AntonioMR/tessera-hw/README.md

<p align="center" width="100%">
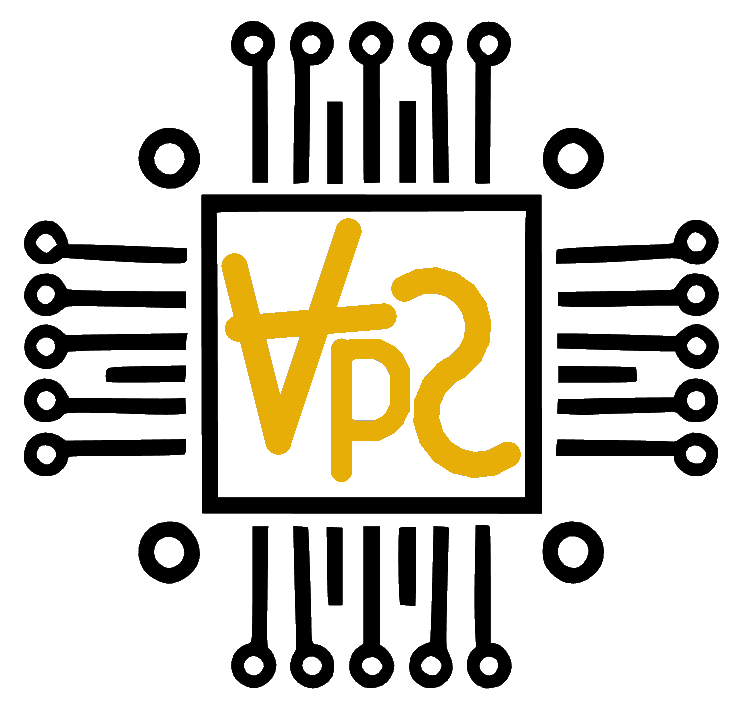
[picture p1: Logos/logo.png]
  
</p>

<h1 align="center">Tessera Badge</h1>

<p align="center" width="100%">
  <a href="https://github.com/AntonioMR/tessera-hw/actions/workflows/ci.yaml">
    
  </a>
</p>

<p align="center" width="100%">
    
</p>

***

<p align="center">
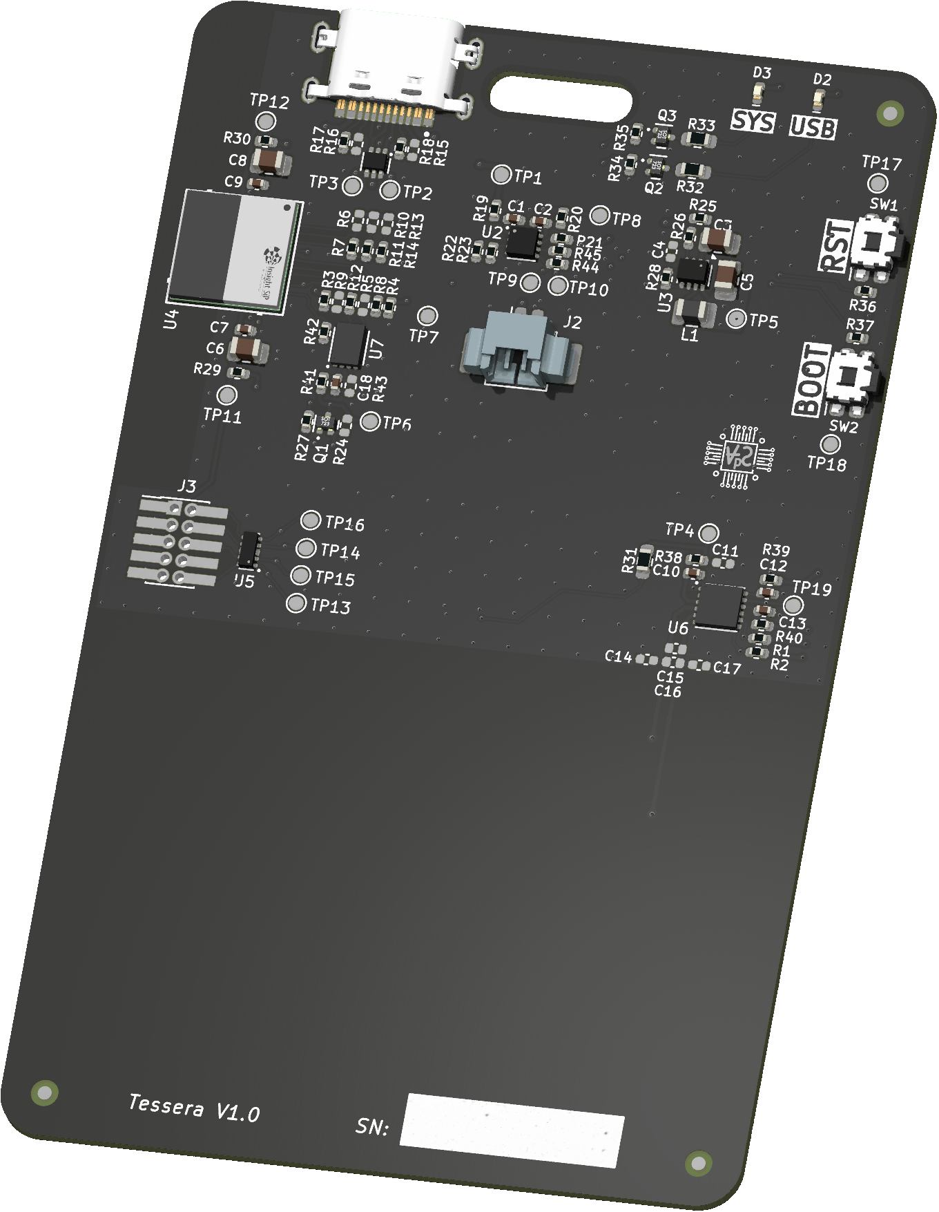
[picture p2: Images/tessera-angled_top.png]
3D Top Angled
  
&nbsp; &nbsp; &nbsp; &nbsp;
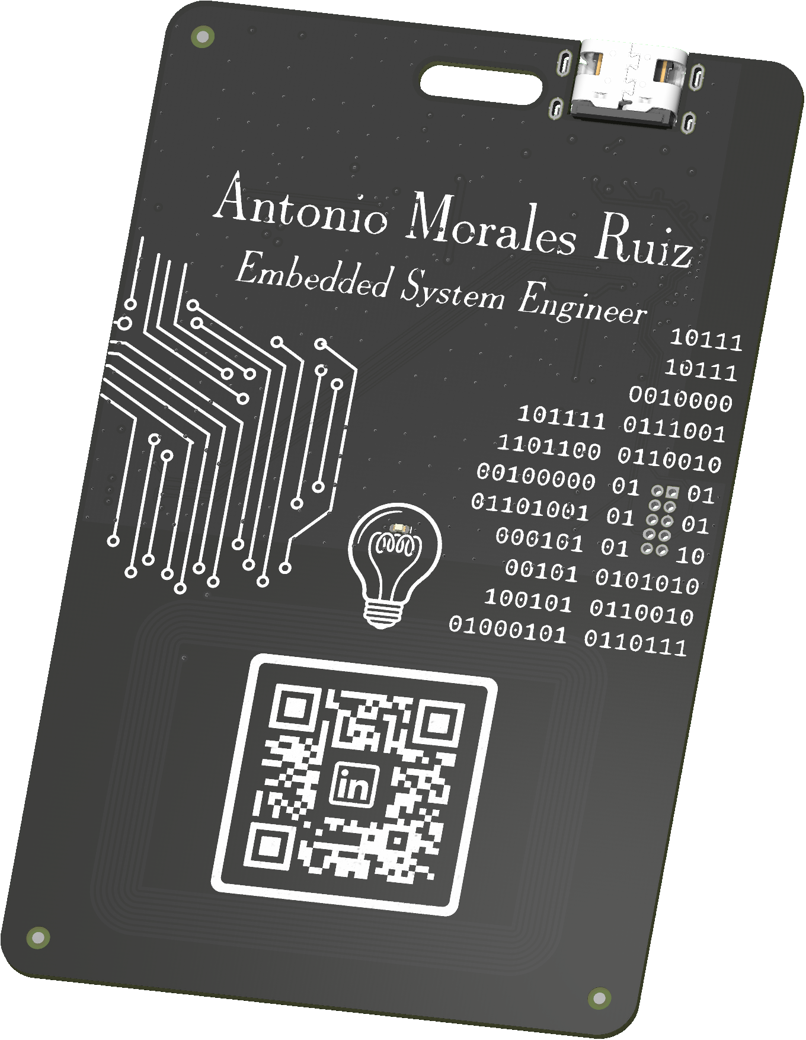
[picture p3: Images/tessera-angled_bottom.png]
3D Bottom Angled
  
</p>

***

## SPECIFICATIONS

| Parameter | Value | 
| --- | --- |
| Dimensions | 54.0 × 85.61 mm |

***

## DIRECTORY STRUCTURE

    .
    ├─ Computations       # Misc calculations
    ├─ HTML               # HTML files for generated webpage
    ├─ Images             # Pictures and renders
    │
    ├─ kibot_resources    # External resources for KiBot
    │  ├─ colors          # Color theme for KiCad
    │  ├─ fonts           # Fonts used in the project
    │  ├─ scripts         # External scripts used with KiBot
    │  └─ templates       # Templates for KiBot generated reports
    │
    ├─ kibot_yaml         # KiBot YAML config files
    ├─ KiRI               # KiRI (PCB diff viewer) files
    │
    ├─ lib                # KiCad footprint and symbol libraries
    │  ├─ lib_fp          # Footprint libraries
    │  ├─ lib_packages3d  # Component 3D models
    │  └─ lib_sym         # Symbol libraries
    │
    ├─ Logos              # Logos
    │
    ├─ Manufacturing      # Assembly and fabrication documents
    │  ├─ Assembly        # Assembly documents (BoM, pos, notes)
    │  │
    │  └─ Fabrication     # Fabrication documents (ZIP, notes)
    │     ├─ Drill Tables # CSV drill tables
    │     └─ Gerbers      # Gerbers
    │
    ├─ Report             # Reports for ERC/DRC
    ├─ Schematic          # PDF of schematic
    ├─ Templates          # Title block templates
    ├─ Testing
    │  └─ Testpoints      # Testpoints tables      
    │
    └─ Variants           # Outputs for assembly variants
