AntonioMR/tessera-hw/kibot_resources/templates/readme.txt

<p align="center" width="100%">
  
</p>

<h1 align="center">${BOARD_NAME}</h1>

<p align="center" width="100%">
  <a href="${GIT_URL}/actions/workflows/ci.yaml">
    CI Badge
  </a>
</p>

<p align="center" width="100%">
    
</p>

***

<p align="center">
  3D Top Angled
&nbsp; &nbsp; &nbsp; &nbsp;
  3D Bottom Angled
</p>

***

## SPECIFICATIONS

| Parameter | Value | 
| --- | --- |
| Dimensions | ${bb_w_mm} × ${bb_h_mm} mm |

***

## DIRECTORY STRUCTURE

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
