AntonioMR/tessera-hw/HTML/images/cat_pdf_drill_map_tessera-NPTH_drill_map.png

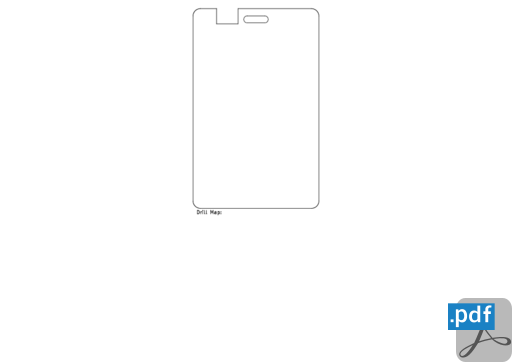
HTML/images/cat_pdf_drill_map_tessera-NPTH_drill_map.png
