AntonioMR/tessera-hw/HTML/images/cat_pdf_drill_map_tessera-PTH_drill_map.png

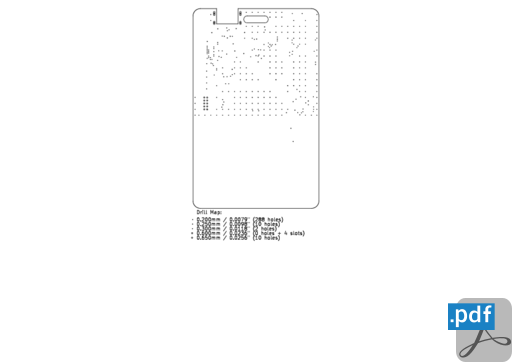
HTML/images/cat_pdf_drill_map_tessera-PTH_drill_map.png
