AntonioMR/tessera-hw/HTML/images/cat_pdf_schematic_tessera-schematic.png

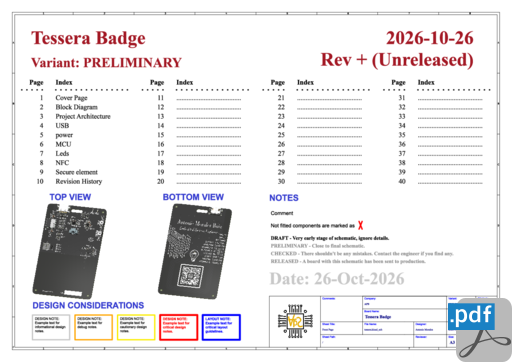
HTML/images/cat_pdf_schematic_tessera-schematic.png
