AntonioMR/tessera-hw/HTML/images/cat_png_3d_viewer_bottom_tessera-bottom.png

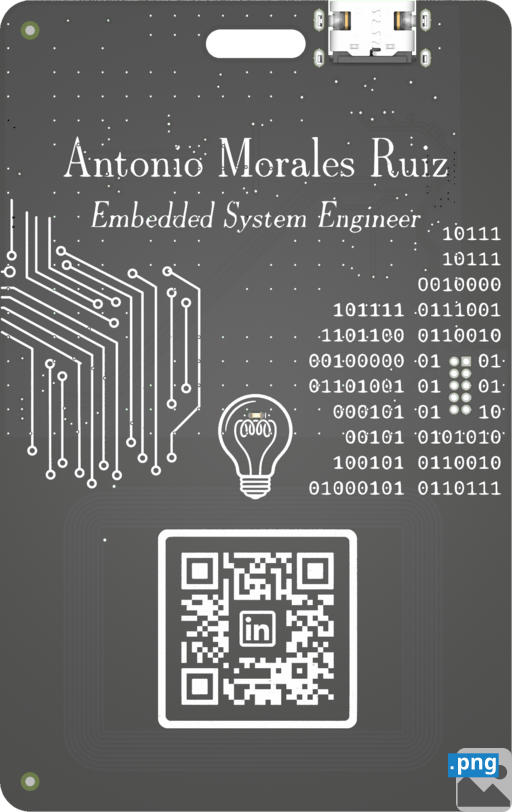
HTML/images/cat_png_3d_viewer_bottom_tessera-bottom.png
