AntonioMR/tessera-hw/HTML/images/cat_png_3d_viewer_top_tessera-top.png

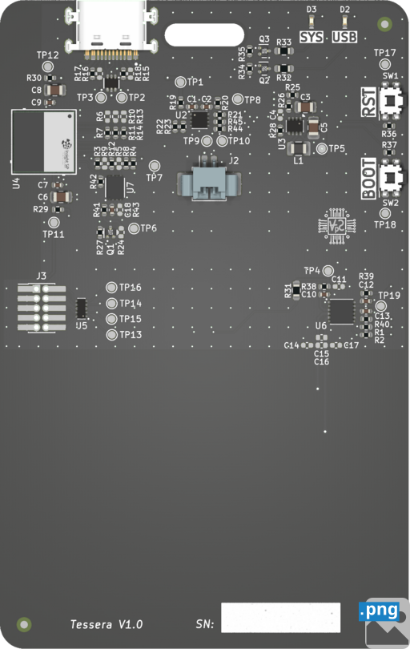
HTML/images/cat_png_3d_viewer_top_tessera-top.png
