AntonioMR/tessera-hw/Images/tessera-top.png

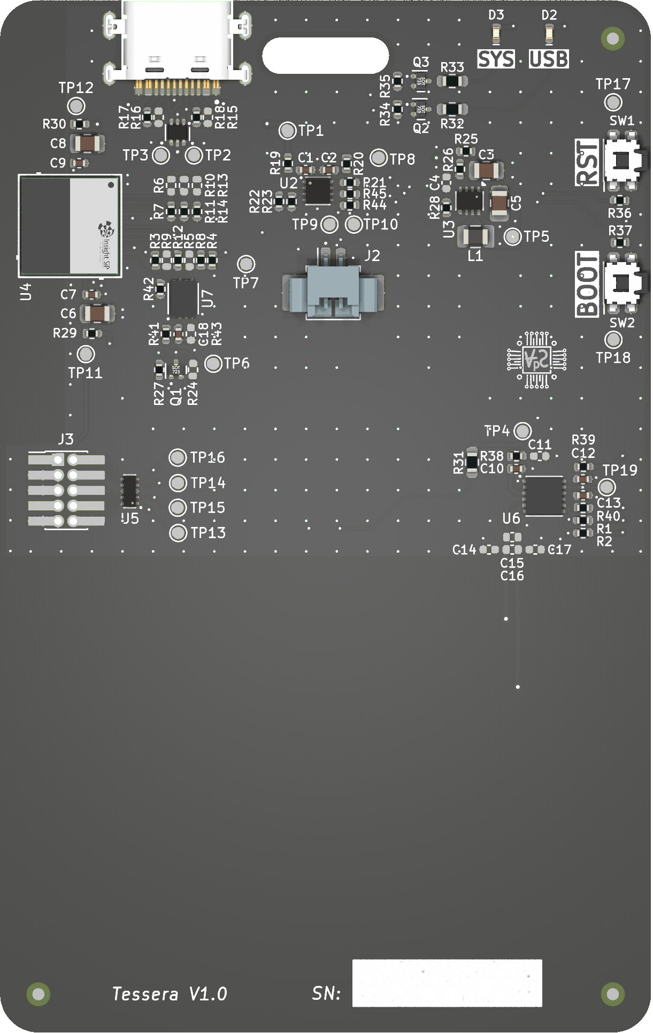
Images/tessera-top.png
