AntonioMR/tessera-hw/Manufacturing/Assembly/tessera-bom.csv

Row | Quantity Per PCB | IPN | References | Value | Datasheet | Footprint | Description | Manufacturer | Manufacturer Part Number | Supplier Part Number
1 | 5 | IPN_C-0001 | C7 C9 C12 C13 C18 | 100nF 16V (X7R) |  | C_0402_1005Metric | CAP CER 0.1UF 16V X7R 0402 | KEMET | C0402C104K4RACTU
2 | 1 | IPN_C-0002 | C10 | 10nF 16V (X7R) |  | C_0402_1005Metric | CAP CER 10000PF 16V X7R 0402 | KEMET | C0402C103K4RACTU
3 | 3 | IPN_C-0007 | C5 C6 C8 | 10uF 10V (X7R) |  | C_0805_2012Metric | CAP CER 10UF 10V X7R 0805 | KEMET | C0805C106K8RAC3123
4 | 2 | IPN_C-0008 | C1 C2 | 1uF 6.3V (X5R) |  | C_0402_1005Metric | CAP CER 1UF 6.3V X5R 0402 | KEMET | C0402C105K9PACTU
5 | 1 | IPN_C-0006 | C3 | 4.7uF 6.3V (X7R) |  | C_0805_2012Metric | CAP CER 4.7UF 6.3V X7R 0805 | KEMET | C0805C475K9RACTU
6 | 3 | IPN_D-0001 | D1 D2 D3 | APHHS1005SURCK | http://www.kingbrightusa.com/images/catalog/spec/aphhs1005surck.pdf | LED_0402_1005Metric | Hyper Red (AlGaInP) 0402 SMD chip LED | Kingbright | APHHS1005SURCK
7 | 1 | IPN_J-0001 | J2 | 532610271 | https://www.molex.com/content/dam/molex/molex-dot-com/products/automated/en-us/salesdrawingpdf/532/53261/532610271_sd.pdf | Molex_PicoBlade_53261-0271_1x02-1MP_P1.25mm_Horizontal | Molex_PicoBlade_53261-0271_1x02-1MP_P1.25mm_Horizontal | Molex | 532610271
8 | 1 | IPN_J-0003 | J1 | USB-C | https://gct.co/files/specs/usb4520-spec.pdf | GCT_USB4520-03-1-A_REVA | USB C REC 16P 3U MID MNT 2.1MM | GCT | USB4520-03-1-A
9 | 1 | IPN_L-0001 | L1 | 2.2uH | https://pim.murata.com/asset/pim4/inductor/J(E)TE243A-0006_PDF_INDUCTOR | L_0806_2016Metric | FIXED IND 2.2UH 1.8A 116 MOHM | Murata Electronics | DFE201612E-2R2M=P2
10 | 2 | IPN_Q-0001 | Q2 Q3 | NTK3134N | https://www.onsemi.com/pdf/datasheet/ntk3134n-d.pdf | SOT-723 | small-signal N-channel MOSFET with integrated ESD protection | onsemi | NTK3134N
11 | 1 | IPN_Q-0002 | Q1 | NTK3139P | https://www.onsemi.com/pdf/datasheet/ntk3139p-d.pdf | SOT-723 | small-signal P-channel MOSFET with integrated ESD protection | onsemi | NTK3139P
12 | 3 | IPN_R-0008 | R31 R32 R33 | 330R ±1% 1/10W |  | R_0603_1608Metric | RES 330 OHM 1% 1/10W 0603 | YAGEO | RT0603FRE07330RL
13 | 2 | IPN_R-0003 | R17 R18 | 5.1 kOhms |  | R_0402_1005Metric | RES 5.1K OHM 1% 1/16W 0402 | YAGEO | RT0402FRE075K1L
14 | 5 | IPN_R-0002 | R1 R2 R3 R4 R23 | 10 kOhms |  | R_0402_1005Metric | RES 10K OHM 1% 1/16W 0402 | YAGEO | AT0402FRD0710KL
15 | 1 | IPN_R-0004 | R21 | 27 kOhms |  | R_0402_1005Metric | RES 27K OHM 1% 1/16W 0402 | YAGEO | RT0402FRE0727KL
16 | 1 | IPN_R-0005 | R22 | 30 kOhms |  | R_0402_1005Metric | RES 30K OHM 1% 1/16W 0402 | YAGEO | RT0402FRE0730KL
17 | 1 | IPN_R-0006 | R28 | 52.3 kOhms |  | R_0402_1005Metric | RES 52.3K OHM 1% 1/16W 0402 | YAGEO | RT0402FRE0752K3L
18 | 4 | IPN_R-0001 | R27 R42 R44 R45 | 100 kOhms |  | R_0402_1005Metric | RES 100K OHM 1% 1/16W 0402 | YAGEO | RP0402FRE07100KL
19 | 7 | IPN_R-0009 | R7 R11 R14 R34 R35 R36 R37 | 510 kOhms |  | R_0402_1005Metric | RES 510K OHM 1% 1/16W 0402 | YAGEO | RC0402FR-13510KL
20 | 12 | IPN_R-0010 | R8 R12 R19 R20 R25 R26 R29 R30 R38 R39 R40 R41 | 0R ±5% 1/16W |  | R_0402_1005Metric | RES 0 OHM JUMPER 1/16W 0402 | YAGEO | RC0402FR-070RL
21 | 2 | IPN_SW-0001 | SW1 SW2 | EVQP7A01P | https://www.tti.com/content/dam/tti-commons/supplier/panasonic/ecom/panasonic-3529s-side-series-datasheet.pdf | Panasonic_switch_EVQP7K_EVQP7A | Side-actuated SMD tactile switch | Panasonic | EVQP7A01P
22 | 1 | IPN_U-0003 | U2 | BQ25170J | https://www.ti.com/lit/gpn/BQ25170J | WSON-8-1EP_2x2mm_P0.5mm_EP0.9x1.6mm | 800 mA linear battery charger for 1-cell | Texas Instruments | BQ25170J
23 | 1 | IPN_D-0003 | U5 | D3V3XA4B10LP | https://www.diodes.com/assets/Datasheets/D3V3XA4B10LP.pdf | Diodes_UDFN-10_1.0x2.5mm_P0.5mm | 4 Channel Low Capacitance TVS Diode Array | Diodes | D3V3XA4B10LP
24 | 1 | IPN_U-0005 | U4 | ISP1807-LR-RS | https://www.insightsip.com/fichiers_insightsip/pdf/ble/ISP1807/isp_ble_DS1807.pdf | ISP1807-LR | Insight SiP ISP1807-LR nRF52840 BLE module | Insight SiP | ISP1807-LR
25 | 1 | IPN_U-0002 | U6 | ST25DV64KC-JF6D3 | https://www.st.com/resource/en/datasheet/st25dv64kc.pdf | ST_UFDFPN-12-1EP_3x3mm_P0.5mm_EP1.4x2.55mm | STMicroelectronics ST25DV64KC-JF6D3 -- dynamic NFC/RFID tag IC, 64-Kbit EEPROM, dual I2C / RF interface, energy harvesting | STMicroelectronics | ST25DV64KC-JF6D3
26 | 1 | IPN_U-0001 | U7 | STSAFA120DFSPL05 | https://www.st.com/resource/en/datasheet/stsafe-a120.pdf | ST_UFDFPN-8-1EP_2x3mm_P0.5mm_EP1.4x2.55mm | STMicroelectronics STSAFE-A120 -- secure authentication companion IC, I2C, 16 kB NVM, hashing/encryption/decryption crypto services | STMicroelectronics | STSAFA120DFSPL05
27 | 1 | IPN_U-0004 | U3 | TPS62840DLCR | https://www.ti.com/lit/gpn/TPS62840 | Texas_VSON-HR-8_1.5x2mm_P0.5mm | 750 mA IOUT, VSET-selectable output synchronous buck converter | Texas Instruments | TPS62840DLCR
28 | 1 | IPN_D-0002 | U1 | USBLC6-2P6 | https://www.st.com/resource/en/datasheet/usblc6-2.pdf | SOT-666 | Very low capacitance ESD protection array, 2 data lines + VBUS clamp, SOT-666 | STMicroelectronics | USBLC6-2P6
