AntonioMR/tessera-hw/Testing/Testpoints/tessera-testpoints-top.csv

Ref. | Net | X [mm] | Y [mm]
TP1 | VBUS | 20.68 | 71.60
TP2 | D- | 12.90 | 69.55
TP3 | D+ | 10.16 | 69.55
TP4 | VCC_EH | 40.17 | 46.70
TP5 | VCC | 39.34 | 62.81
TP6 | VCC_SEC | 14.52 | 52.28
TP7 | GND | 17.23 | 60.54
TP8 | VSYS | 28.23 | 69.37
TP9 | CHG_STAT | 24.14 | 63.82
TP10 | CHG_PG | 26.17 | 63.82
TP11 | VCC_nRF | 3.94 | 53.08
TP12 | VBUS_nRF | 3.14 | 73.65
TP13 | RST_PB | 11.60 | 38.24
TP14 | SWDCLK | 11.59 | 42.38
TP15 | SWDO | 11.56 | 40.34
TP16 | SWDIO | 11.56 | 44.49
TP17 | RST_PB | 47.68 | 73.96
TP18 | USR_PB | 47.70 | 54.27
TP19 | NFC_INT | 47.16 | 42.04
