AntonioMR/tessera-hw/3D/tessera.step

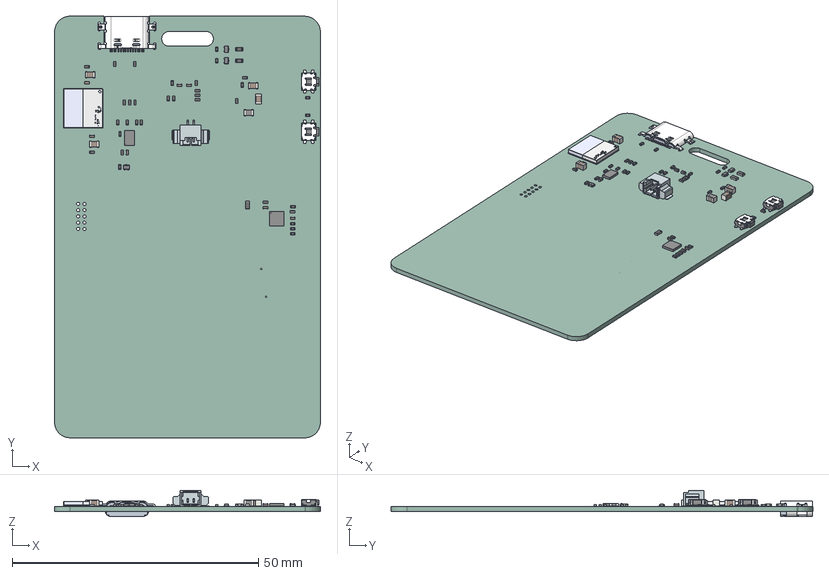
[picture p10: CAD file, 2026-10-26]
3D/tessera.step
54.0 x 85.6 x 5.30 mm
7095E2CA-307A-46B5-9DE8-1FEC977057C4 x 3
L_0805_2012Metric
EVQ-P7A01P x 2
C_0402_1005Metric x 8
R_0402_1005Metric x 33
532610271wbm000_03
F85B63AA-285C-4839-AD42-7CBB6340DD53
C_0805_2012Metric x 4
R_0603_1608Metric x 3
ST25DV64KC-JF6D3
USB4520-03-0-A
ISP1807-LR-RS
kibot_r0vd6m8w_PCB
