AntonioMR/tessera-hw/Manufacturing/Fabrication/tessera-fabrication.pdf

# Top Fabrication (Scale 1:1)

# Tessera Badge Fabrication Document

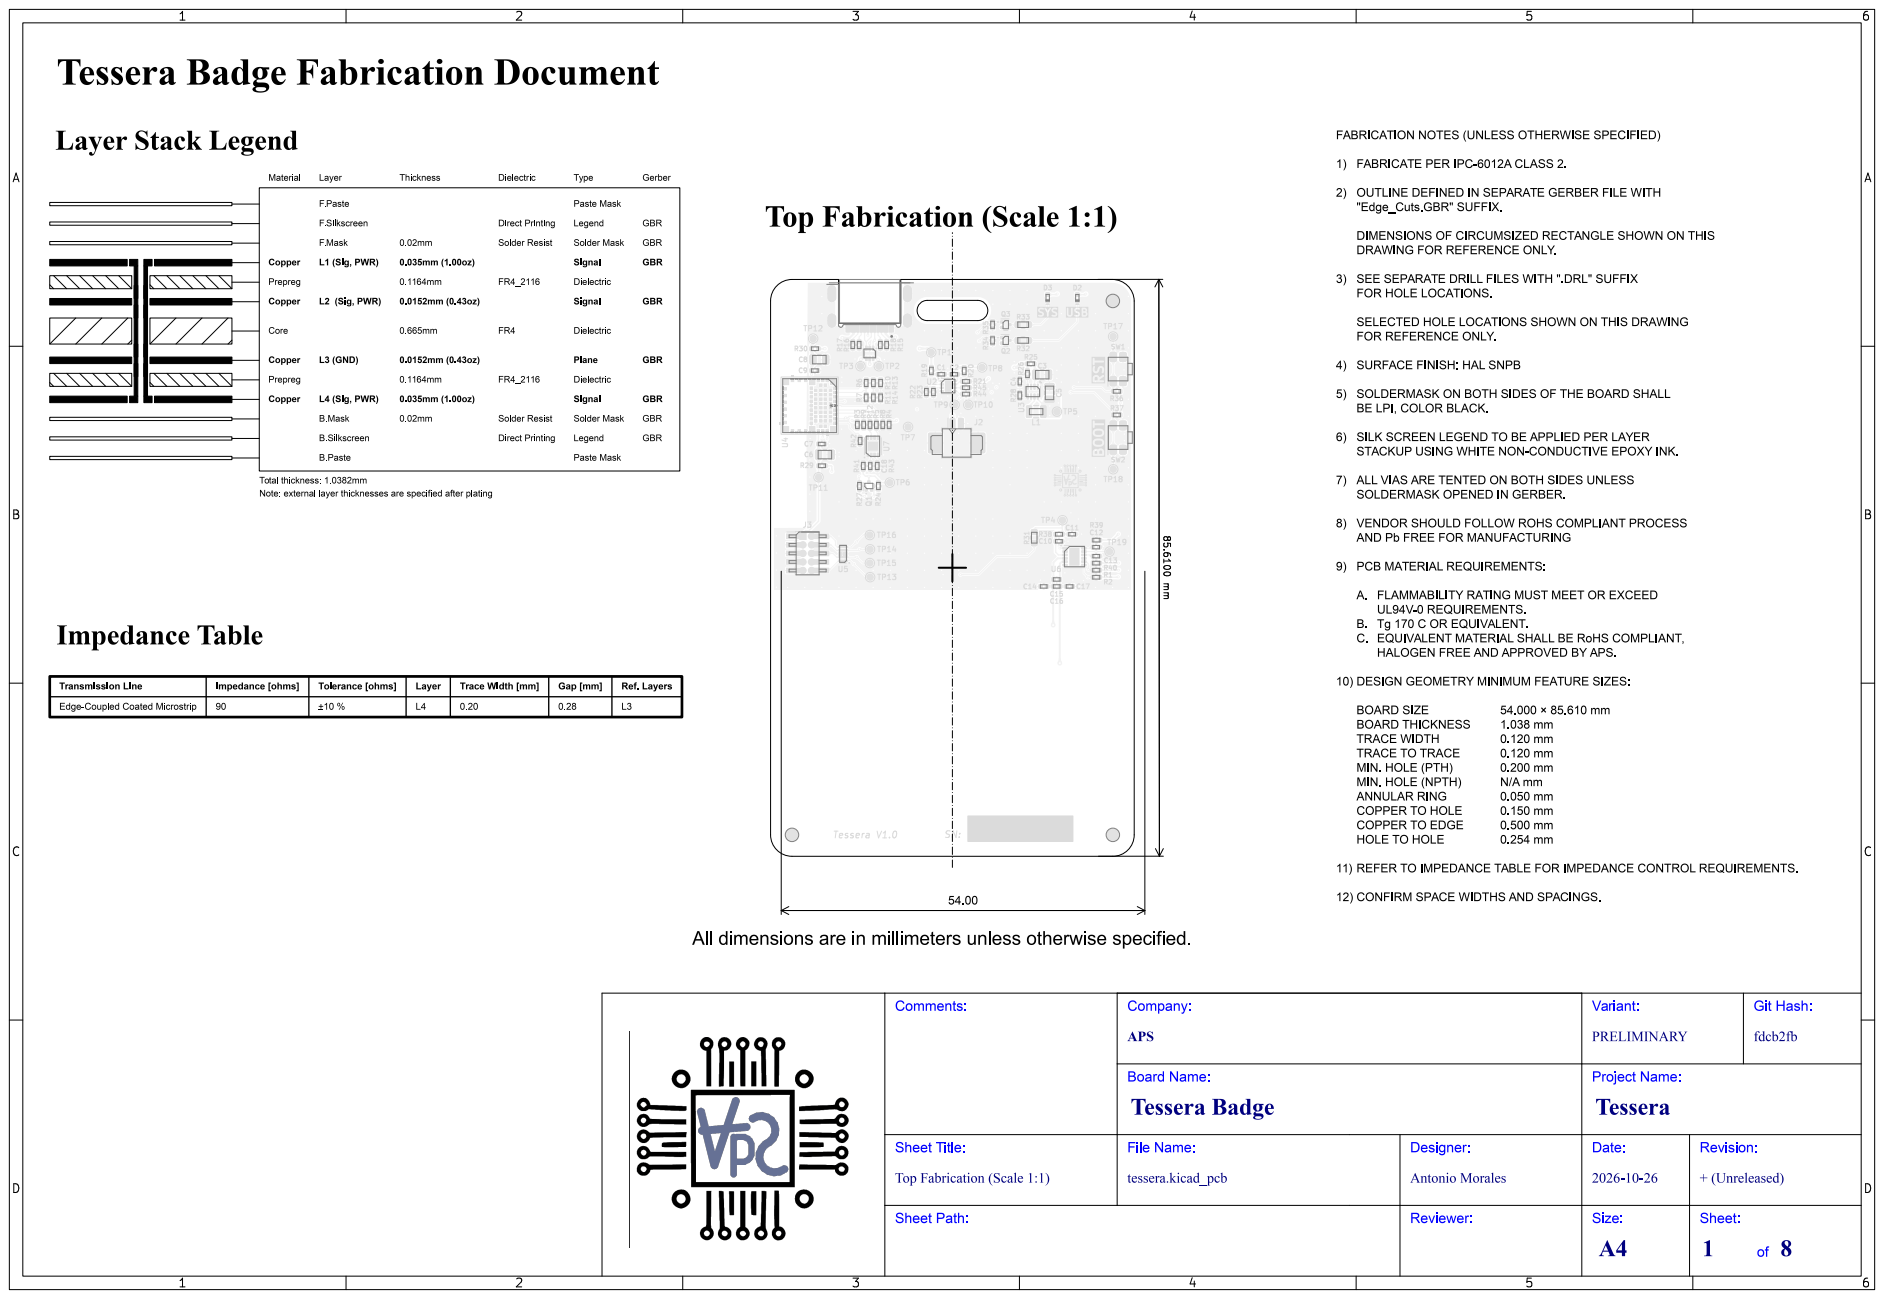
[picture p11: page 1]

# Bottom Fabrication (Scale 1:1)

# Tessera Badge Fabrication Document

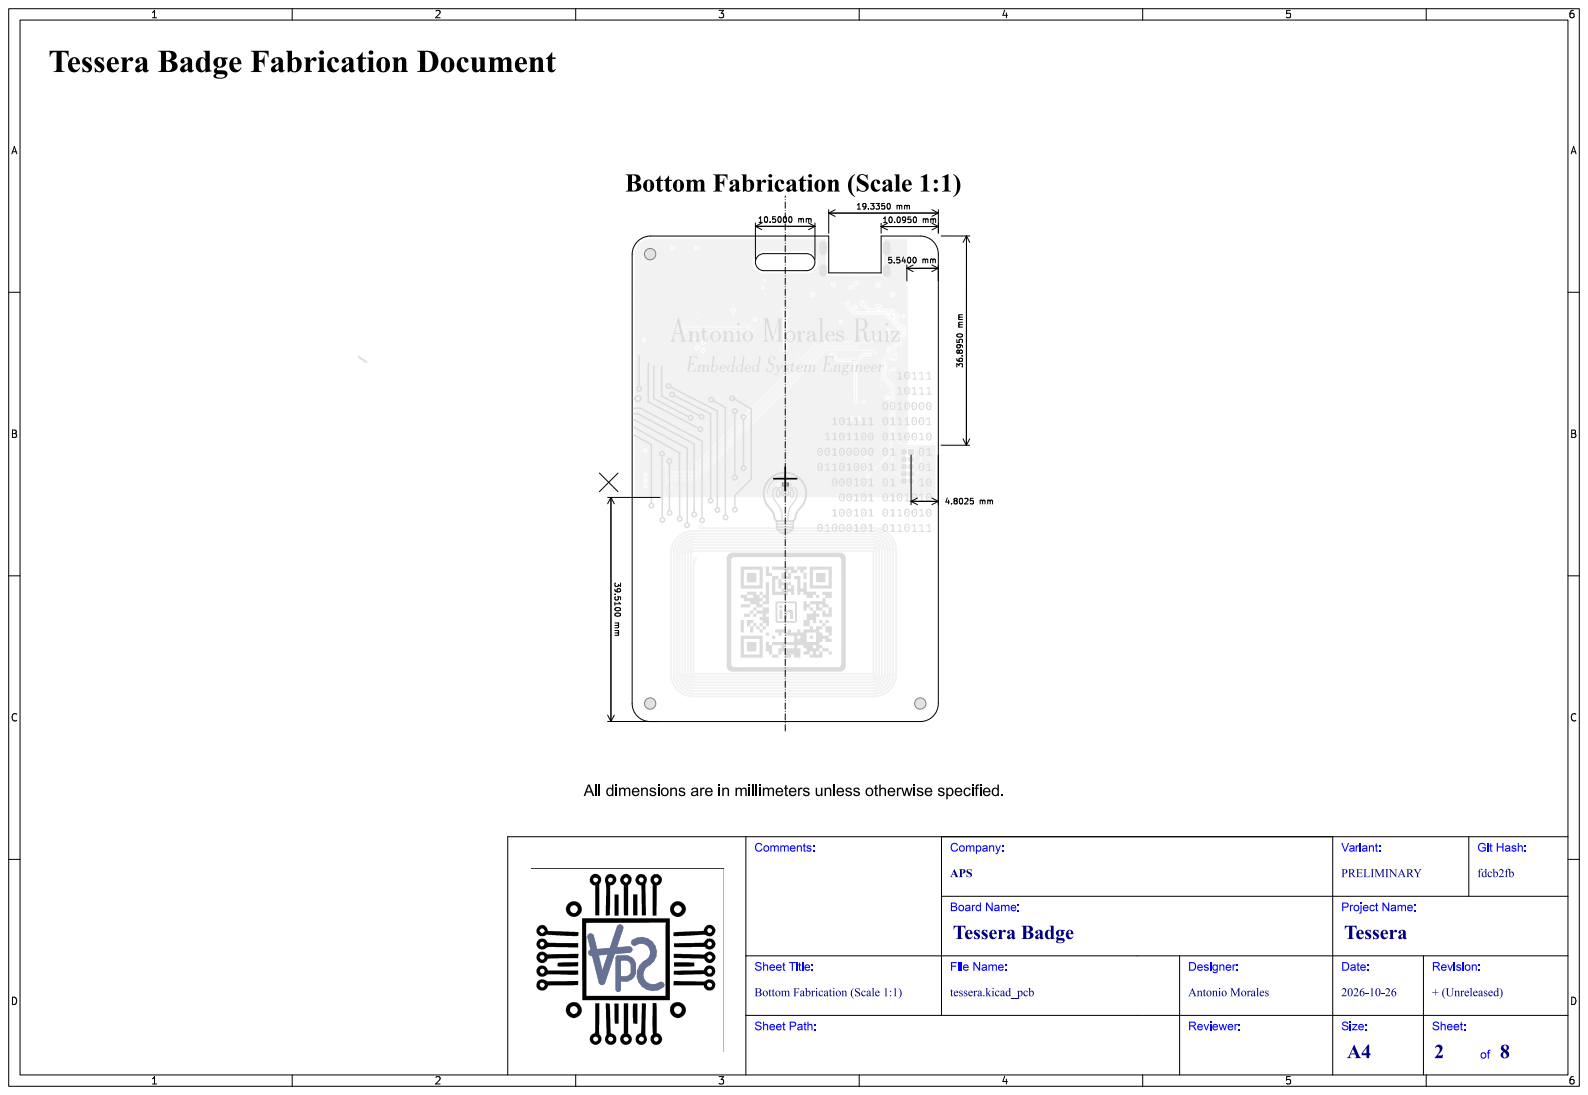
[picture p12: page 2]
Git; Hash:; fdcb2fb; Comments:; Sheet Path:; Sheet Title:; File Name:; Tessera Badge; Tessera; APS; Company:; PRELIMINARY; Variant:; Board Name:; tessera.kicad_pcb; Antonio Morales; Designer:; Reviewer:; Project Name:; Date:; + (Unreleased); Revision:; Size:; Sheet:

Bottom Fabrication (Scale 1:1)

# Drill Drawing L1 - L4 (Scale 1:1)

# Tessera Badge Fabrication Document

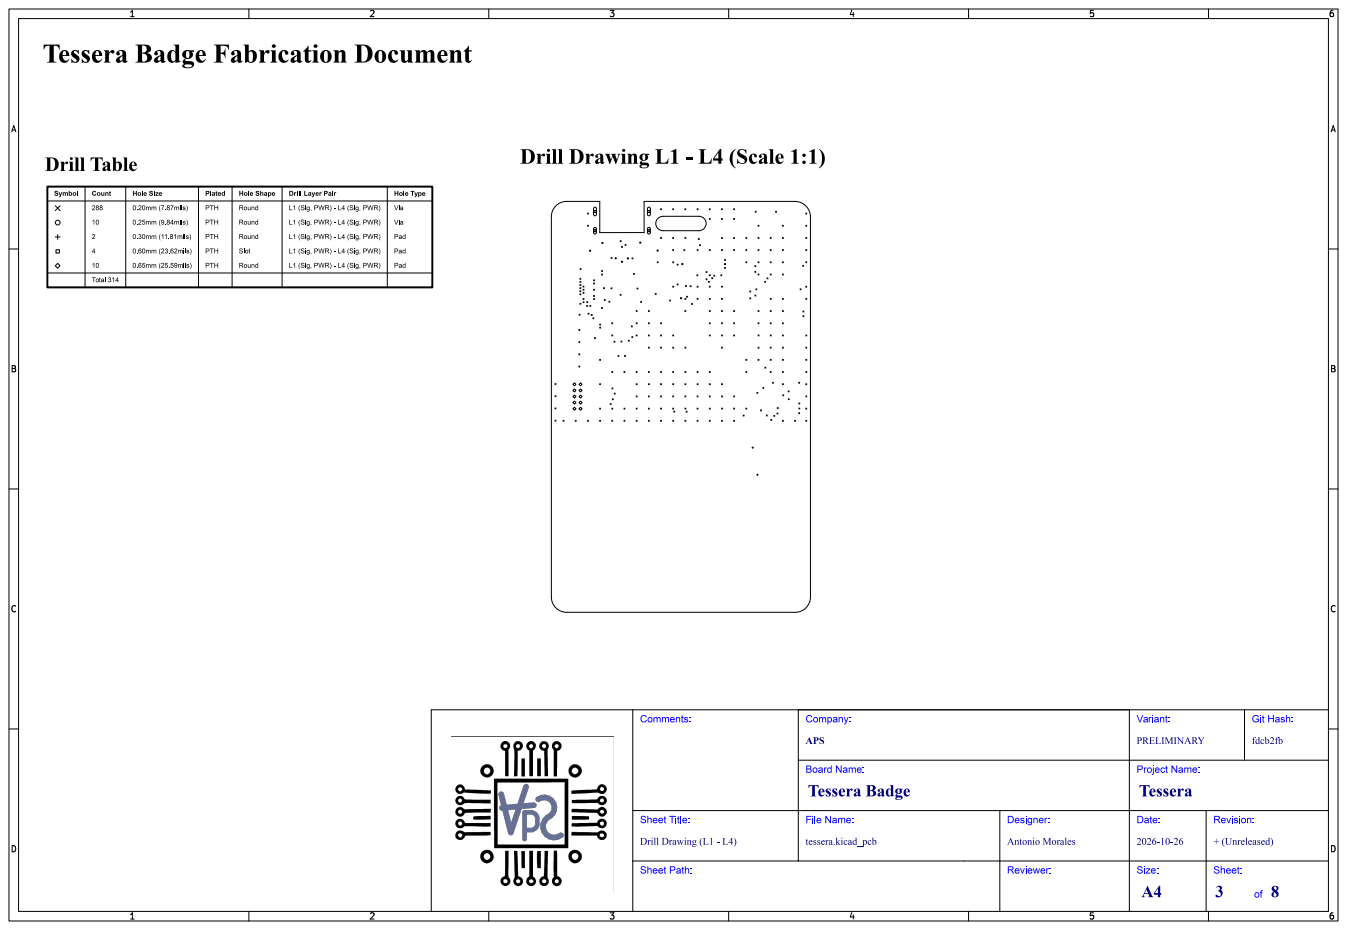
[picture p13: page 3]
Git; Hash:; fdcb2fb; Comments:; Drill Drawing (L1 - L4); Sheet Path:; Sheet Title:; File Name:; Tessera Badge; Tessera; APS; Company:; PRELIMINARY; Variant:; Board Name:; tessera.kicad_pcb; Antonio Morales; Designer:; Reviewer:; Project Name:; Date:; + (Unreleased); Revision:; Size:; Sheet:

# Top Test Points (Scale 1:1)

# Tessera Badge Fabrication Document

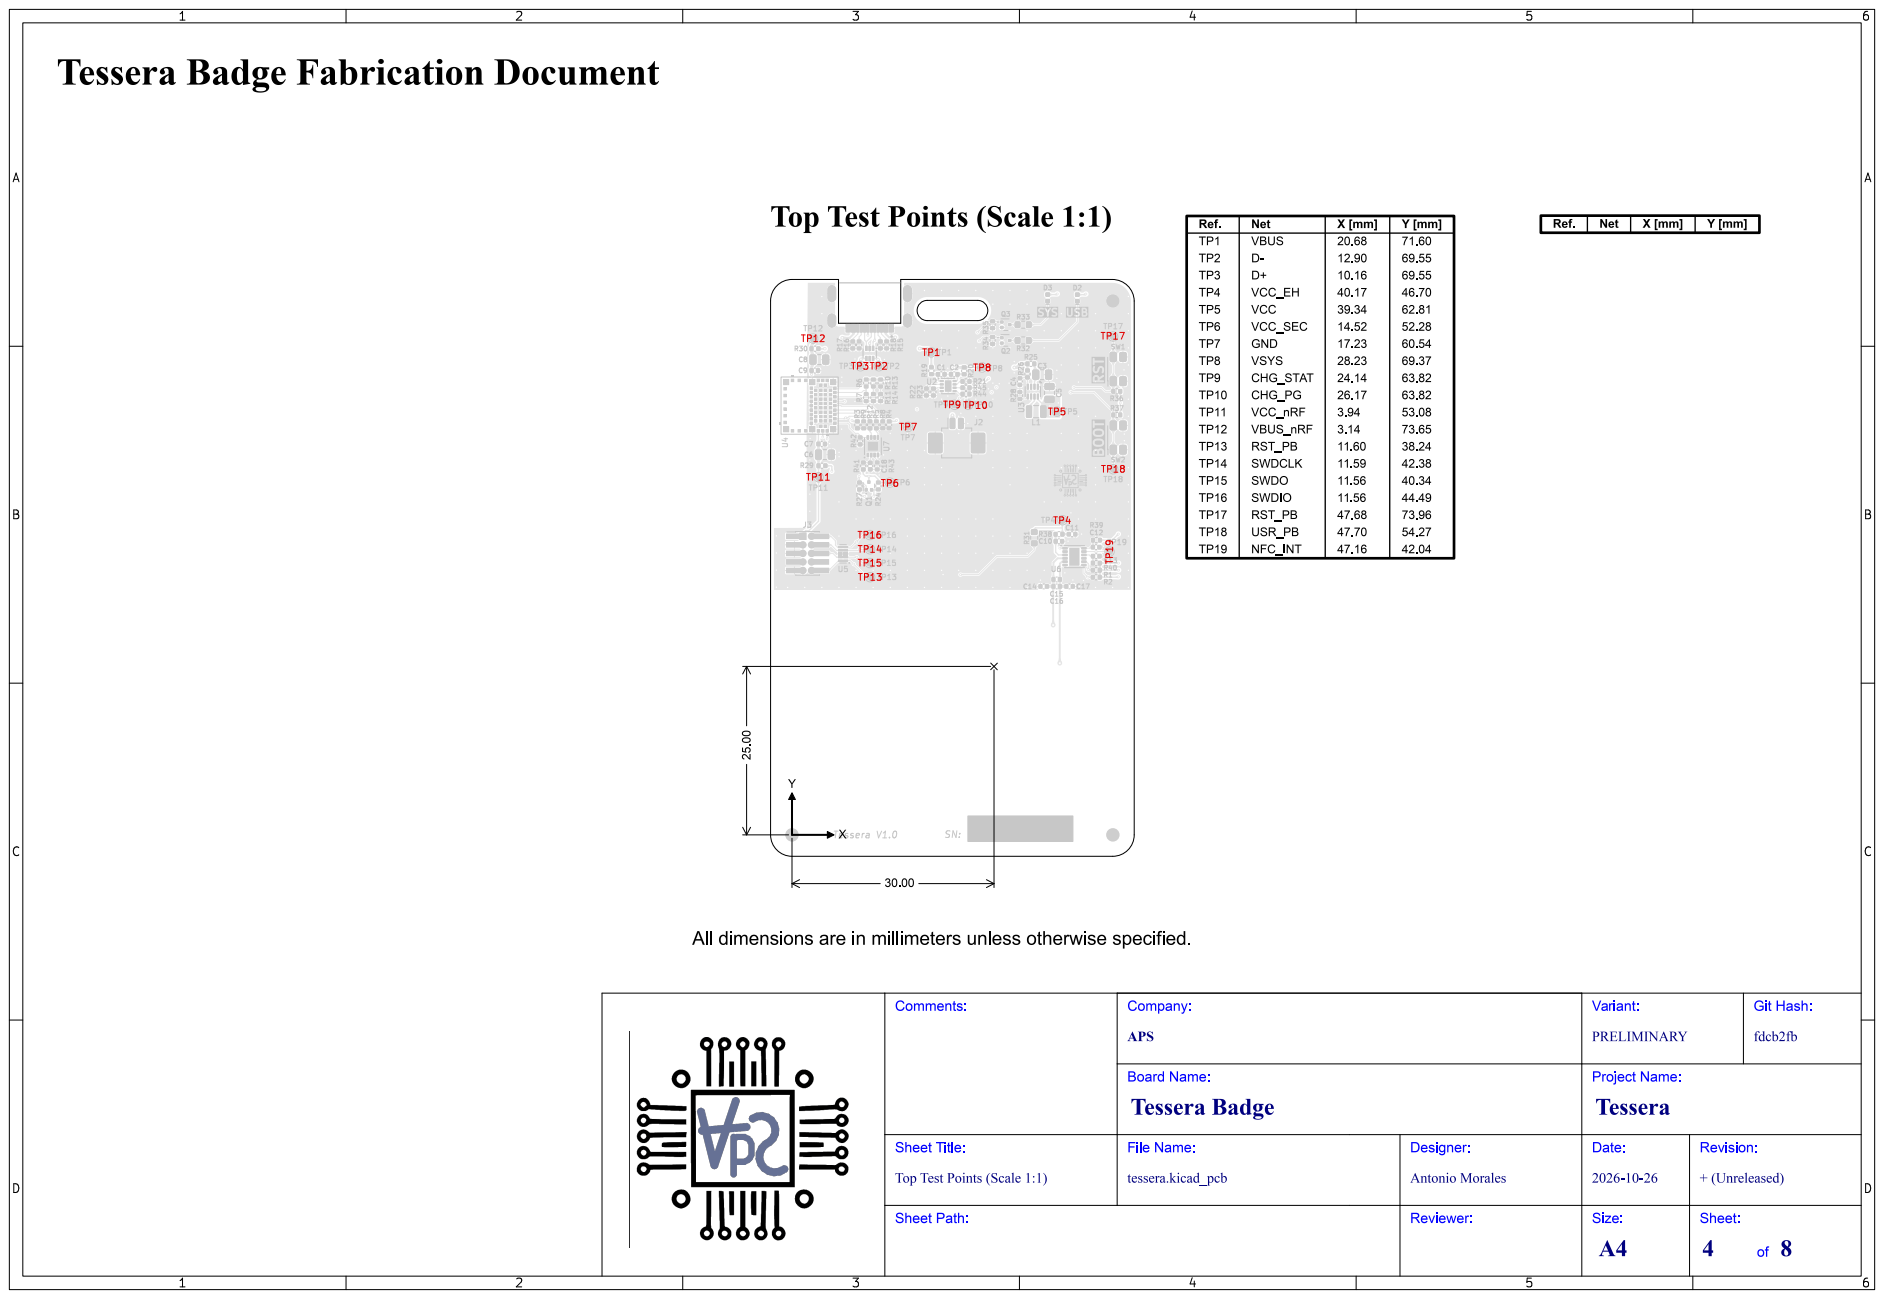
[picture p14: page 4]

Top Test Points (Scale 1:1)

# L1 (Sig, PWR) (Scale 1:1)

# Tessera Badge Fabrication Document

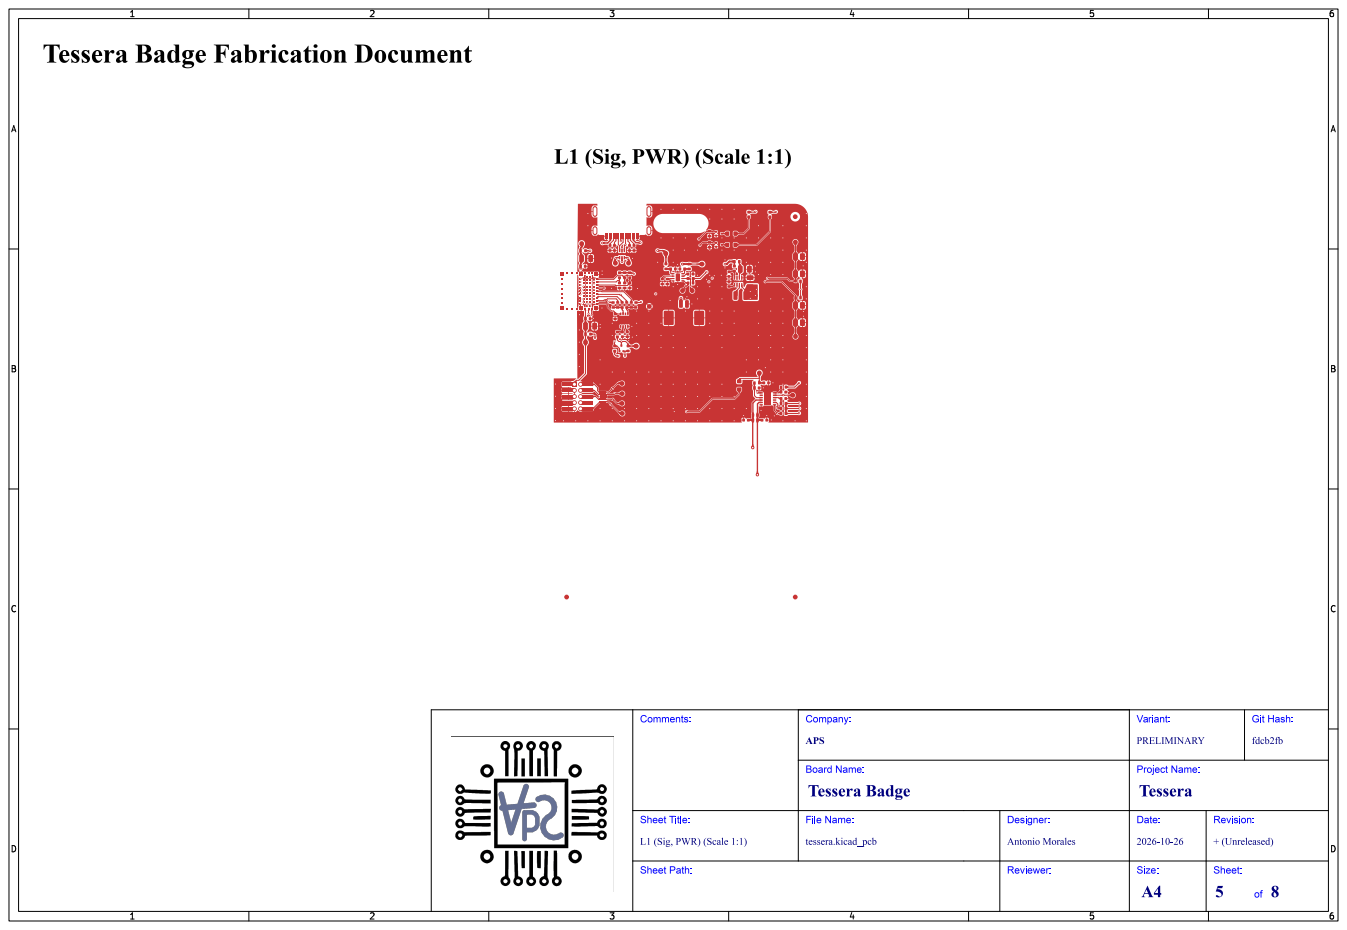
[picture p15: page 5]
Git; Hash:; fdcb2fb; Comments:; Sheet Path:; Sheet Title:; File Name:; Tessera Badge; Tessera; APS; Company:; PRELIMINARY; Variant:; Board Name:; tessera.kicad_pcb; Antonio Morales; Designer:; Reviewer:; Project Name:; Date:; + (Unreleased); Revision:; Size:; Sheet:

L1 (Sig, PWR) (Scale 1:1)

# L2 (Sig, PWR) (Scale 1:1)

# Tessera Badge Fabrication Document

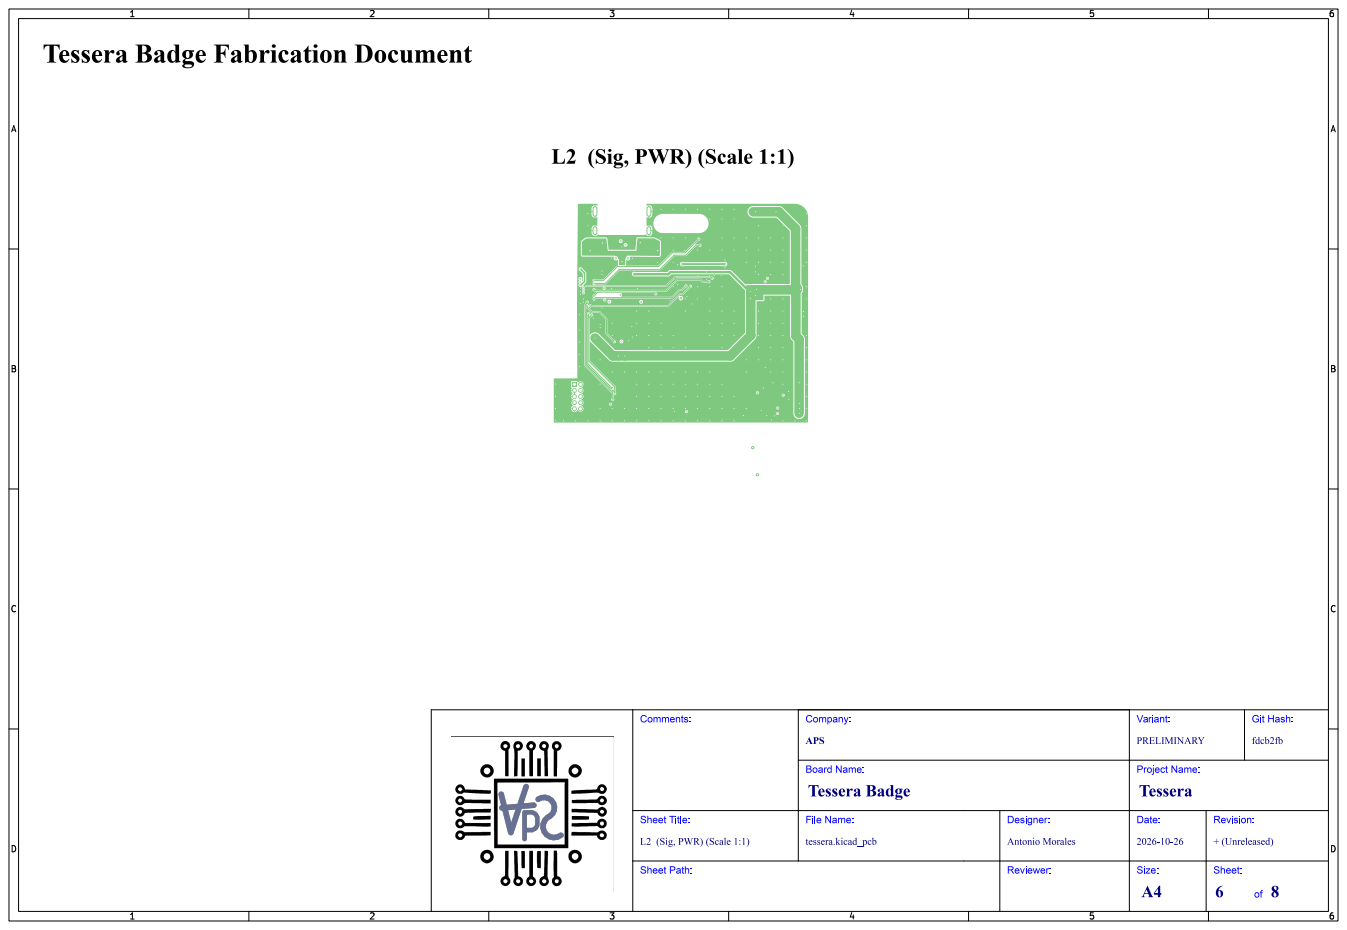
[picture p16: page 6]
Git; Hash:; fdcb2fb; Comments:; Sheet Path:; Sheet Title:; File Name:; Tessera Badge; Tessera; APS; Company:; PRELIMINARY; Variant:; Board Name:; tessera.kicad_pcb; Antonio Morales; Designer:; Reviewer:; Project Name:; Date:; + (Unreleased); Revision:; Size:; Sheet:

L2 (Sig, PWR) (Scale 1:1)

# L3 (GND) (Scale 1:1)

# Tessera Badge Fabrication Document

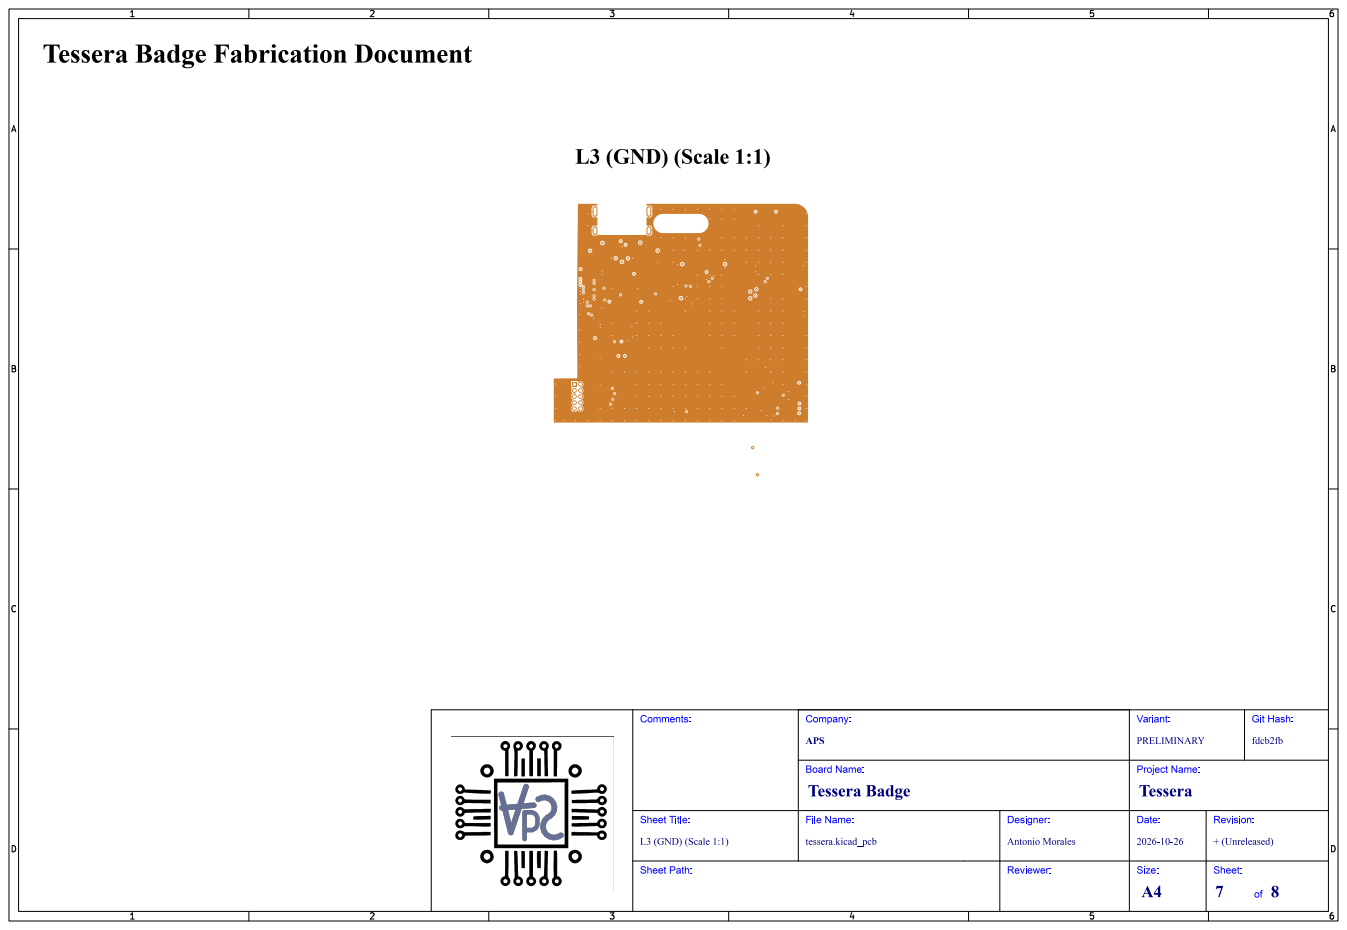
[picture p17: page 7]
Git; Hash:; fdcb2fb; Comments:; L3 (GND) (Scale 1:1); Sheet Path:; Sheet Title:; File Name:; Tessera Badge; Tessera; APS; Company:; PRELIMINARY; Variant:; Board Name:; tessera.kicad_pcb; Antonio Morales; Designer:; Reviewer:; Project Name:; Date:; + (Unreleased); Revision:; Size:; Sheet:

# L4 (Sig, PWR) (Scale 1:1)

# Tessera Badge Fabrication Document

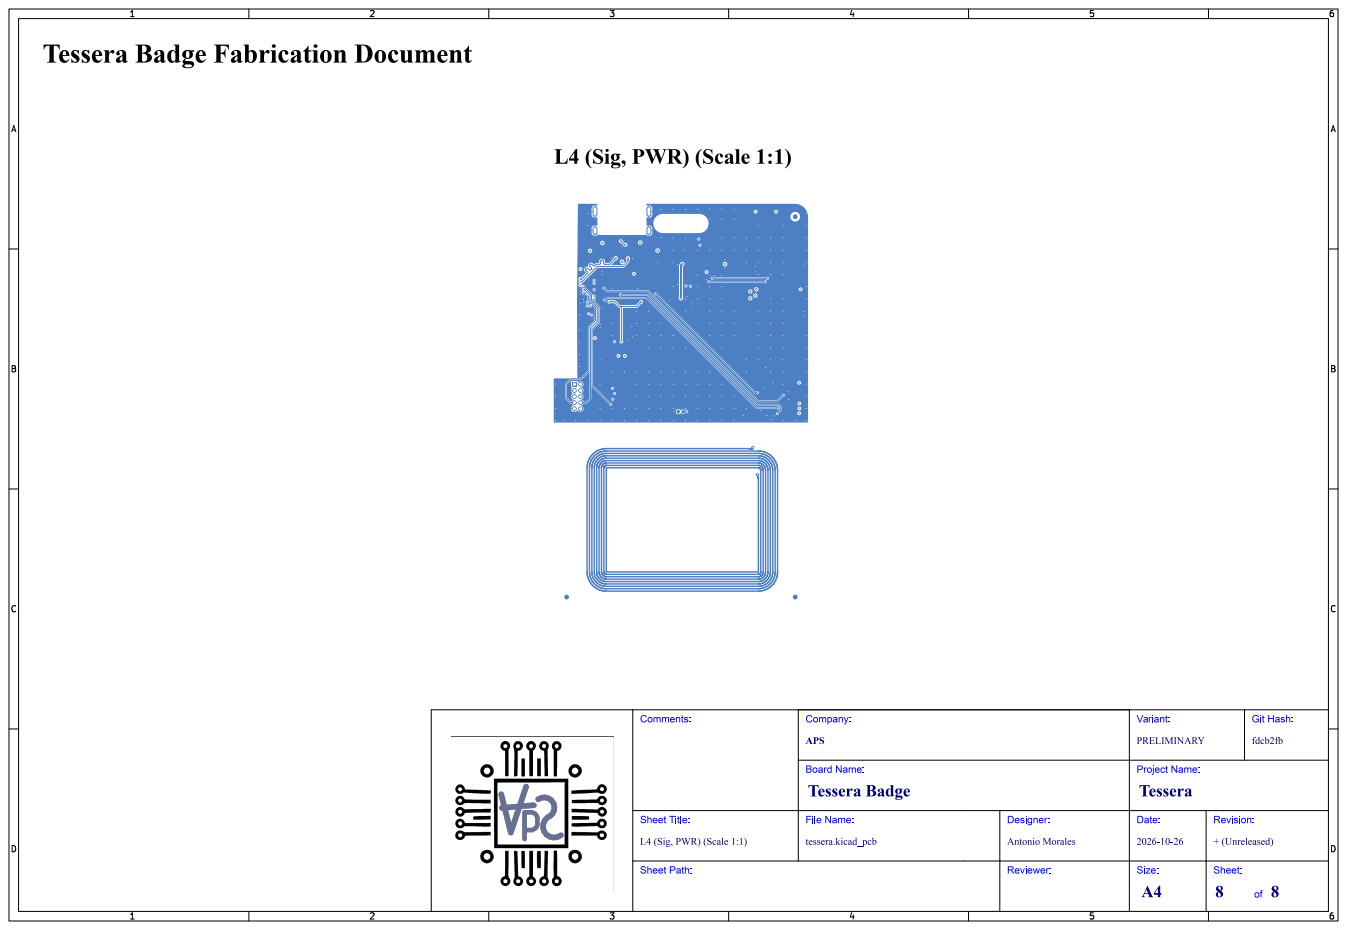
[picture p18: page 8]
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

L4 (Sig, PWR) (Scale 1:1)
