AntonioMR/tessera-hw/Manufacturing/Fabrication/tessera-impedance_table.csv

Transmission Line | Impedance [ohms] | Tolerance [ohms] | Layer | Trace Width [mm] | Gap [mm] | Ref. Layers
Edge-Coupled Coated Microstrip | 90 | ±10 % | L4 | 0.20 | 0.28 | L3
