AntonioMR/tessera-hw/Manufacturing/Fabrication/Drill Tables/tessera-(L1-L4)_drill_table.csv

Count | Hole Size | Plated | Hole Shape | Drill Layer Pair | Hole Type
288 | 0.20mm (7.87mils) | PTH | Round | L1 (Sig, PWR) - L4 (Sig, PWR) | Via
10 | 0.25mm (9.84mils) | PTH | Round | L1 (Sig, PWR) - L4 (Sig, PWR) | Via
2 | 0.30mm (11.81mils) | PTH | Round | L1 (Sig, PWR) - L4 (Sig, PWR) | Pad
4 | 0.60mm (23.62mils) | PTH | Slot | L1 (Sig, PWR) - L4 (Sig, PWR) | Pad
10 | 0.65mm (25.59mils) | PTH | Round | L1 (Sig, PWR) - L4 (Sig, PWR) | Pad
Total 314
