AntonioMR/tessera-hw/HTML/images/cat_pdf_fabrication_tessera-fabrication.png

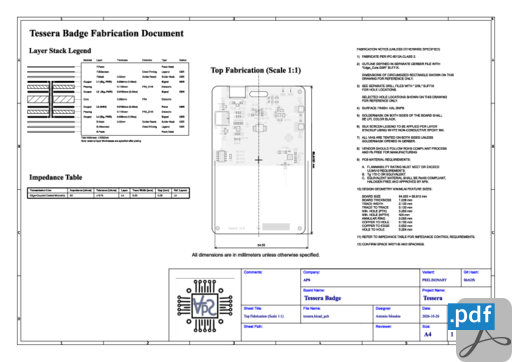
HTML/images/cat_pdf_fabrication_tessera-fabrication.png
