AntonioMR/tessera-hw/Schematic/tessera-schematic-1.pdf

# TesseraBadge

# Variant:PRELIMINARY

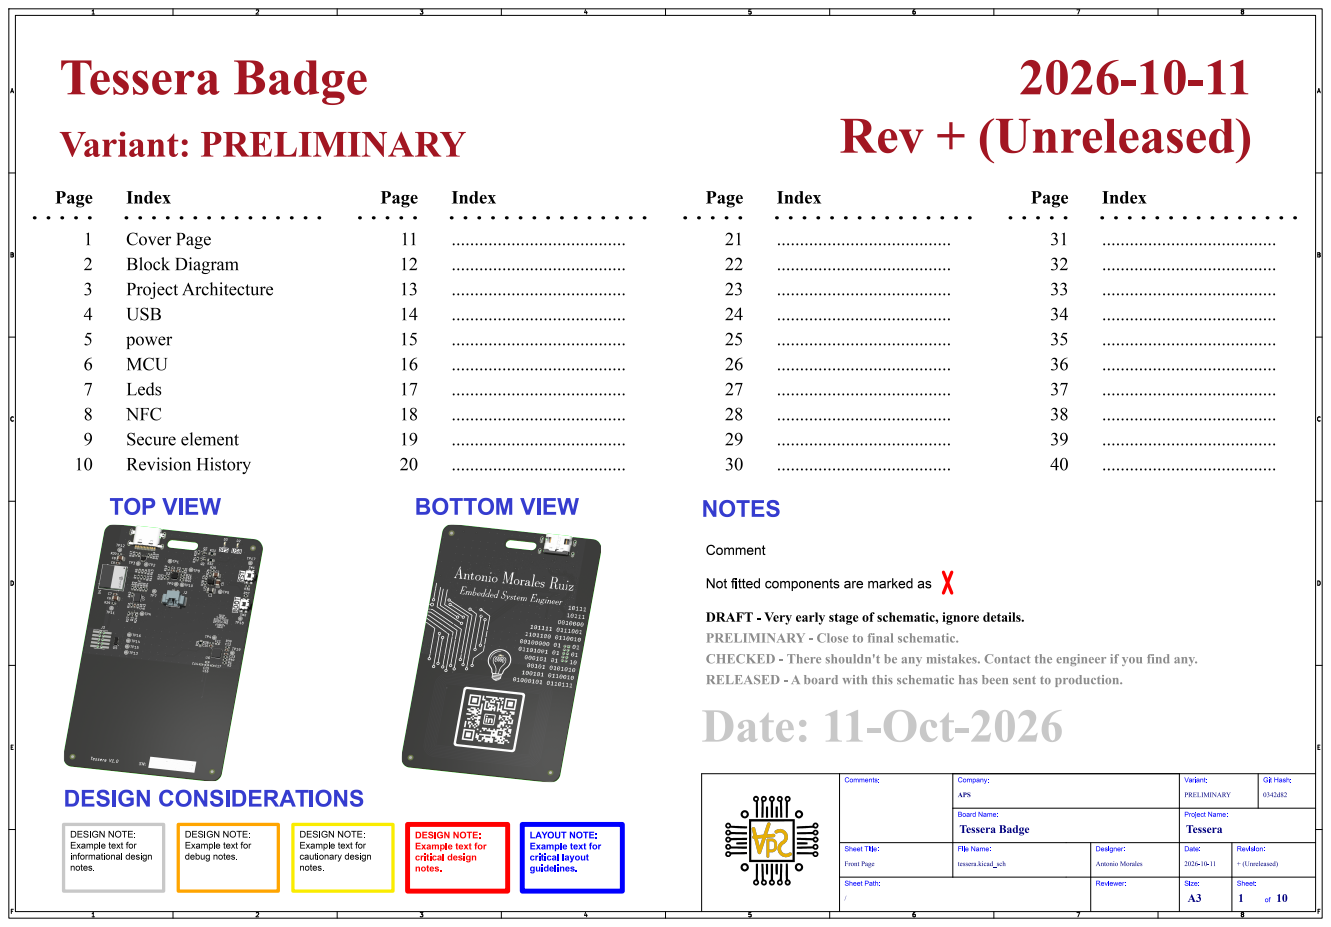
[picture p20: page 1]
Sheet: of 10; Size: A3; tessera.kicad_sch; Antonio Morales Board Name:; Variant: PRELIMINARY Company: APS TesseraBadge; Tessera; Sheet Title:; File Name:; /Sheet Path: FrontPage Comments:; Git Hash: 0342d82 BlockDiagram; Date:11-Oct-2026; PRELIMINARY - Closetofinal schematic. ...................................... NOTES; Comment; RELEASED - A boardwiththisschematichasbeensenttoproduction. ......................................; Index; CoverPage; Page; USB; ProjectArchitecture; Block Diagram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

Not fitted components are marked as

DRAFT - Veryearlystageof schematic,ignoredetails.

CHECKED - Thereshouldn'tbeanymistakes.Contacttheengineerif youfindany.

Revision: + (Unreleased) Date: Project Name: 2026-10-11 Reviewer: Designer:

DESIGN NOTE:
Example text for
informational design
notes.

cautionary design

LAYOUT NOTE:
critical layout
guidelines.

debug notes.

critical design
