AntonioMR/tessera-hw/Schematic/tessera-schematic-10.pdf

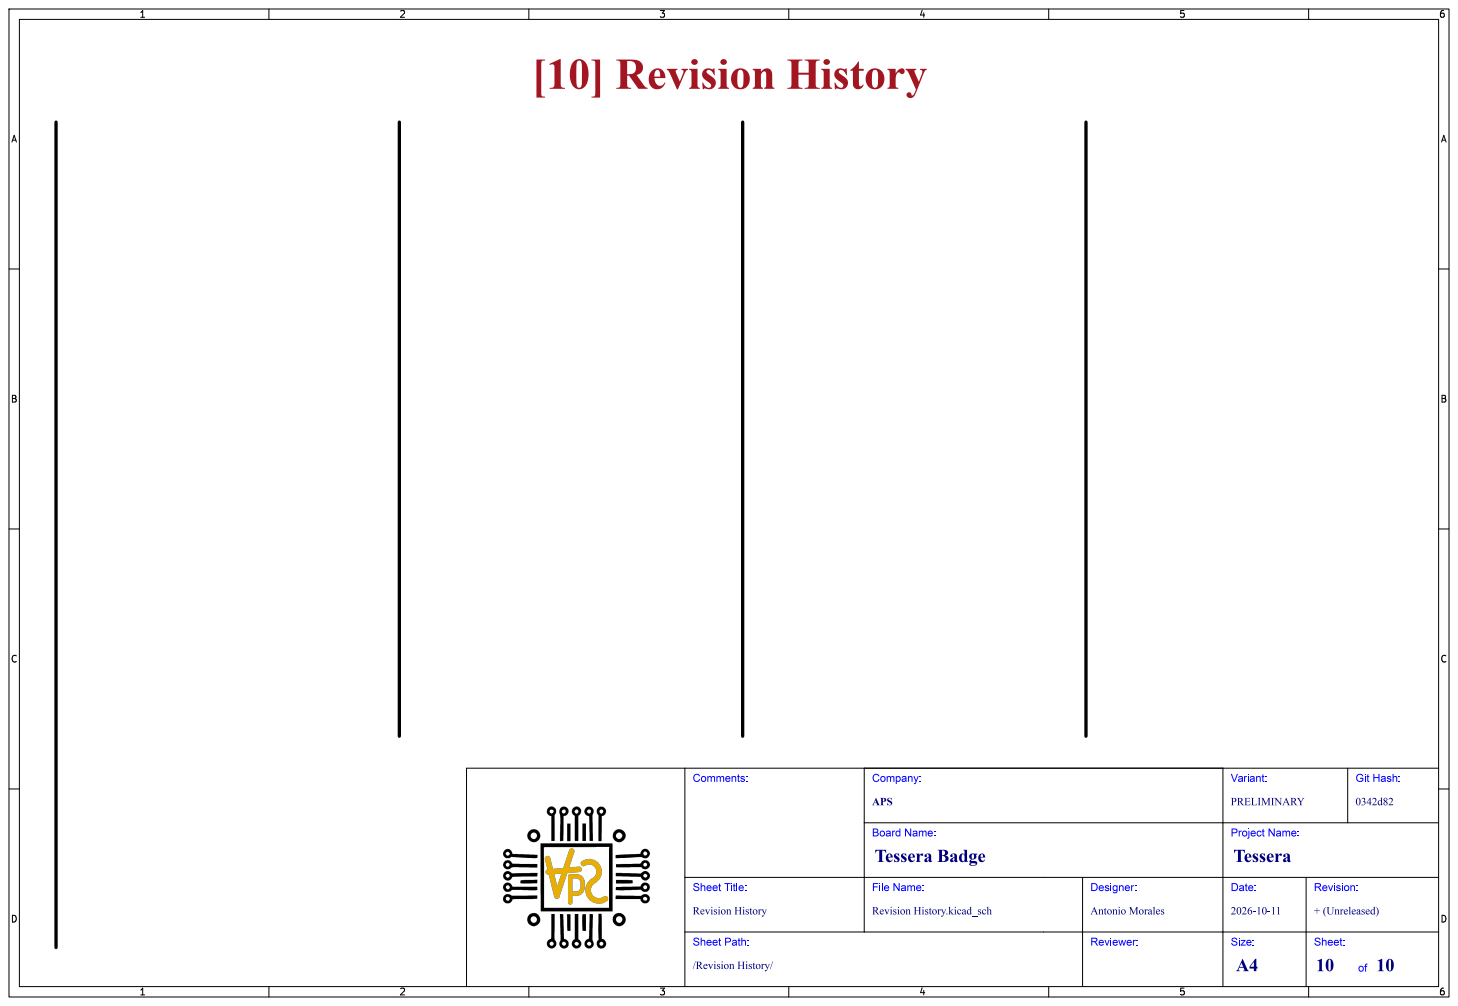
[picture p21: page 1]
Sheet: of 10; Size: A4; Revision: + (Unreleased) Date: Project Name: 2026-10-11 Reviewer: Designer: RevisionHistory.kicad_sch; Antonio Morales Board Name:; Variant: PRELIMINARY Company: APS TesseraBadge; Tessera; Sheet Title:; File Name:; /RevisionHistory/ Sheet Path: RevisionHistory Comments:; Git Hash: 0342d82 [10] RevisionHistory
