AntonioMR/tessera-hw/Schematic/tessera-schematic-2.pdf

# NFC Loop Antenna BLE / 2.4 GHz Antenna SWD

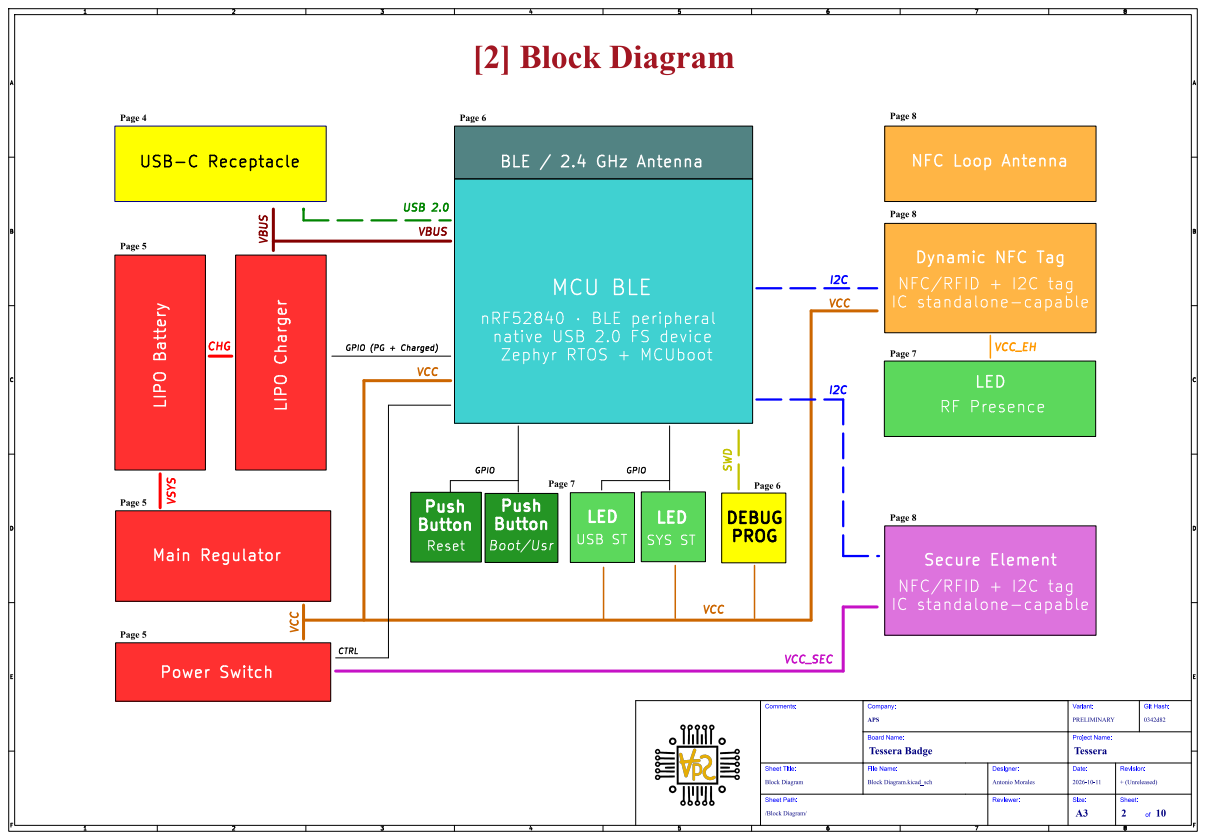
[picture p22: page 1]
Sheet: of 10; Size: A3; Revision: + (Unreleased) Date: Project Name: 2026-10-11 Reviewer: Designer: Block Diagram.kicad_sch; Antonio Morales Board Name:; Variant: PRELIMINARY Company: APS TesseraBadge; Tessera; Sheet Title:; File Name:; Comments:; Git Hash: 0342d82 nRF52840 þÿ·BLE peripheral; native; USB 2.0 FS device; Zephyr; RTOS +; MCUboot; VCC; VCC_EH; NFC/RFID; + I2C tag; LED RF Presence; GPIO; Push; Button LIPO Battery VSYS; LIPO Charger CHG; Power; Switch; CTRL; Secure; Element VCC VBUS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

Dynamic NFC Tag
IC standalone-capable

GPIO (PG + Charged)

Secure Element

/Block Diagram/ Sheet Path: Block Diagram
