AntonioMR/tessera-hw/Schematic/tessera-schematic-3.pdf

# TP2 TP3 TP1 R7

# [3] ProjectArchitecture

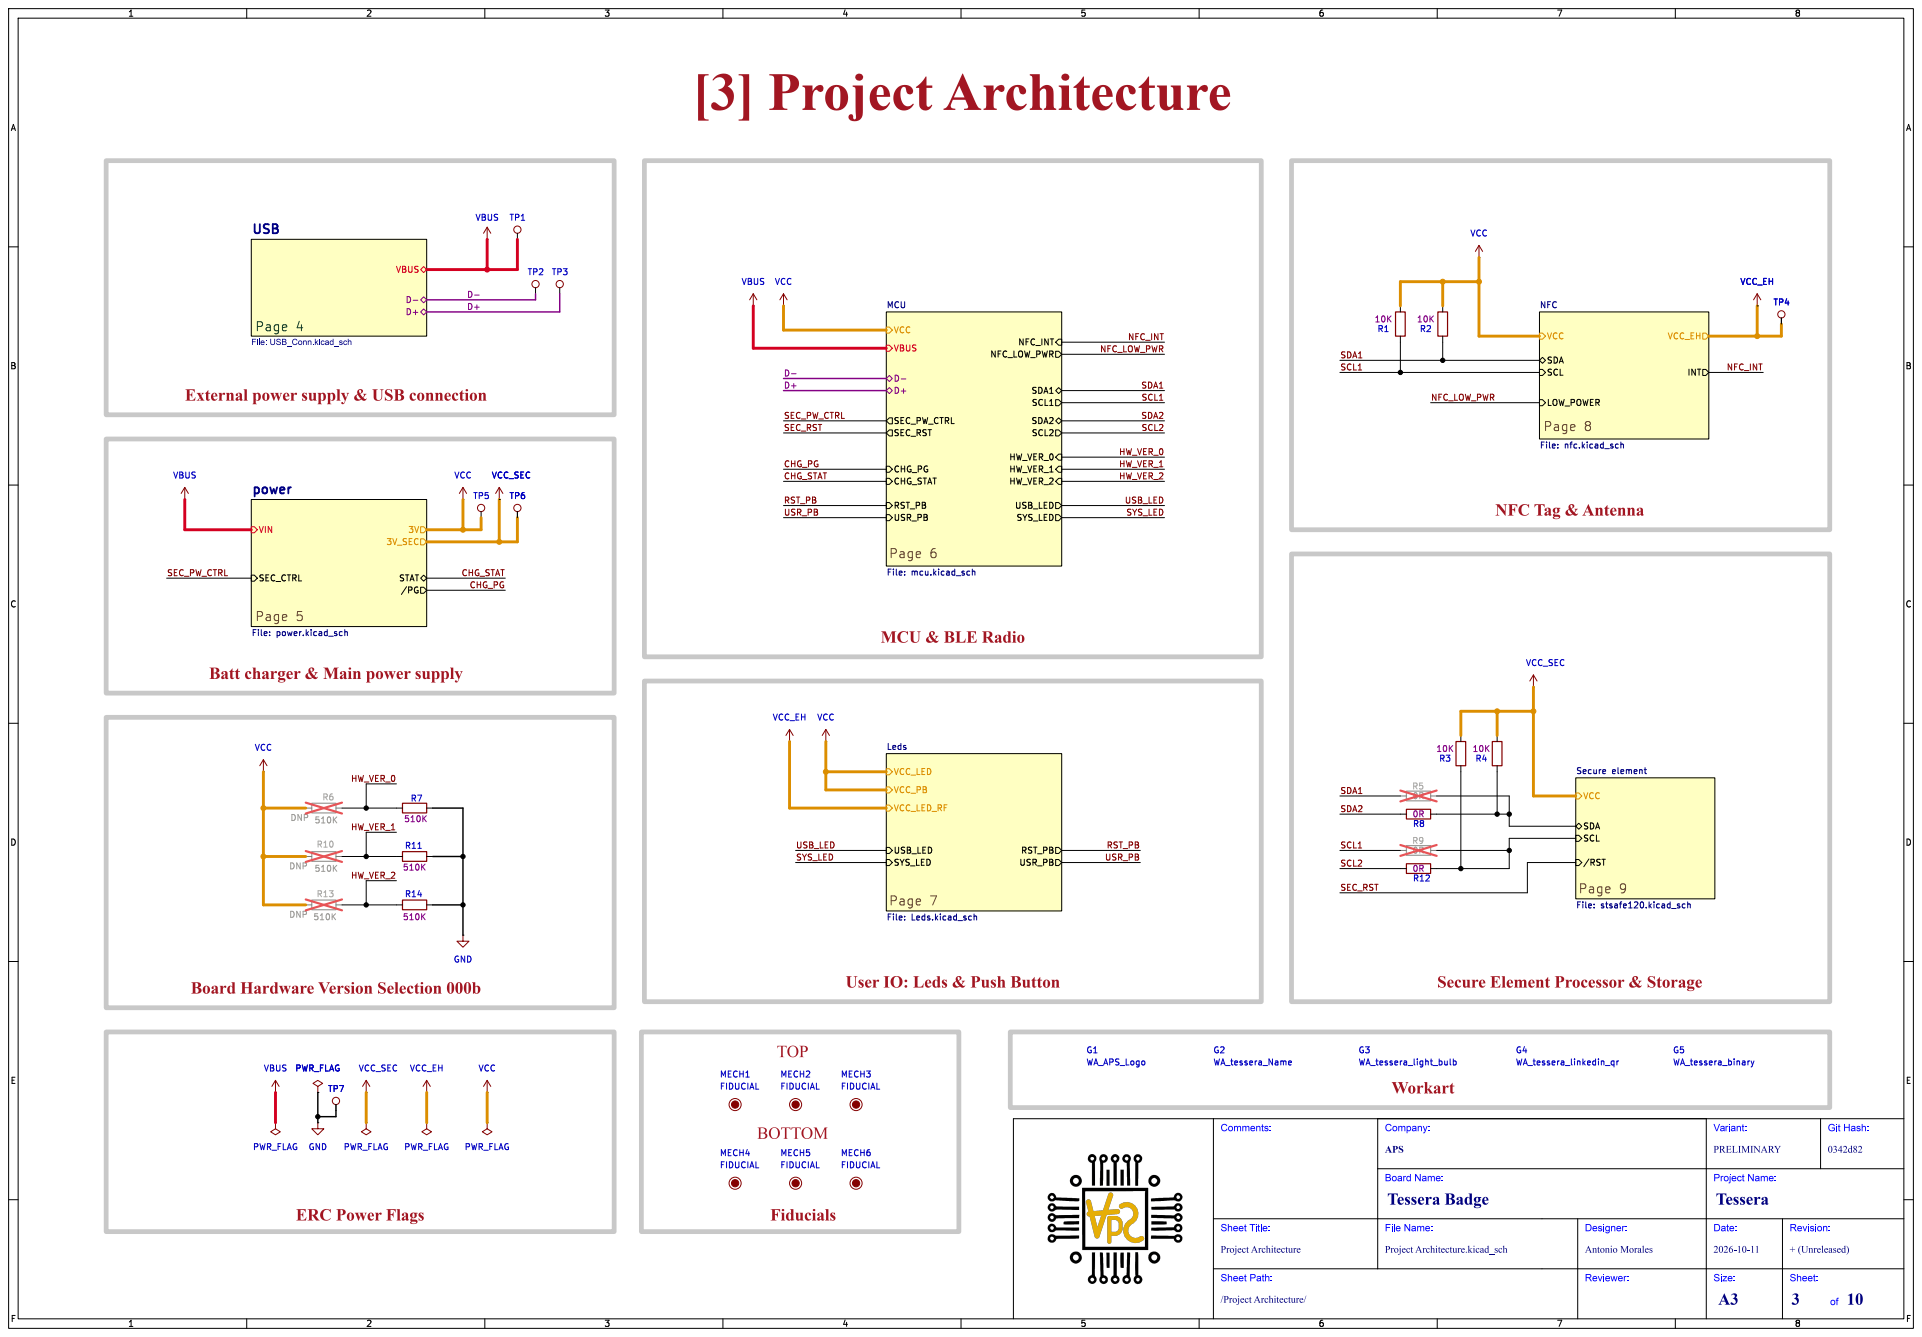
[picture p23: page 1]

INT NFC
File: nfc.kicad_sch SCL SDA

Batt charger& Main powersupply

Revision: + (Unreleased) Date: Project Name: 2026-10-11 Reviewer: Designer:
