AntonioMR/tessera-hw/Schematic/tessera-schematic-4.pdf

# [4] USBConnector

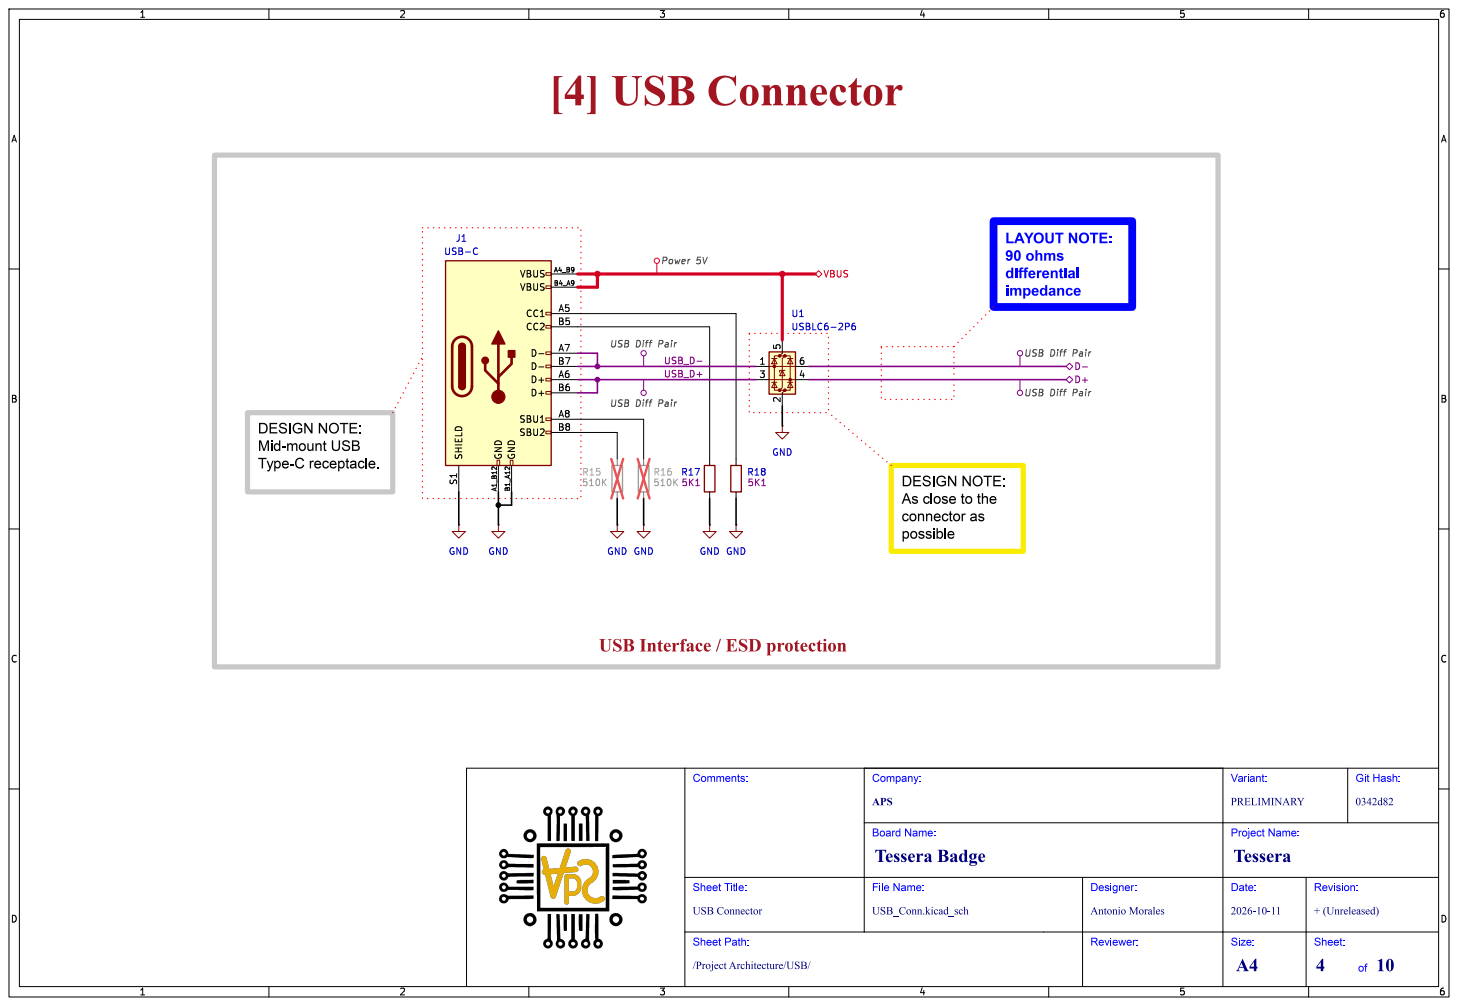
[picture p24: page 1]
Sheet: of 10; Size: A4; USB_Conn.kicad_sch; Antonio Morales Board Name:; Variant: PRELIMINARY Company: APS TesseraBadge; Tessera; Sheet Title:; File Name:; /ProjectArchitecture/USB/ Sheet Path: USB Connector Comments:; Git Hash: 0342d82 GND; 6 U1 USBLC6-2P6 GND; 510K GND A¹_B¹²; VBUS A4_B9 CC1; A7 SBU1; A8 GND B¹_A¹²; VBUS B4_A9 CC2; B7 SBU2; B8 SHIELD S¹ J1 USB-C GND; GND; GND GND; VBUS; D+D- USB_D- USB_D+; LAYOUT NOTE:; 90 ohms differential impedance

USB Diff Pair USB Diff Pair USB Diff Pair USB Diff Pair Power 5V

DESIGN NOTE:
Mid-mount USB
Type-C receptacle.

As close to the
connector as possible

USBInterface/ ESD protection

Revision: + (Unreleased) Date: Project Name: 2026-10-11 Reviewer: Designer:
