AntonioMR/tessera-hw/Schematic/tessera-schematic-5.pdf

# 0R GND

STAT VCH_IN Main VCC DC/DC | Secureelementpowerswitch

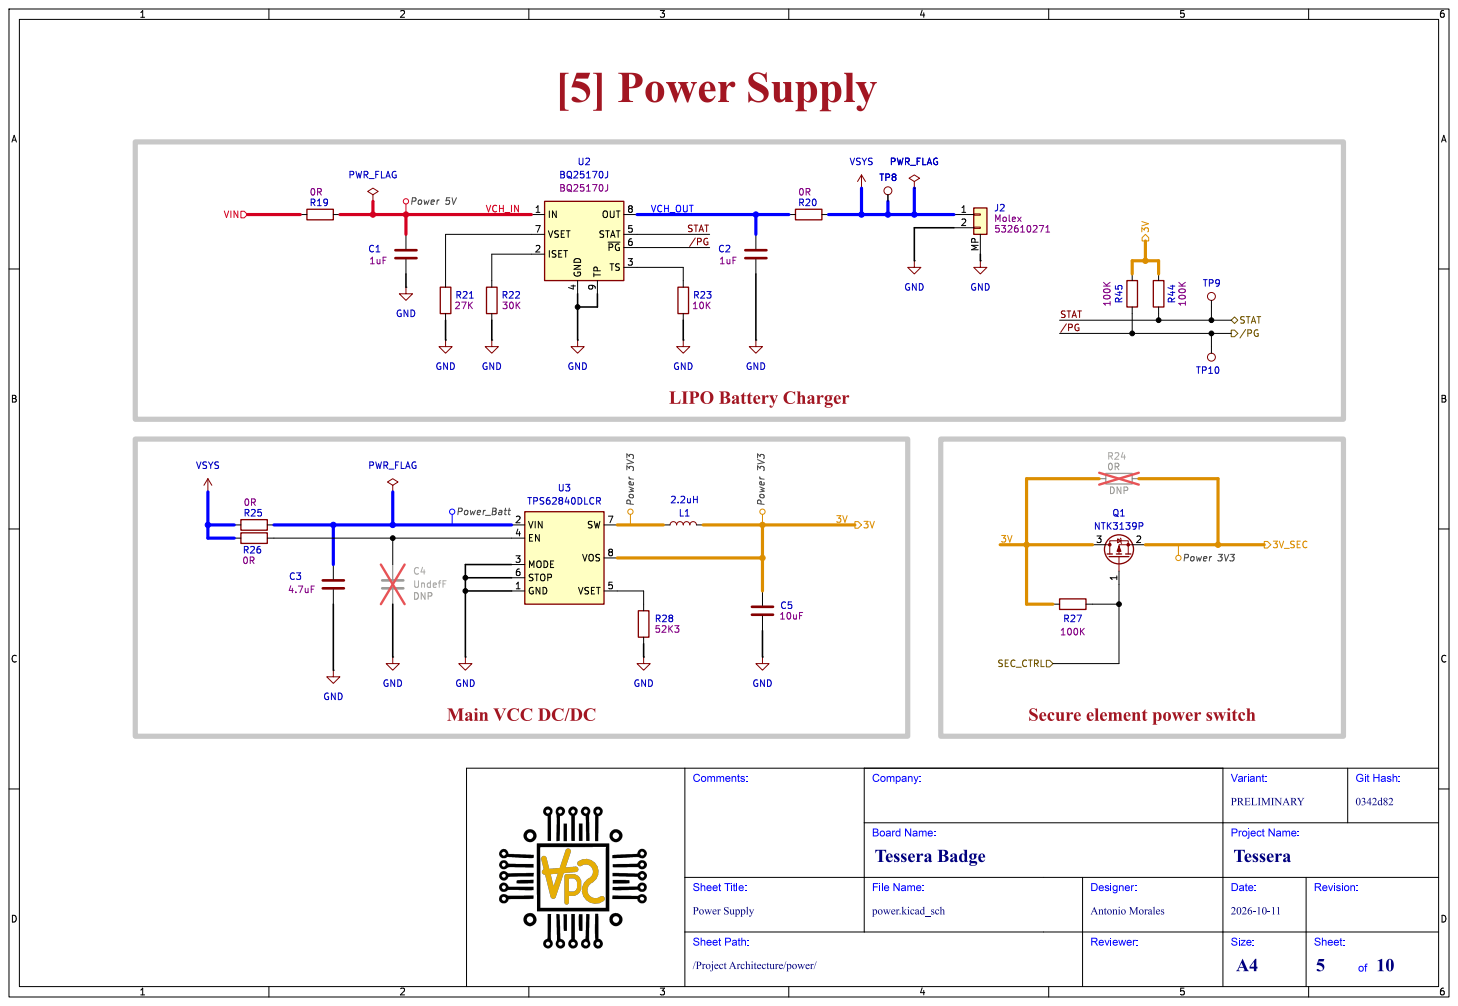
[picture p25: page 1]

4 STAT 5 ~{PG}6 VSET 7 OUT 8 TP
