AntonioMR/tessera-hw/Schematic/tessera-schematic-6.pdf

TP11 | VBUS_nRF VCC_nRF GND | GND
UART_TX | [6] BLE MCU

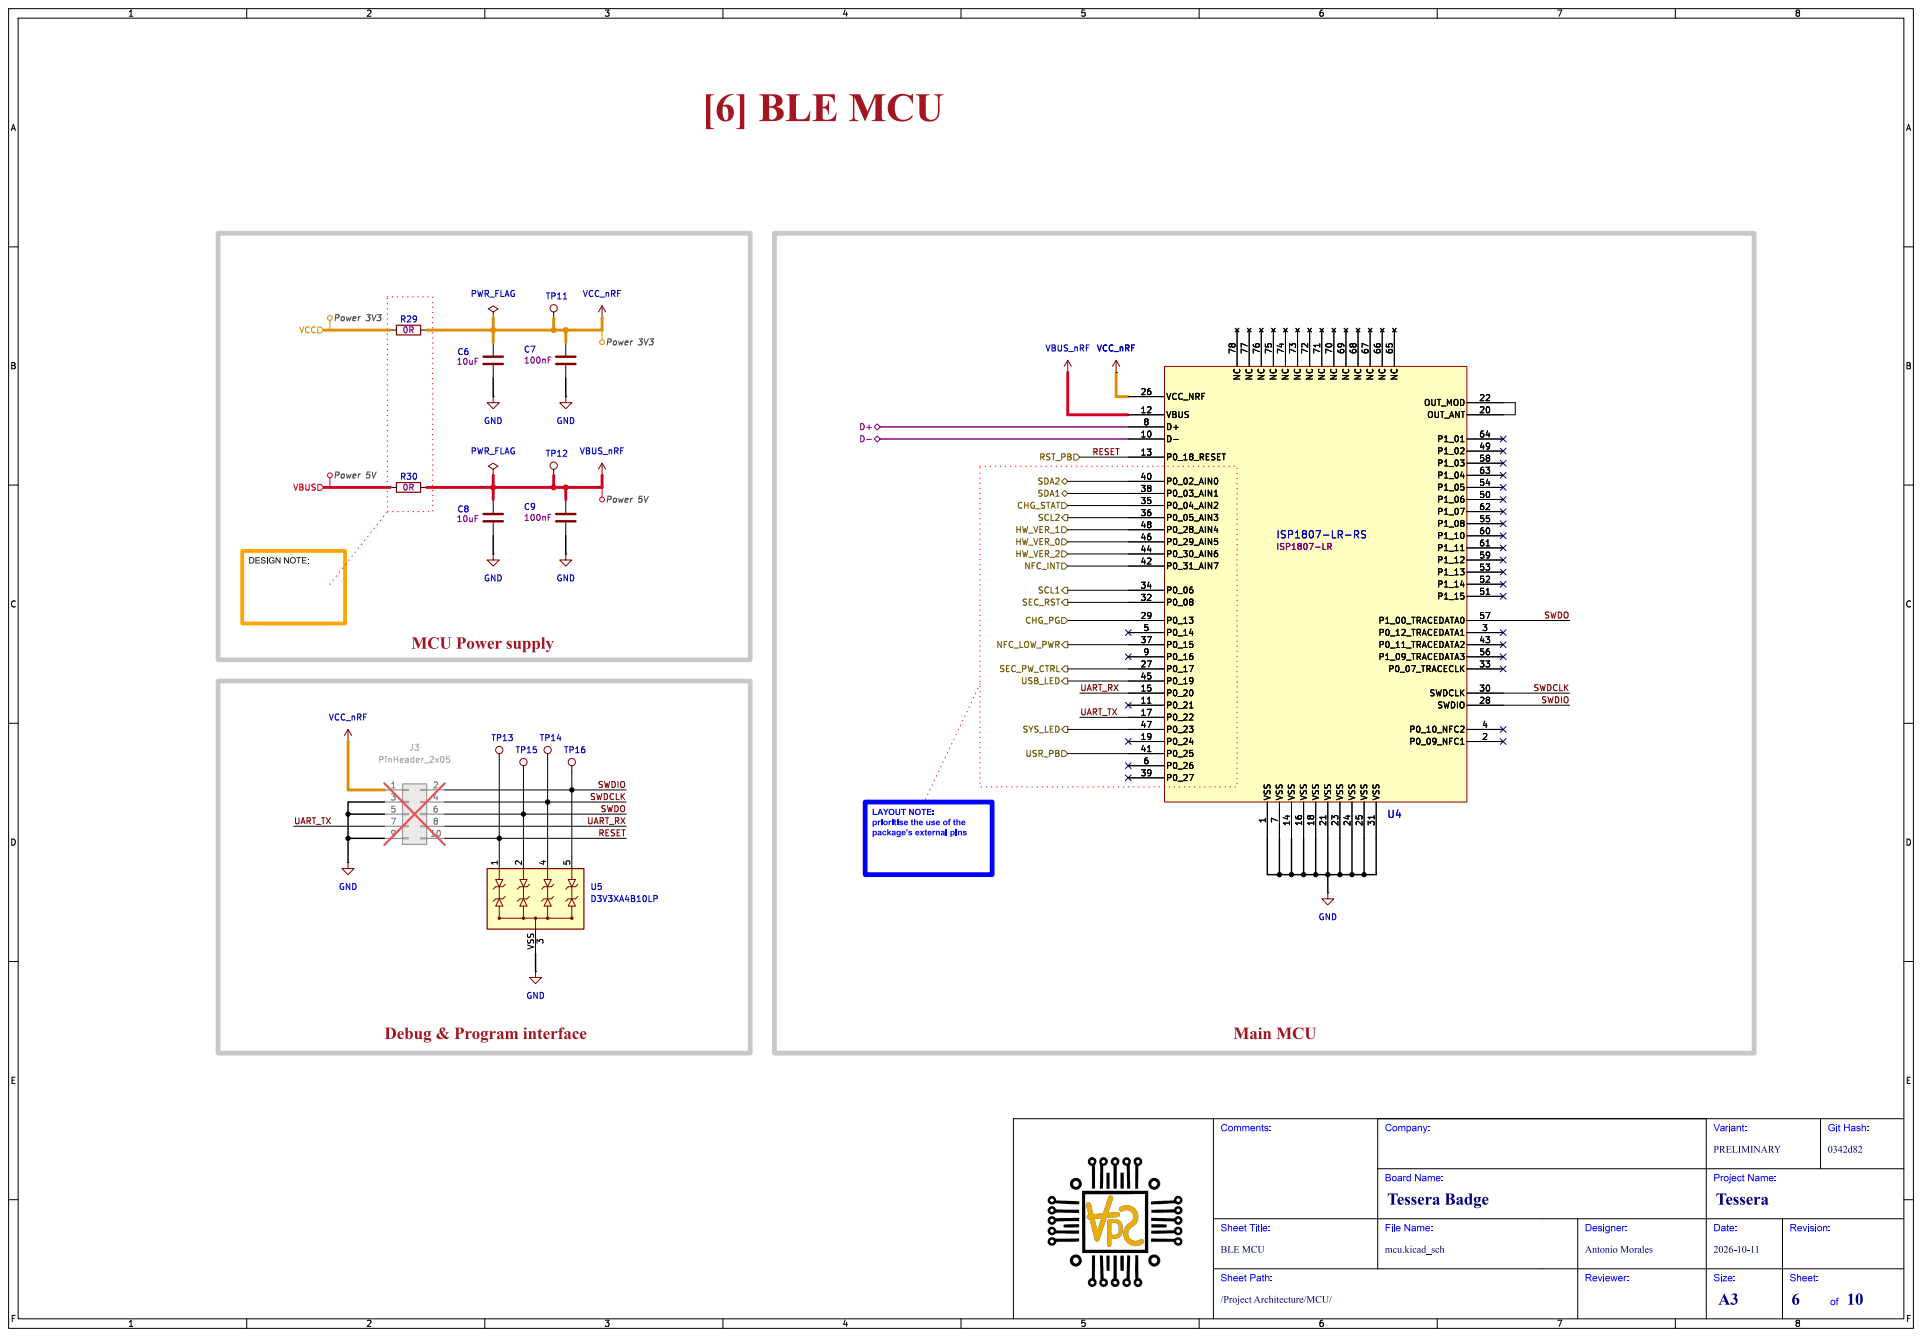
[picture p26: page 1]

1 D- 10 P0_21 11 VBUS 12 P0_18_RESET 13 VSS 14 P0_20 15 VSS 16 P0_22 17 VSS 18 P0_24 19 P0_09_NFC1 2 OUT_ANT 20 VSS 21 OUT_MOD 22 VSS 23 VSS 24 VSS 25 VCC_NRF 26 P0_17 27 SWDIO 28 P0_13 29 P0_12_TRACEDATA1 3 SWDCLK 30 VSS 31 P0_08 32 P0_07_TRACECLK 33 P0_06 34 P0_15 37 P0_27 39 P0_10_NFC2 4 P0_02_AIN0 40 P0_25 41 P0_19 45 P0_23 47 P1_02 49 P0_14 5 P1_06 50 P1_15 51 P1_14 52 P1_13 53 P1_05 54 P1_08 55 P1_09_TRACEDATA3 56 P1_00_TRACEDATA0 57 P1_03 58 P1_12 59 P1_10 60 P1_11 61 P1_07 62 P1_04 63 P1_01 64 NC 65 NC 66 NC 67 NC 68 NC 69 VSS

7 NC 70 NC 71 NC 72 NC 73 NC 74 NC 75 NC 76 NC 77 NC 78 D+ 8 P0_16 9 P0_04_AIN2 35 P0_05_AIN3 36 P0_03_AIN1 38 P0_31_AIN7 42 P0_11_TRACEDATA2 43 P0_30_AIN6 44 P0_29_AIN5 46 P0_28_AIN4 48 P0_26 6 U4

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

/ProjectArchitecture/MCU/ Sheet Path: BLE MCU
