AntonioMR/tessera-hw/Schematic/tessera-schematic-7.pdf

1 | 2 | 3 | 4 | 5 | 6

A

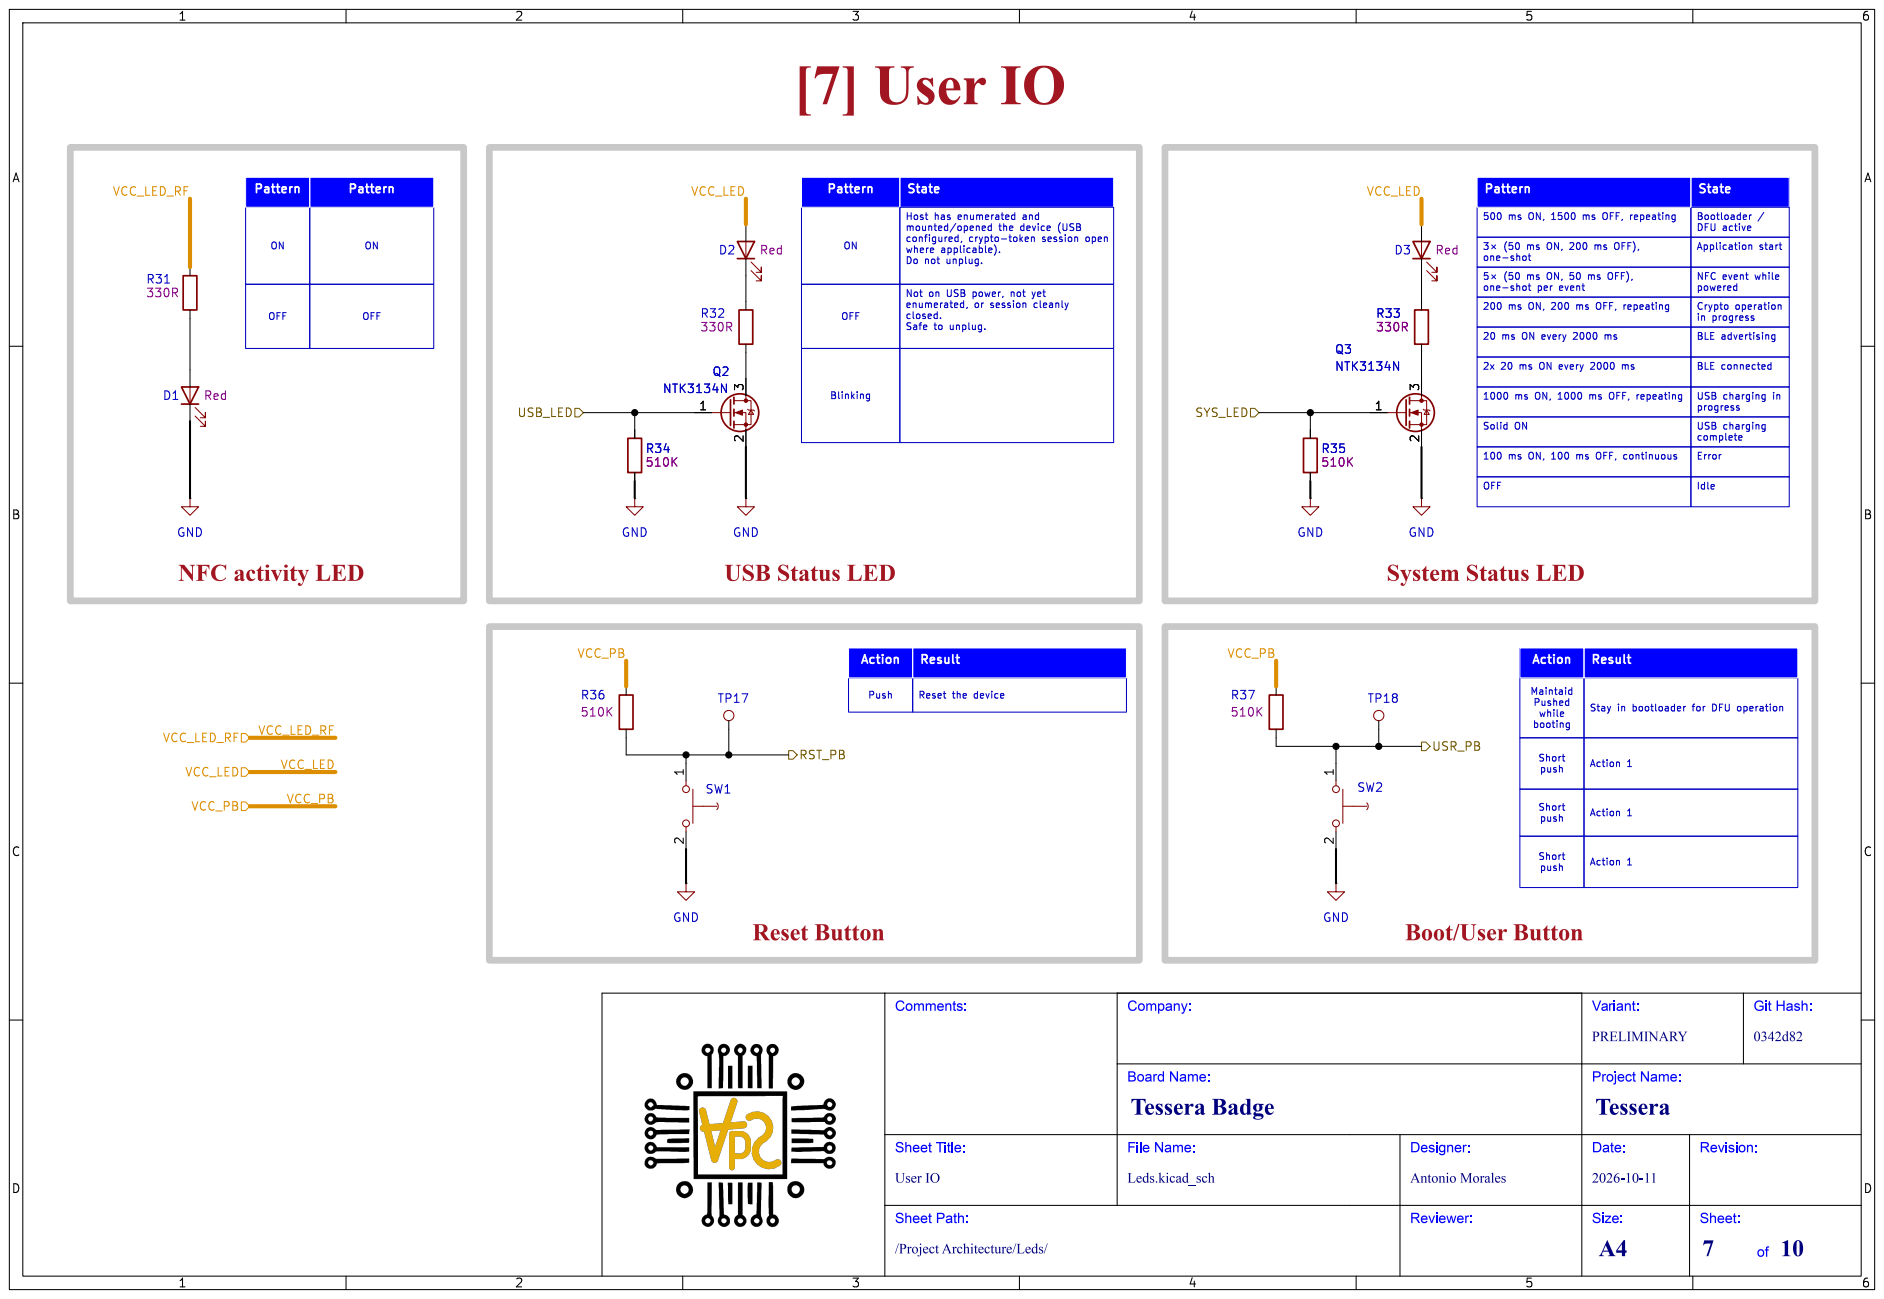
[picture p27: page 1]

þÿ3×(50 ms ON, 200 ms OFF), one-shot 20 ms ON every 2000 ms 2x 20 ms ON every 2000 ms 500 ms ON, 1500 ms OFF, repeating

in progress NFC event while

200 ms ON, 200 ms OFF, repeating

BLE connected NFC activityLED

1000 ms ON, 1000 ms OFF, repeating USB charging

/ProjectArchitecture/Leds/ Sheet Path: UserIO
