AntonioMR/tessera-hw/Schematic/tessera-schematic-8.pdf

Signal Name EP | [8] NFC Interface

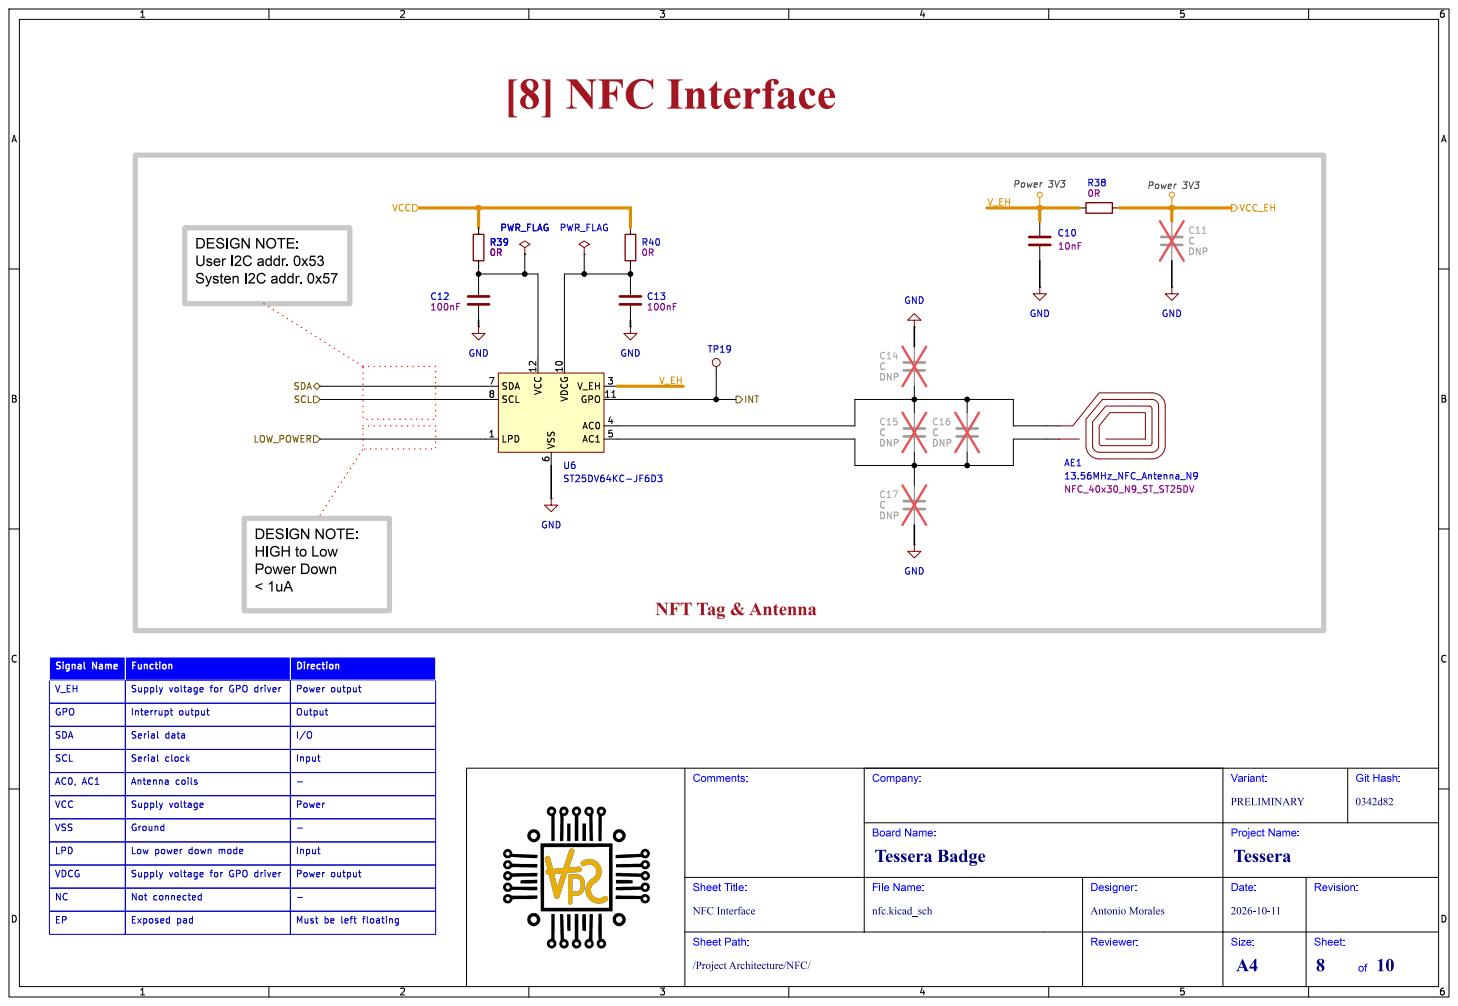
[picture p28: page 1]

6 SDA 7 SCL 8 U6ST25DV64KC-JF6D3 GND GND

Direction Must be left floating

Low power down mode Not connected Supply voltage

Supply voltage for GPO driver Ground Exposed pad
