AntonioMR/tessera-hw/Schematic/tessera-schematic-9.pdf

# /RST SCL [9] SecureElement

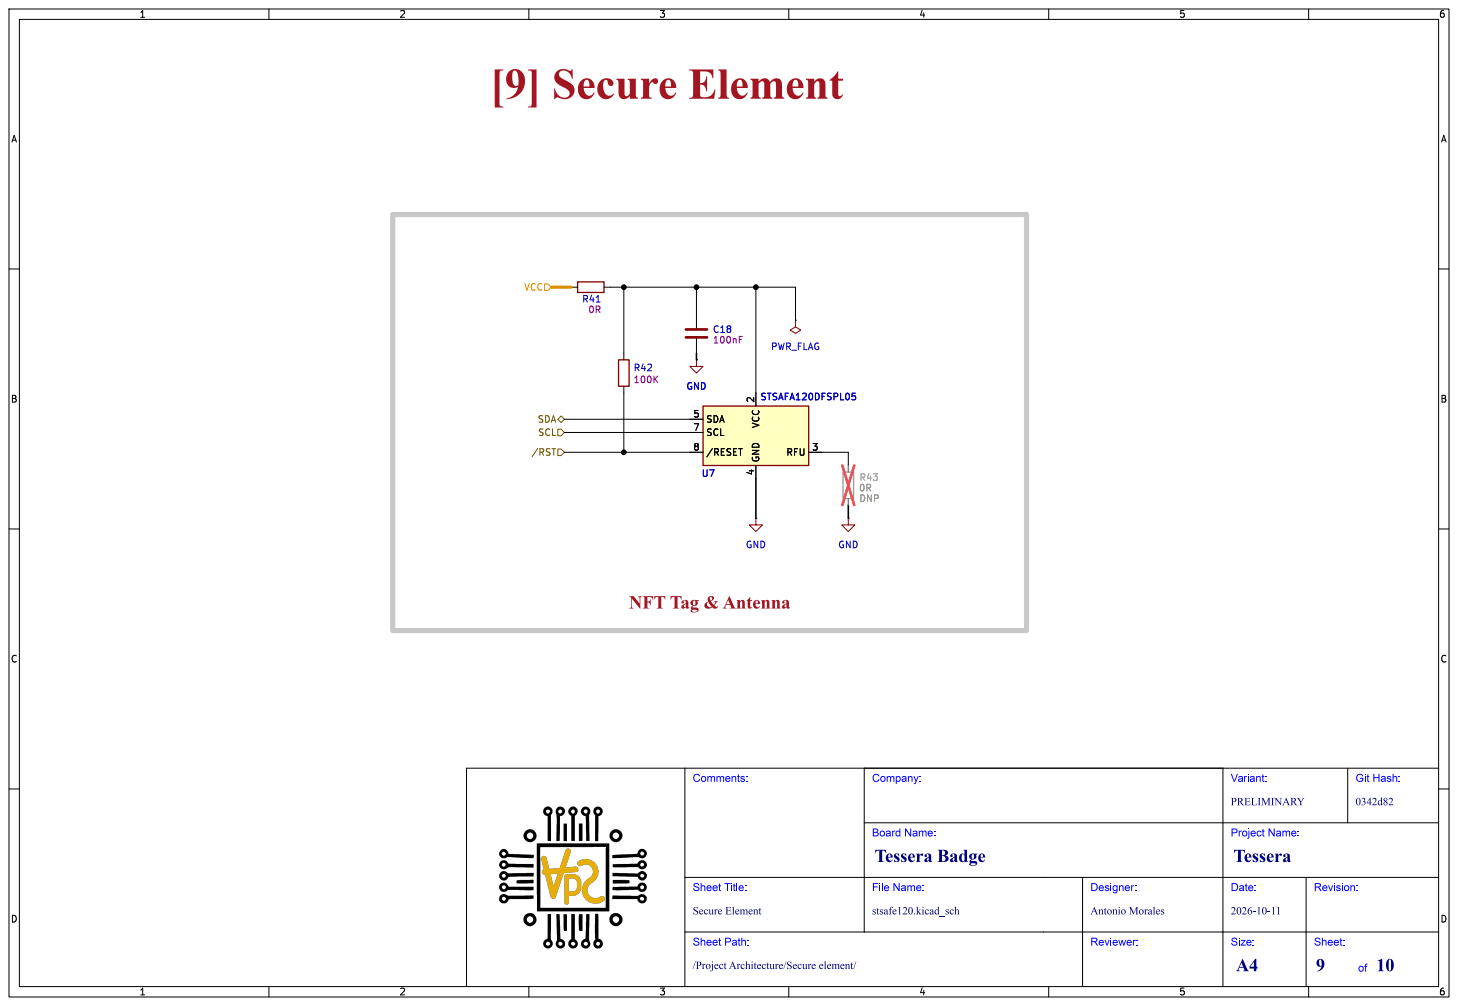
[picture p29: page 1]
Sheet: of 10; Size: A4; Date:; Revision: Project Name: 2026-10-11 Reviewer: Designer:; stsafe120.kicad_sch; Antonio Morales Board Name:; Variant: PRELIMINARY Company:; TesseraBadge; Tessera; Sheet Title:; File Name:; /ProjectArchitecture/Securelement/ Sheet Path: SecureElement Comments:; Git Hash: 0342d82 GND; R43 0R DNP; PWR_FLAG; GND; RFU 3 SDA 5 SCL 7; VCC; 2 GND; /RESET 8 U7; STSAFA120DFSPL05 VCC; SDA; DNP U7; STSAFA120DFSPL05 RFU 3 SDA 5 SCL 7; /RESET 8 GND

NFT Tag& Antenna
