AntonioMR/tessera-hw/Manufacturing/Assembly/tessera-assembly-1.pdf

# Tessera Badge Assembly Document

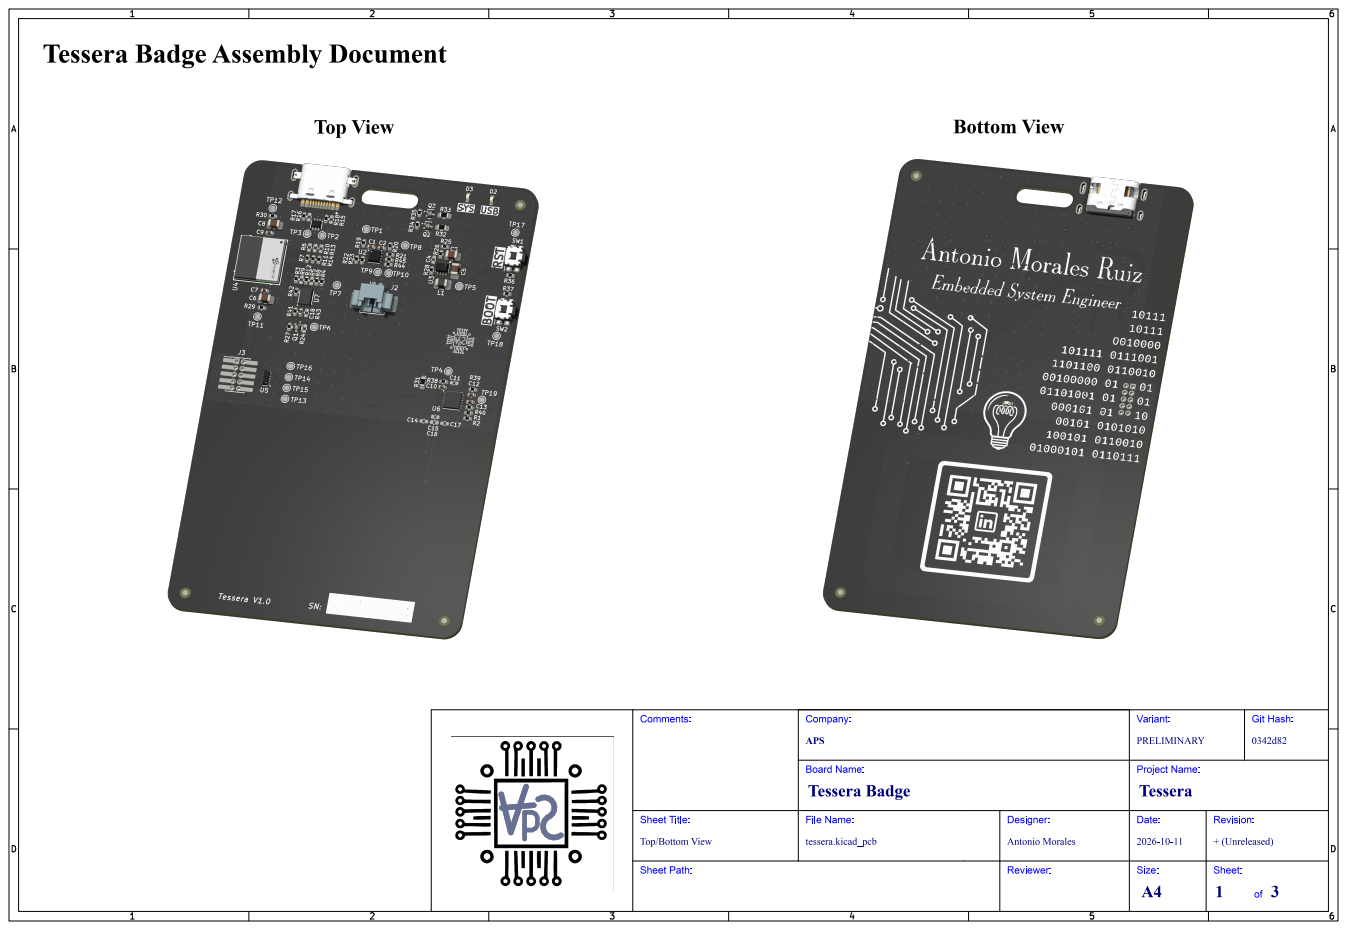
[picture p40: page 1]
Git; Hash:; Comments:; Sheet Path:; Sheet Title:; File Name:; Tessera Badge; Tessera; APS; Company:; PRELIMINARY; Variant:; Board Name:; tessera.kicad_pcb; Antonio Morales; Designer:; Reviewer:; Project Name:; Date:; + (Unreleased); Revision:; Size:; Sheet: 1

Top/Bottom View
