AntonioMR/tessera-hw/Manufacturing/Assembly/tessera-assembly-2.pdf

# Top Assembly (Scale 1:1)

# Tessera Badge Assembly Document

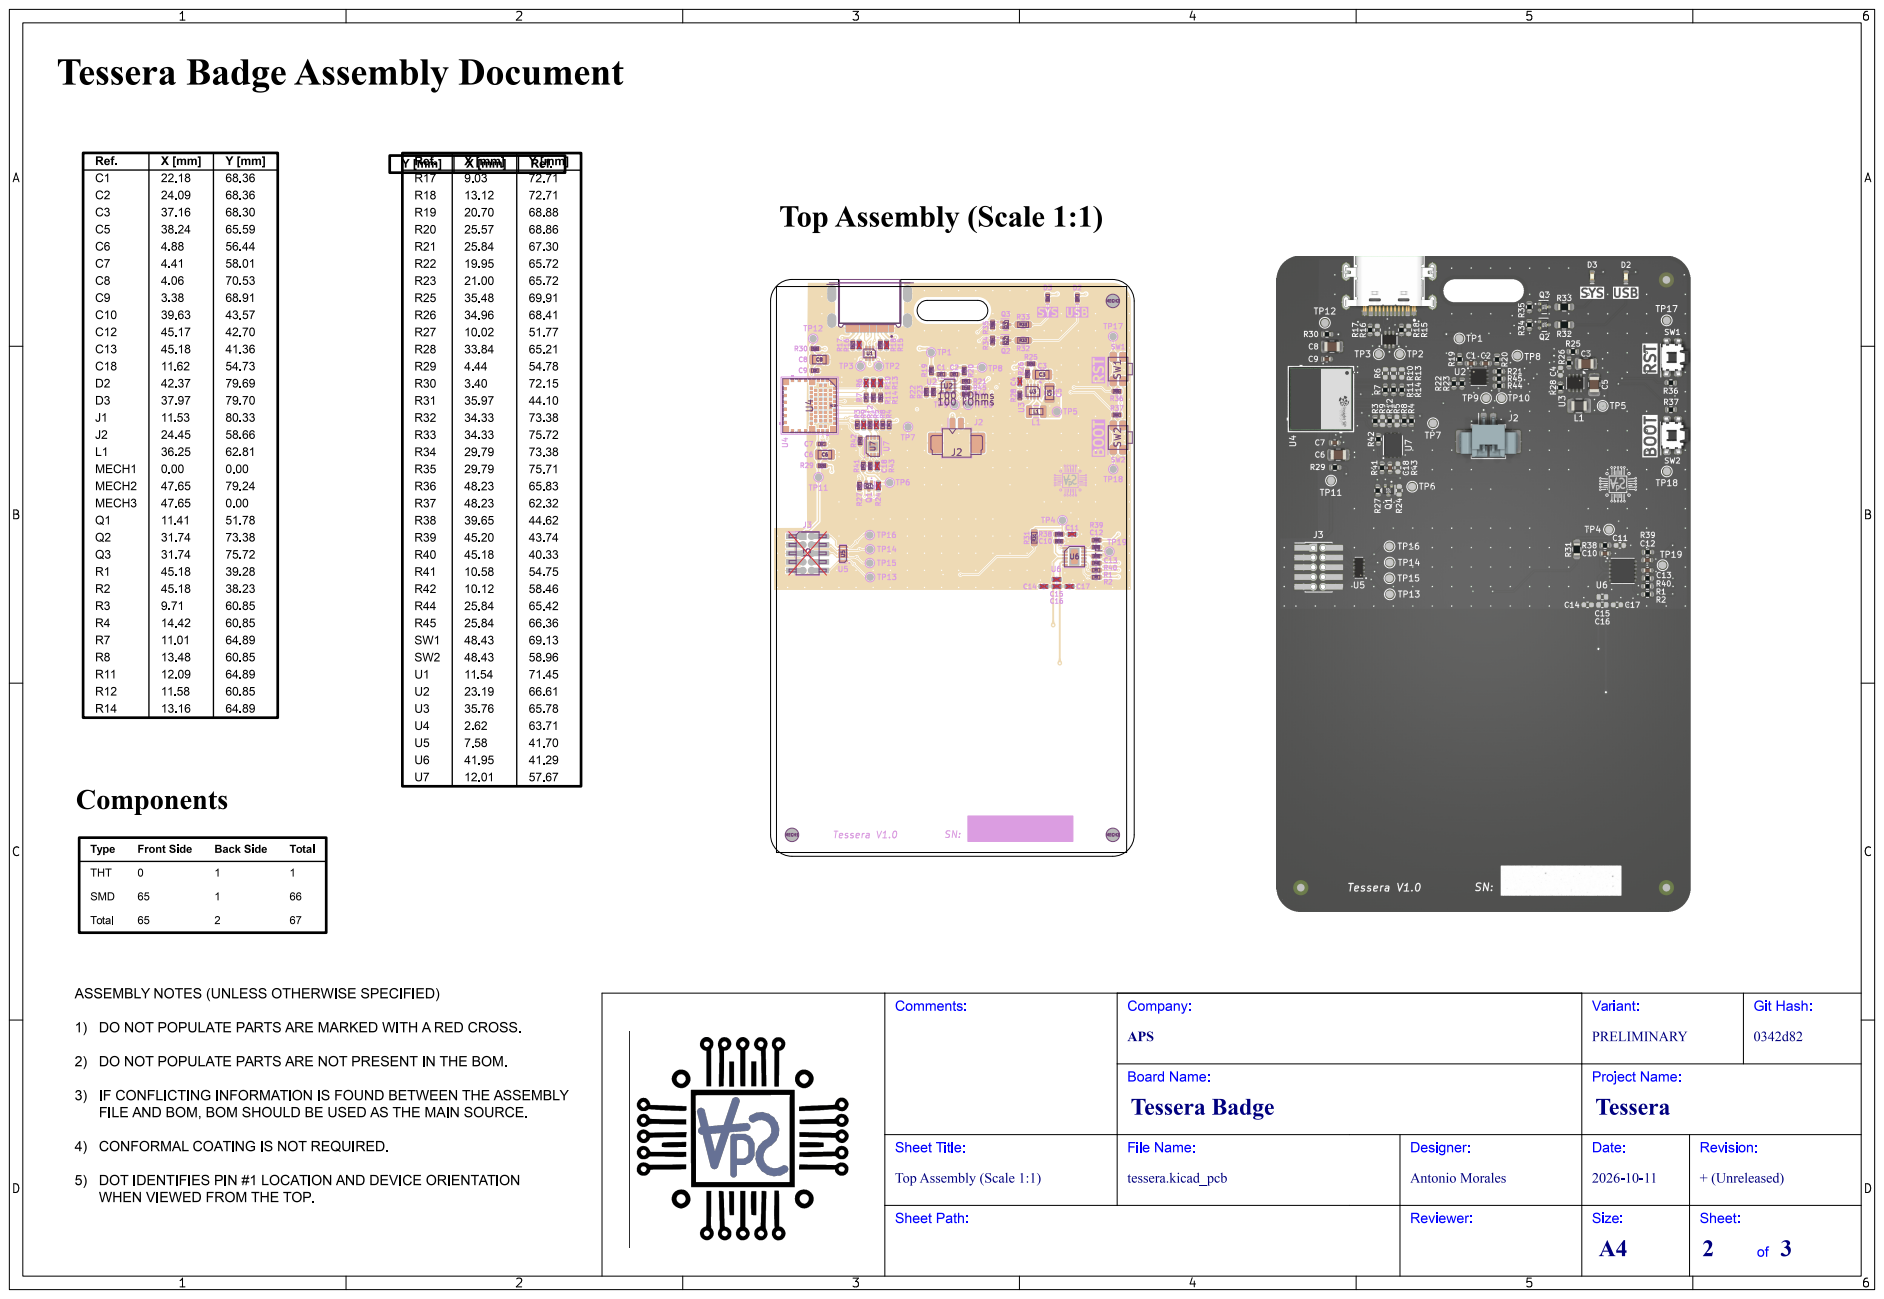
[picture p41: page 1]
