AntonioMR/tessera-hw/Manufacturing/Assembly/tessera-assembly-3.pdf

# Bottom Assembly (Scale 1:1)

# Tessera Badge Assembly Document

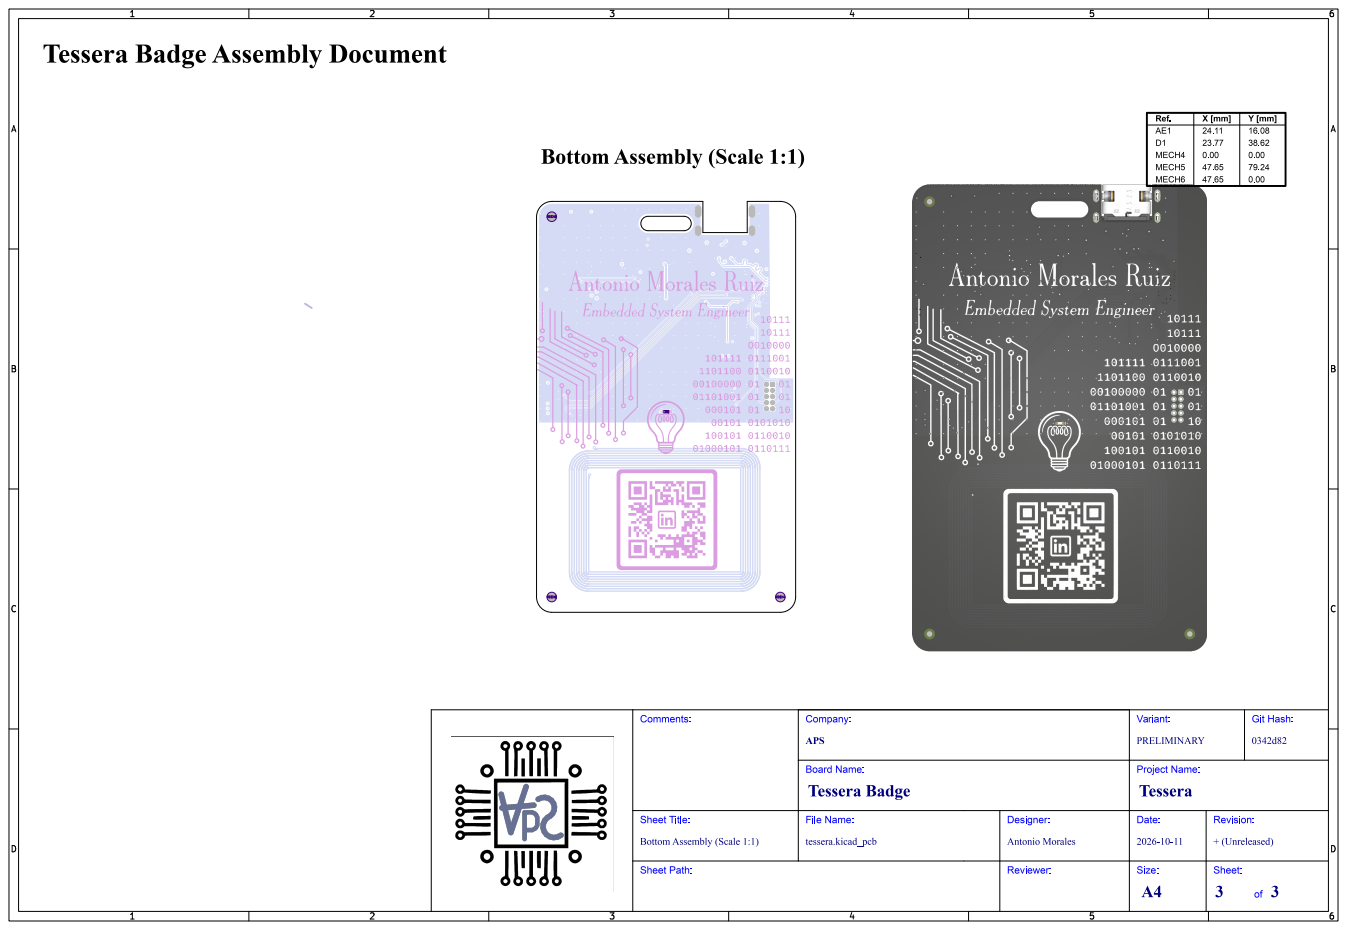
[picture p42: page 1]
Git; Hash:; Comments:; Sheet Path:; Sheet Title:; File Name:; Tessera Badge; Tessera; APS; Company:; PRELIMINARY; Variant:; Board Name:; tessera.kicad_pcb; Antonio Morales; Designer:; Reviewer:; Project Name:; Date:; + (Unreleased); Revision:; Size:; Sheet: 3; MECH5; MECH6; MECH4

Bottom Assembly (Scale 1:1)
