AntonioMR/tessera-hw/Manufacturing/Assembly/tessera-assembly.pdf

# Tessera Badge Assembly Document

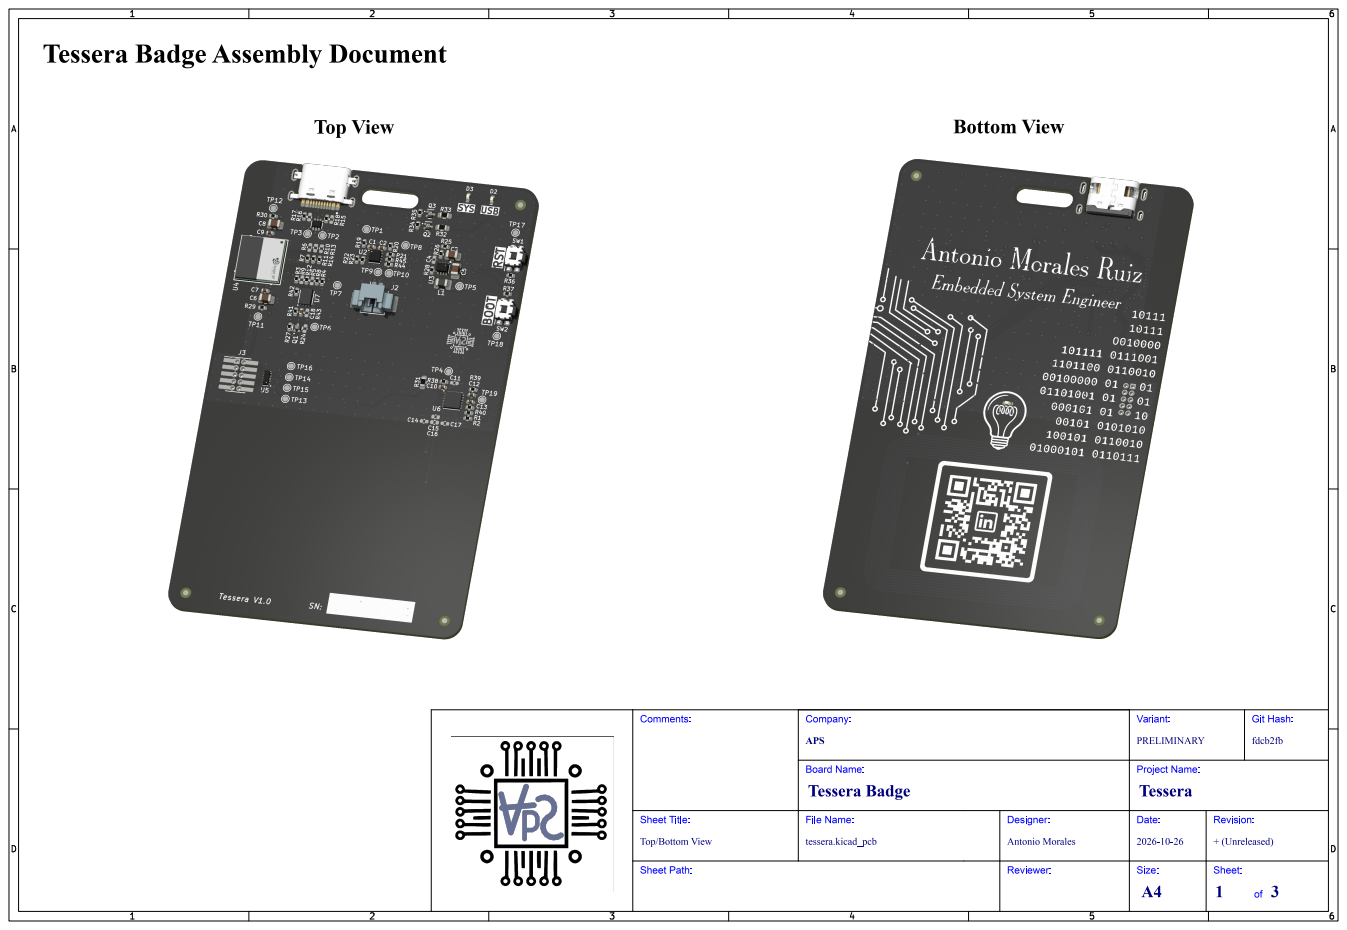
[picture p43: page 1]
Git; Hash:; fdcb2fb; Comments:; Sheet Path:; Sheet Title:; File Name:; Tessera Badge; Tessera; APS; Company:; PRELIMINARY; Variant:; Board Name:; tessera.kicad_pcb; Antonio Morales; Designer:; Reviewer:; Project Name:; Date:; + (Unreleased); Revision:; Size:; Sheet:

Top/Bottom View

# Top Assembly (Scale 1:1)

# Tessera Badge Assembly Document

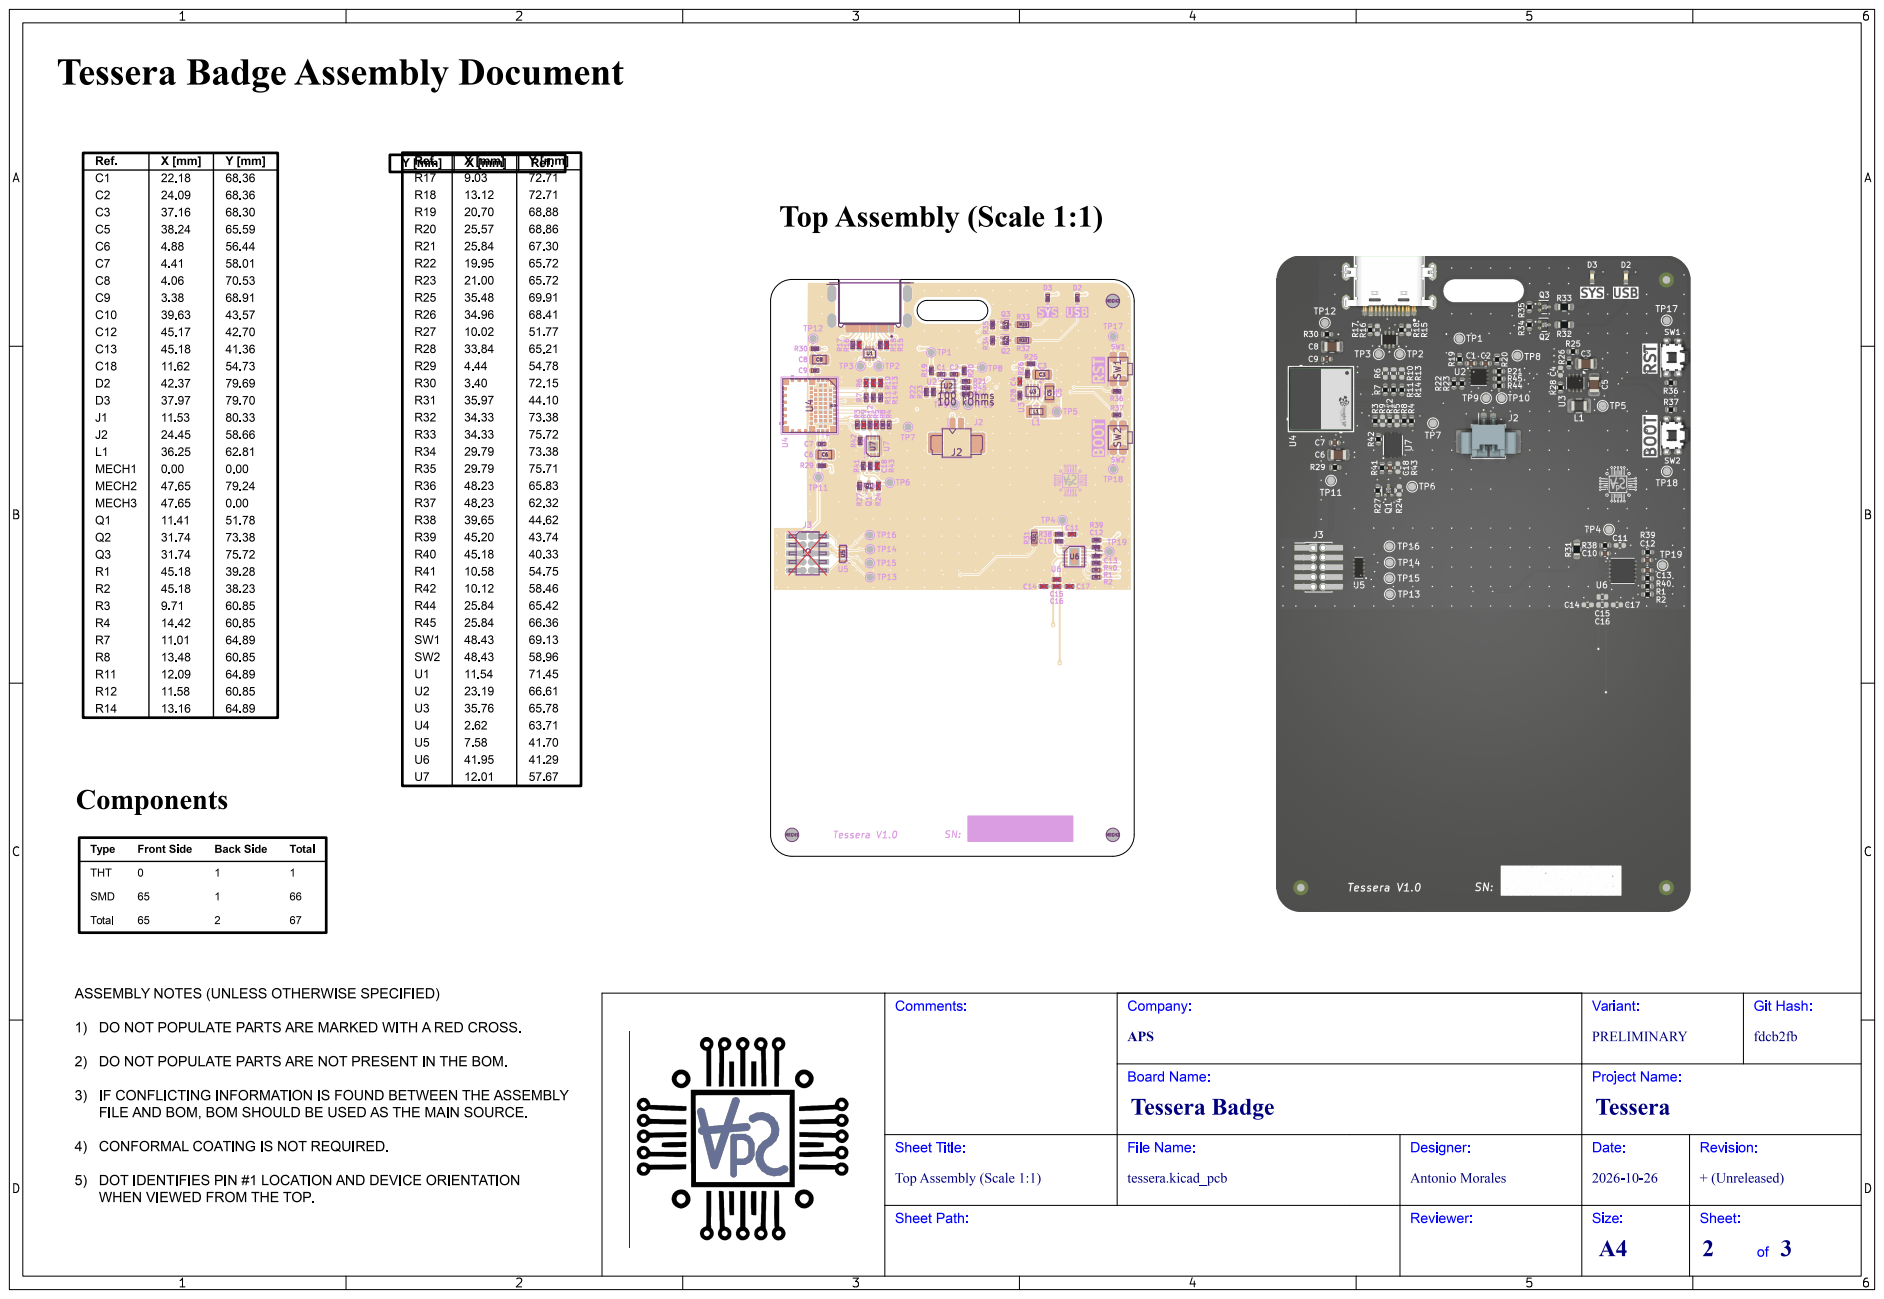
[picture p44: page 2]

# Bottom Assembly (Scale 1:1)

# Tessera Badge Assembly Document

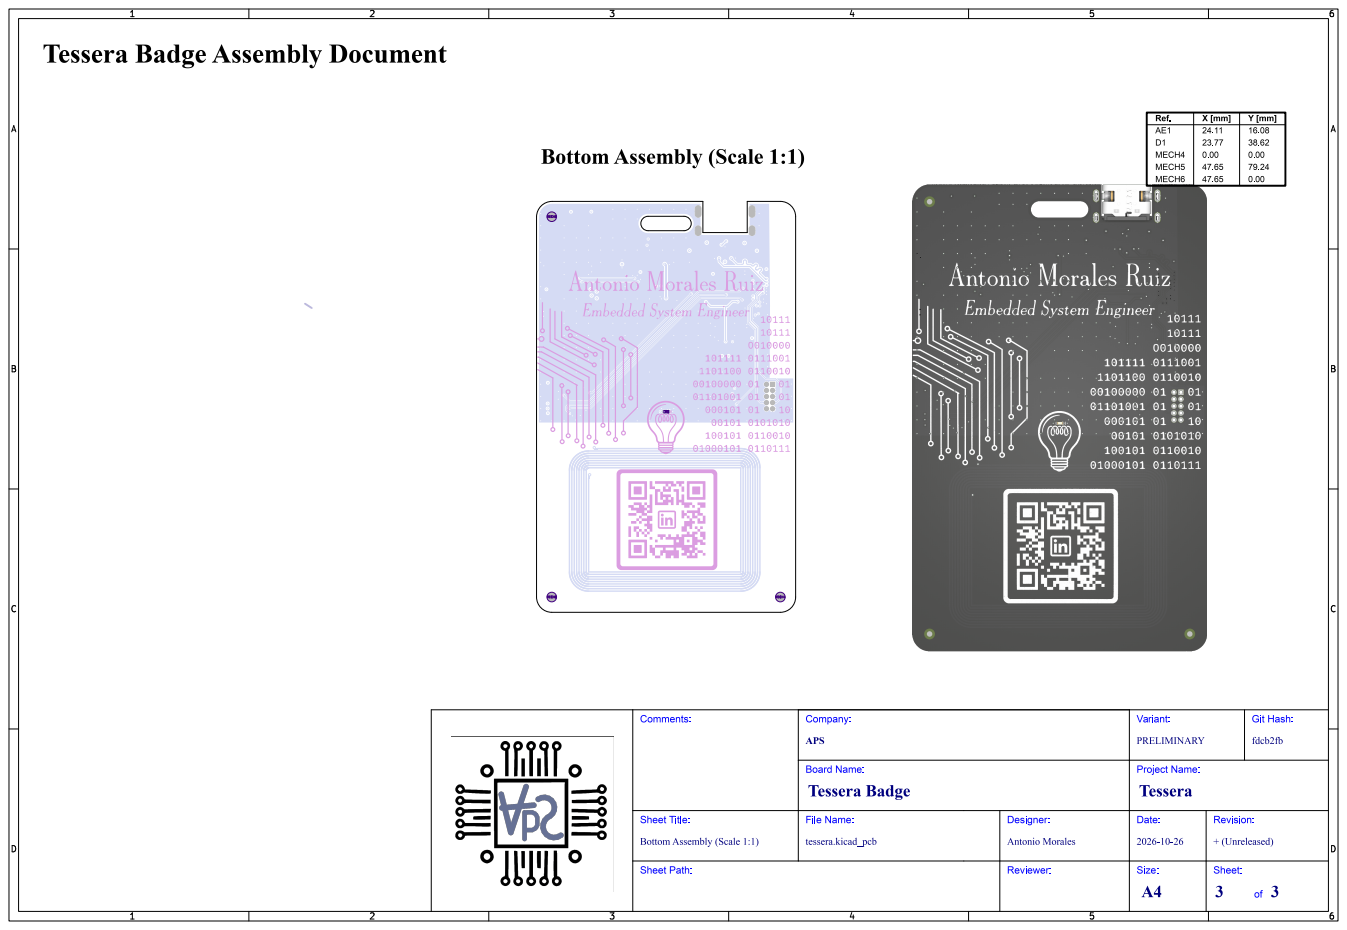
[picture p45: page 3]
Git; Hash:; fdcb2fb; Comments:; Sheet Path:; Sheet Title:; File Name:; Tessera Badge; Tessera; APS; Company:; PRELIMINARY; Variant:; Board Name:; tessera.kicad_pcb; Antonio Morales; Designer:; Reviewer:; Project Name:; Date:; + (Unreleased); Revision:; Size:; Sheet:; MECH5; MECH6; MECH4

Bottom Assembly (Scale 1:1)
