AntonioMR/tessera-hw/Manufacturing/Fabrication/tessera-fabrication-2.pdf

# Bottom Fabrication (Scale 1:1)

# Tessera Badge Fabrication Document

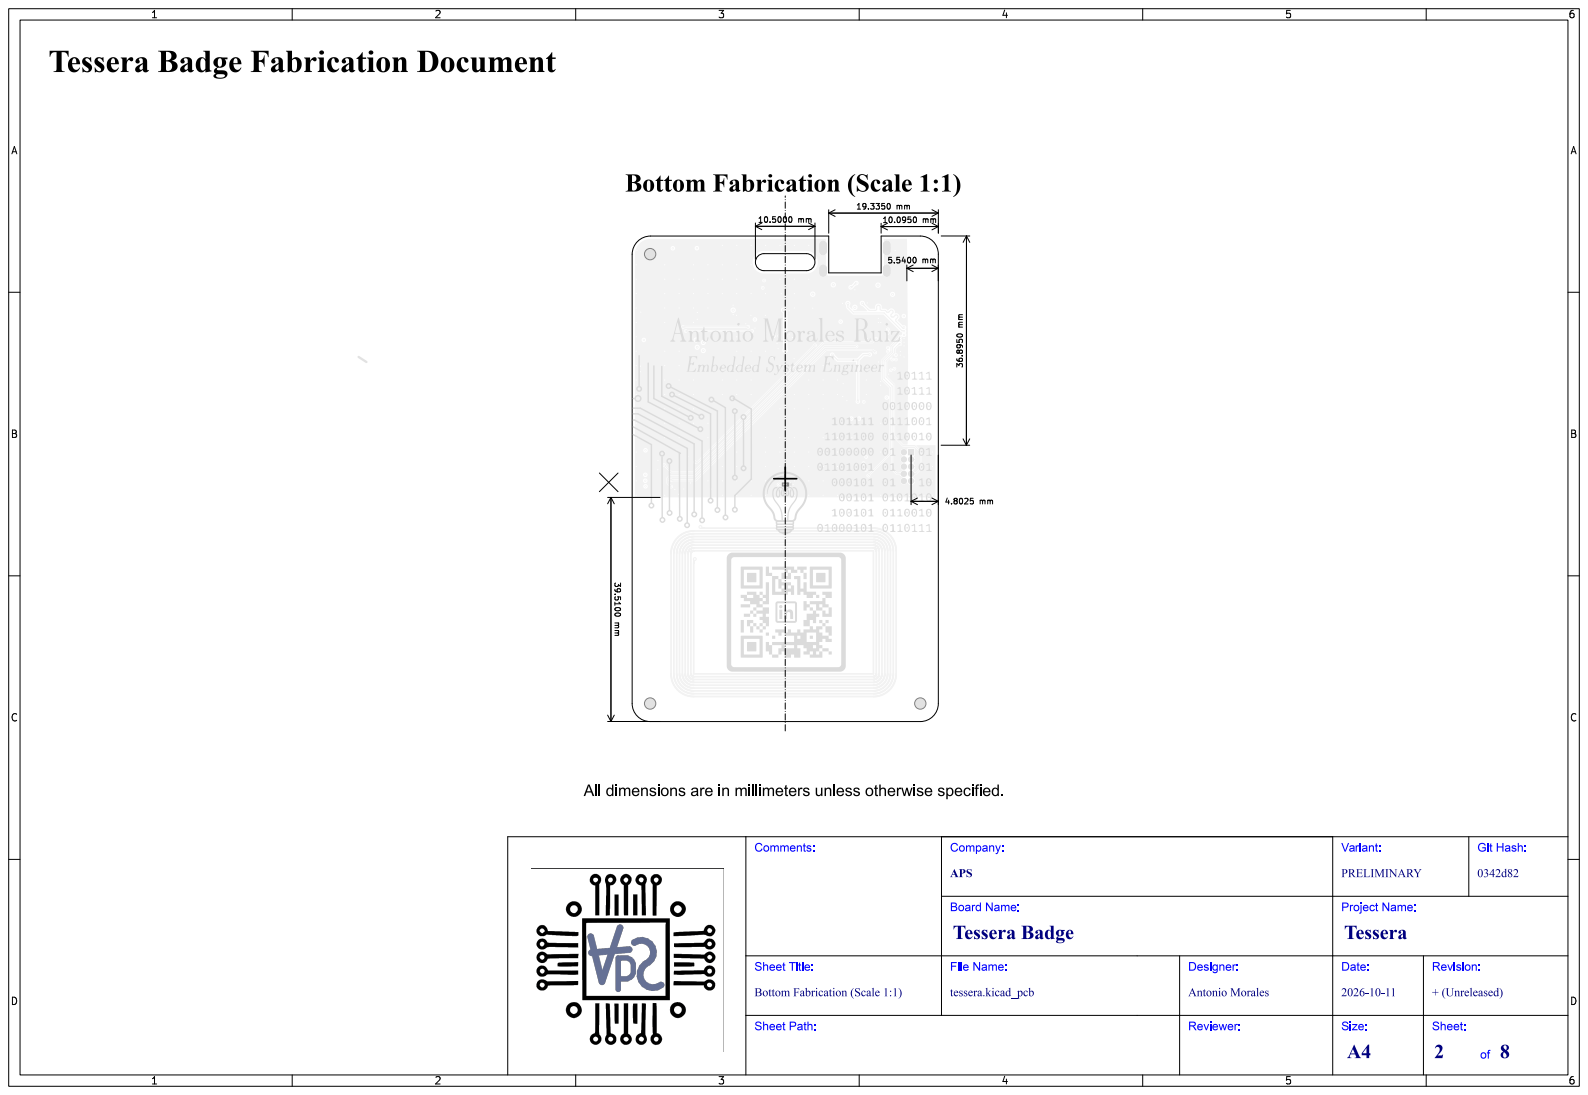
[picture p46: page 1]
Git; Hash:; Comments:; Sheet Path:; Sheet Title:; File Name:; Tessera Badge; Tessera; APS; Company:; PRELIMINARY; Variant:; Board Name:; tessera.kicad_pcb; Antonio Morales; Designer:; Reviewer:; Project Name:; Date:; + (Unreleased); Revision:; Size:; Sheet: 2

Bottom Fabrication (Scale 1:1)
