AntonioMR/tessera-hw/Manufacturing/Fabrication/tessera-fabrication-5.pdf

# L1 (Sig, PWR) (Scale 1:1)

# Tessera Badge Fabrication Document

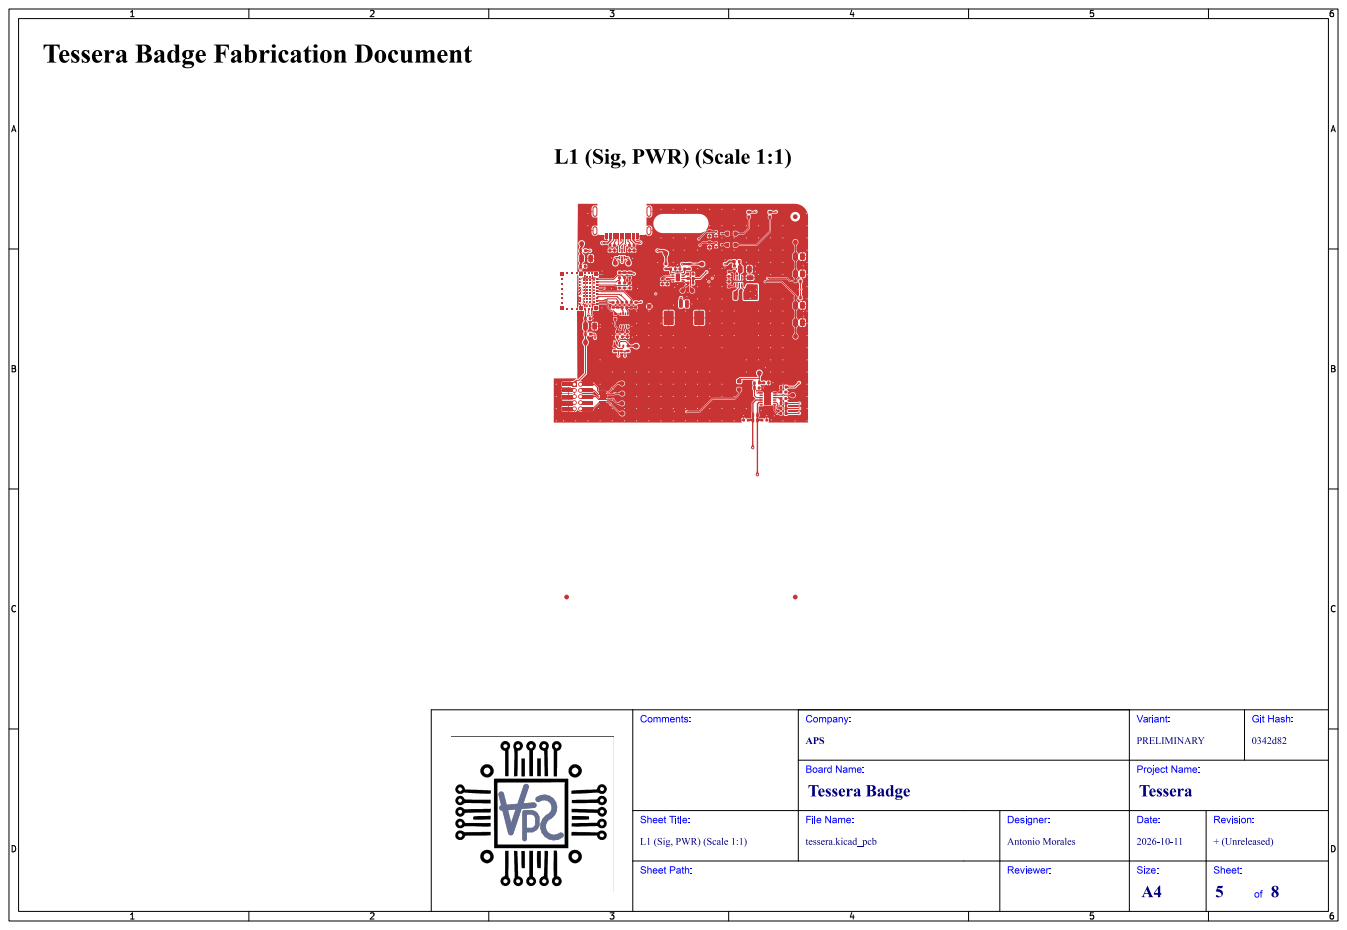
[picture p47: page 1]
Git; Hash:; Comments:; Sheet Path:; Sheet Title:; File Name:; Tessera Badge; Tessera; APS; Company:; PRELIMINARY; Variant:; Board Name:; tessera.kicad_pcb; Antonio Morales; Designer:; Reviewer:; Project Name:; Date:; + (Unreleased); Revision:; Size:; Sheet: 5

L1 (Sig, PWR) (Scale 1:1)
