AntonioMR/tessera-hw/Manufacturing/Fabrication/tessera-fabrication-8.pdf

# L4 (Sig, PWR) (Scale 1:1)

# Tessera Badge Fabrication Document

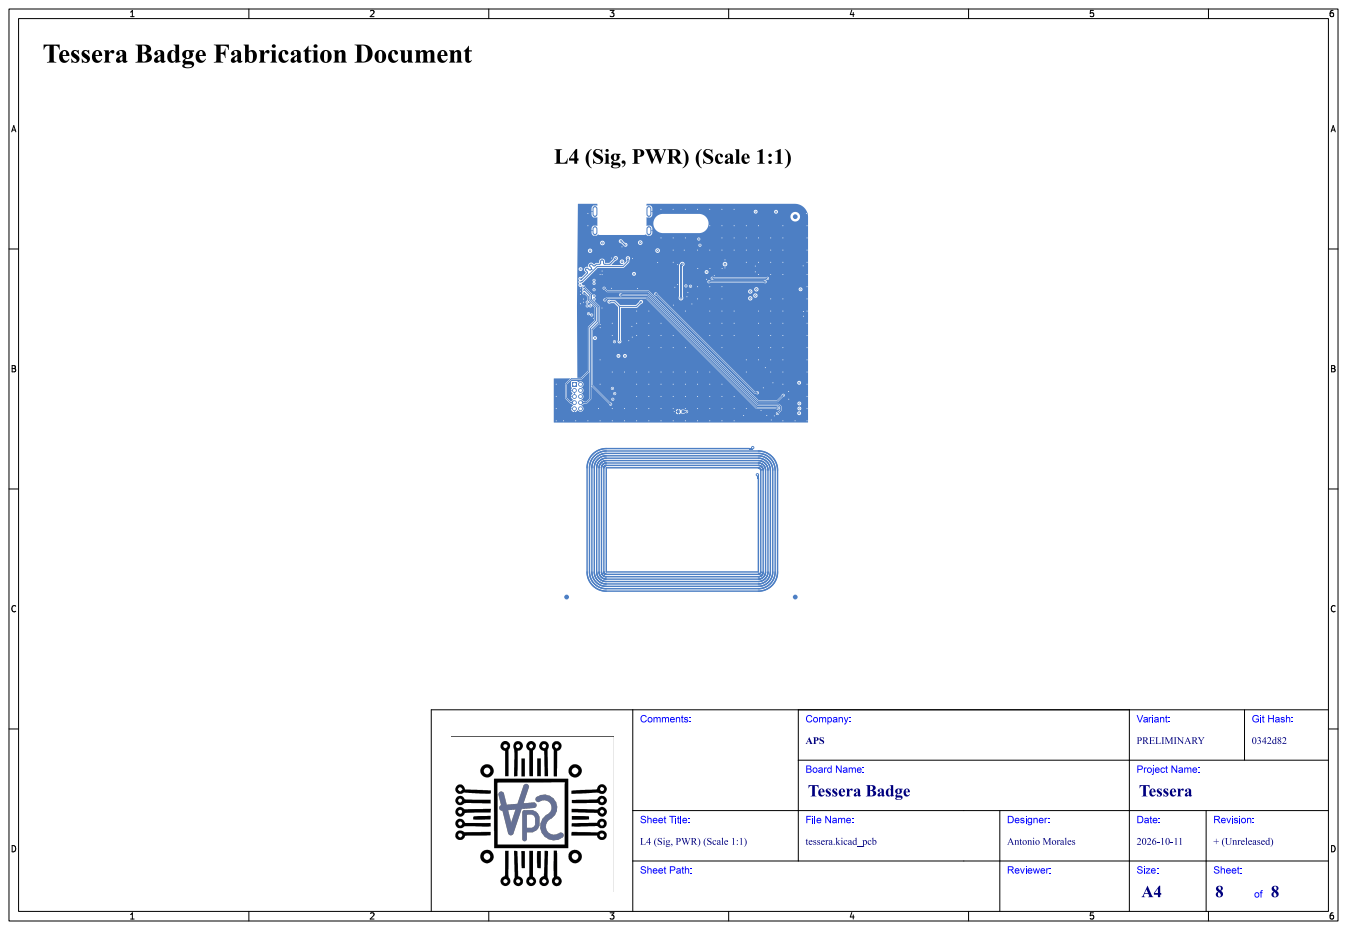
[picture p49: page 1]
Git; Hash:; Comments:; Sheet Path:; Sheet Title:; File Name:; Tessera Badge; Tessera; APS; Company:; PRELIMINARY; Variant:; Board Name:; tessera.kicad_pcb; Antonio Morales; Designer:; Reviewer:; Project Name:; Date:; + (Unreleased); Revision:; Size:; Sheet: 8

L4 (Sig, PWR) (Scale 1:1)
