AntonioMR/tessera-hw/Manufacturing/Fabrication/tessera-fabrication-1.pdf

# Top Fabrication (Scale 1:1)

# Tessera Badge Fabrication Document

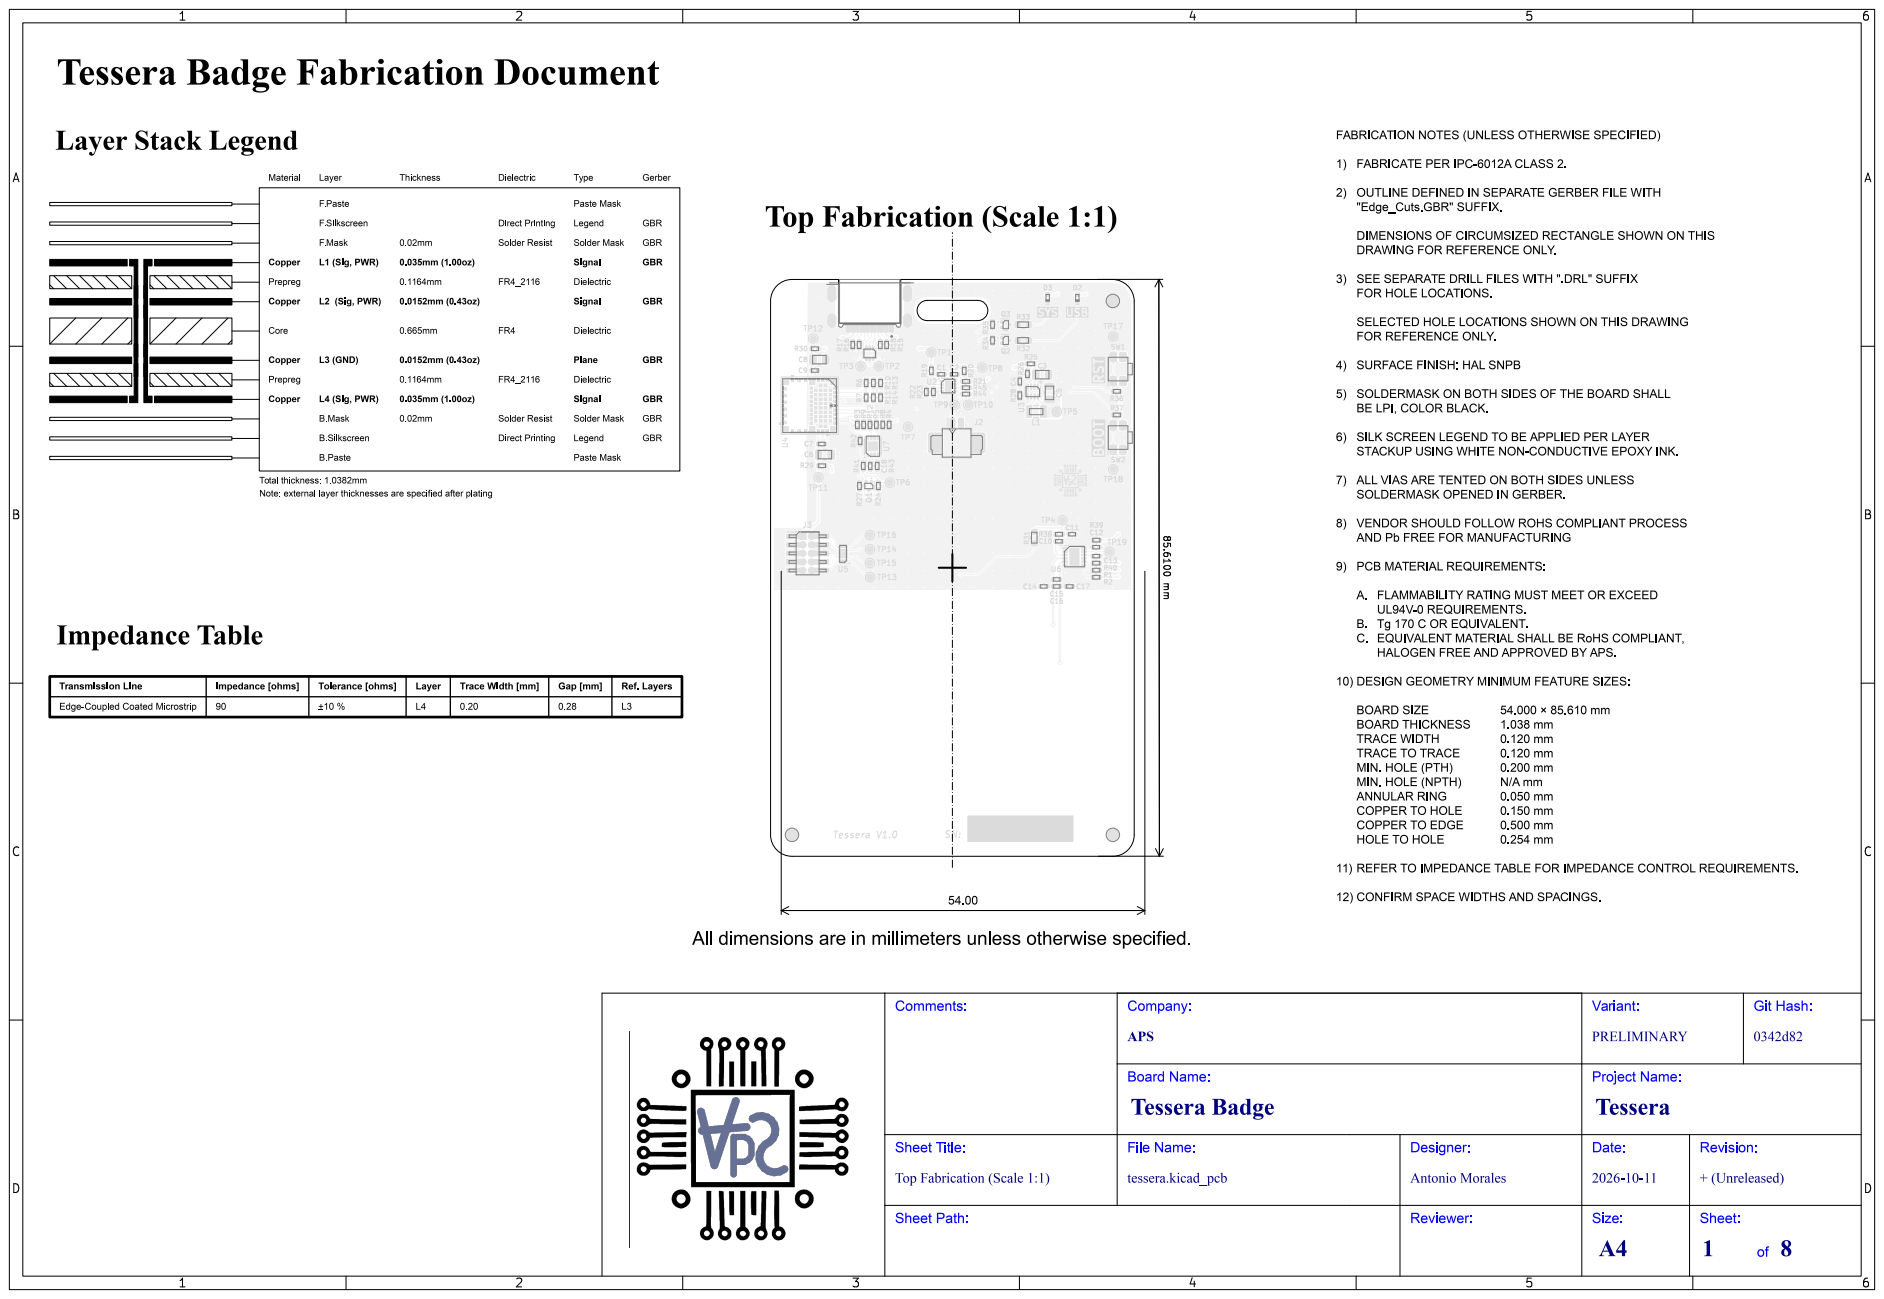
[picture p50: page 1]
