AntonioMR/tessera-hw/Manufacturing/Fabrication/tessera-fabrication-4.pdf

# Top Test Points (Scale 1:1)

# Tessera Badge Fabrication Document

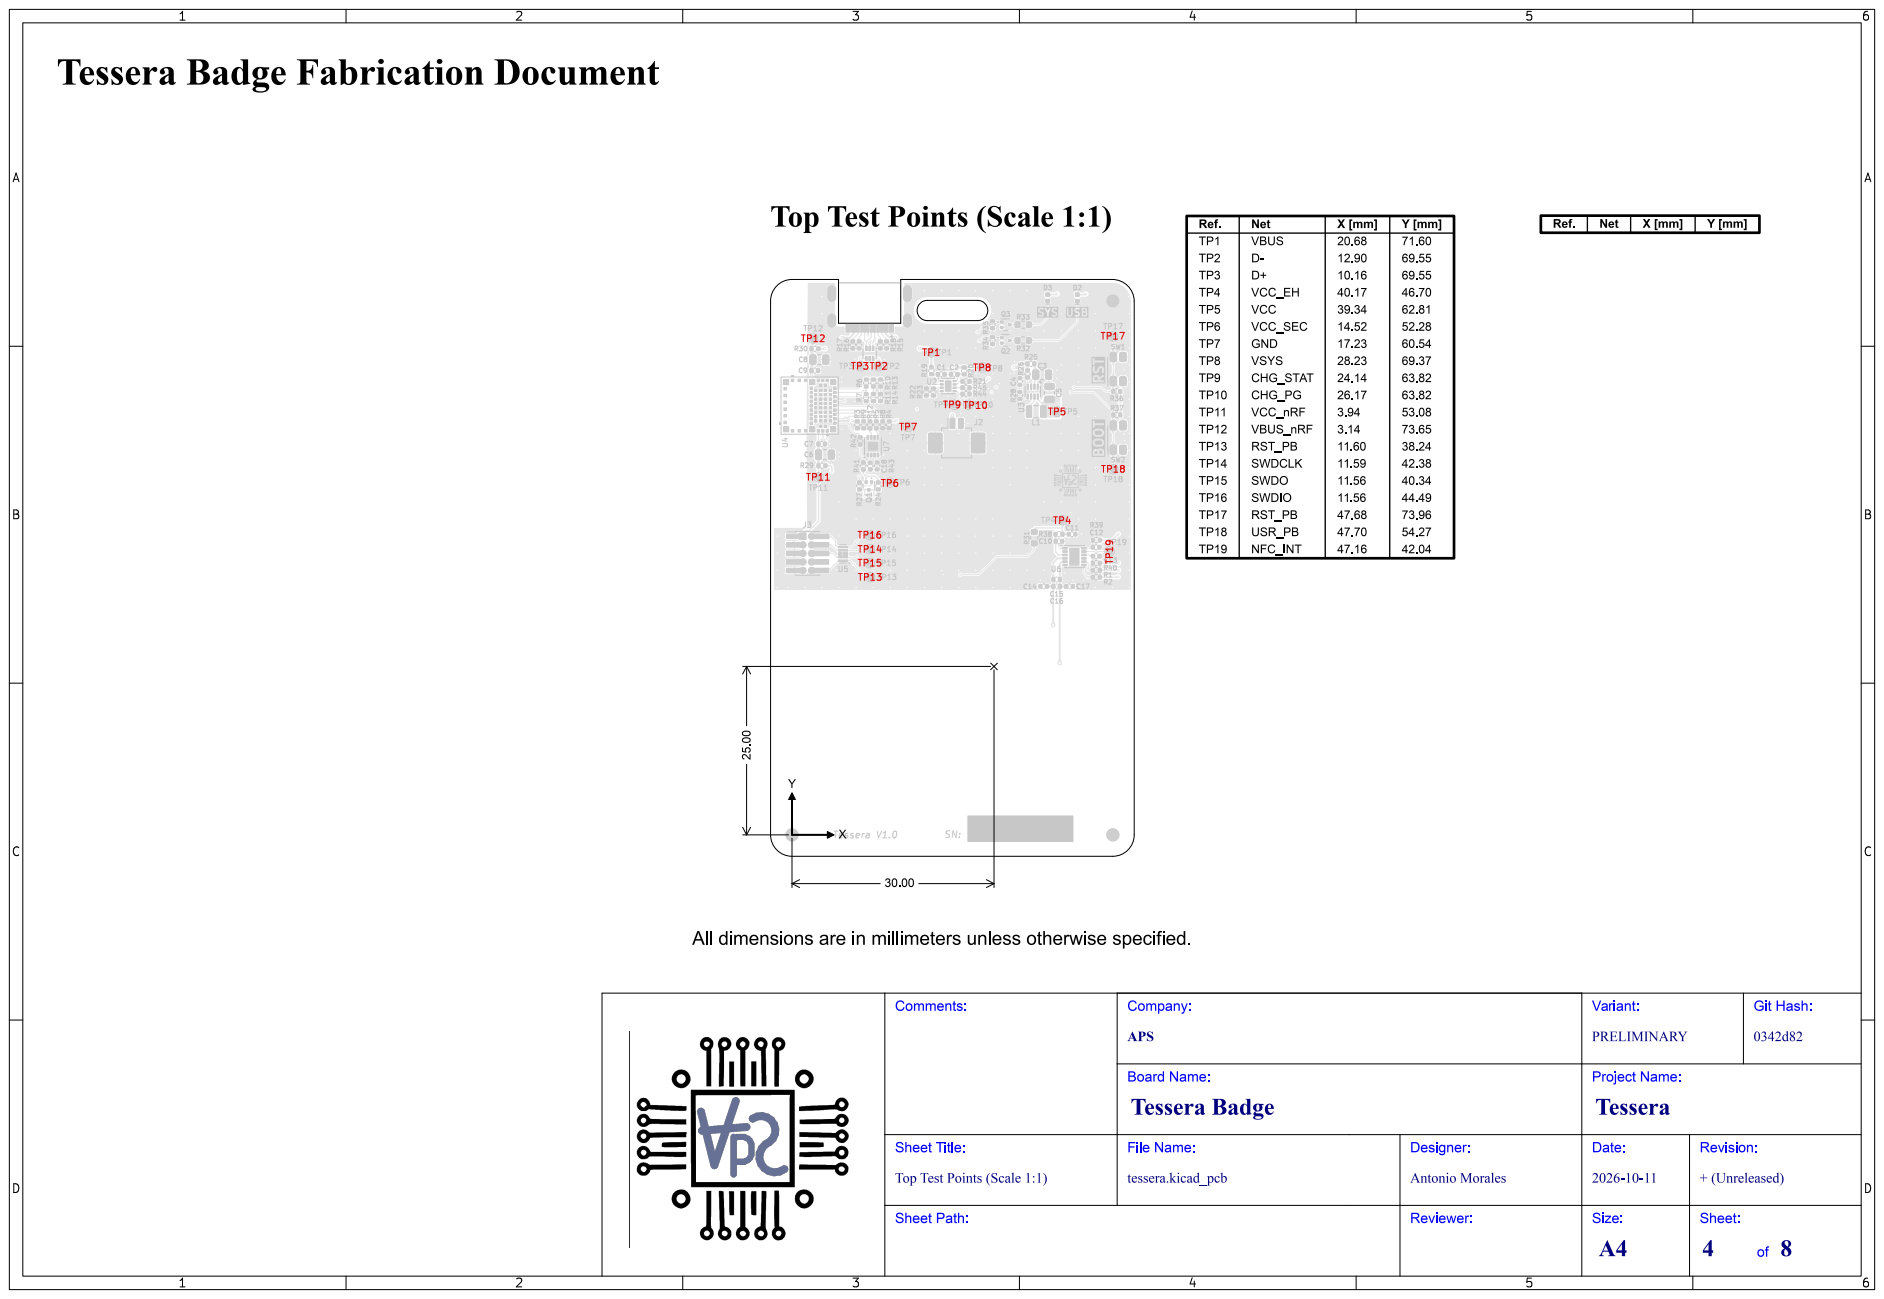
[picture p51: page 1]

Top Test Points (Scale 1:1)
