AntonioMR/tessera-hw/Manufacturing/Fabrication/Gerbers/tessera-NPTH_drill_map.pdf

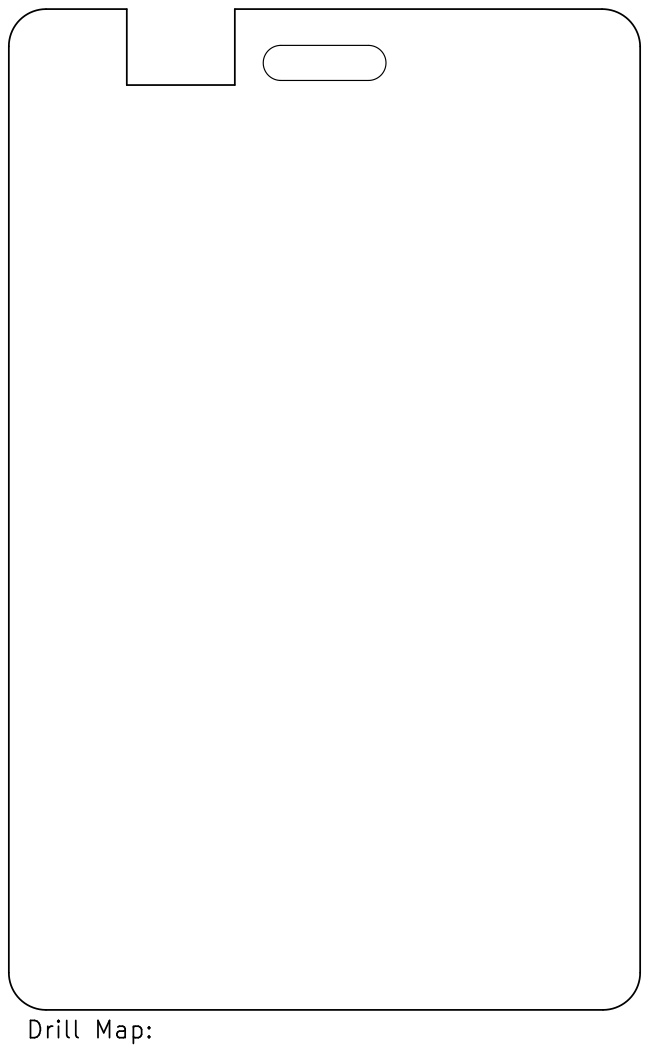
[picture p52: page 1]
