AntonioMR/tessera-hw/Manufacturing/Fabrication/Gerbers/tessera-PTH_drill_map.pdf

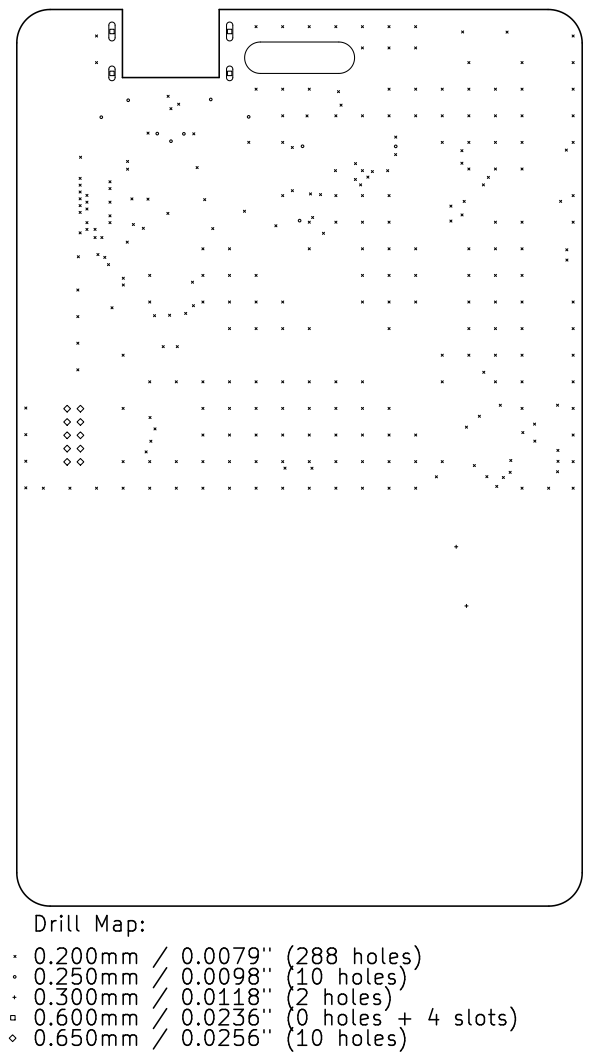
[picture p53: page 1]
