AntonioMR/tessera-hw/tessera.kicad_pcb

## KiCad design tessera.kicad_pcb (2026-10-26)

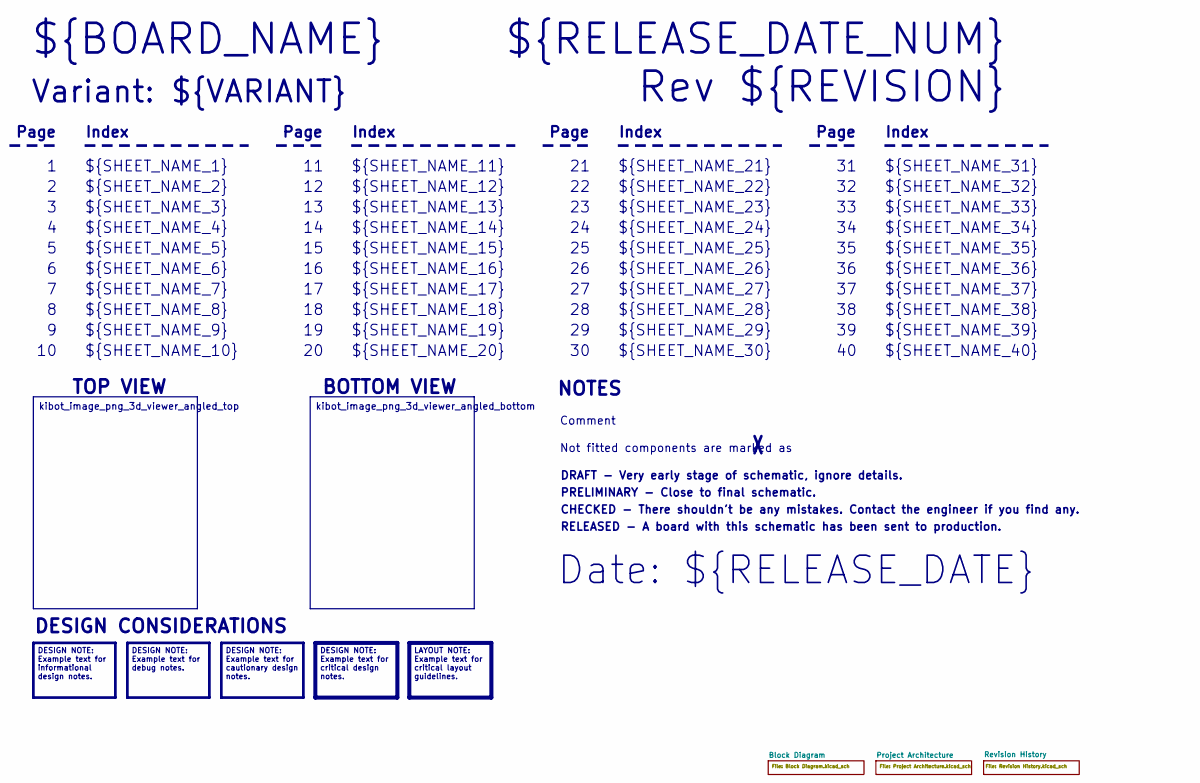
[picture p54: schematic tessera.kicad_sch, Front Page]

Notes on the sheet:
DESIGN NOTE: Example text for cautionary design notes.
DESIGN NOTE: Example text for debug notes.
DESIGN NOTE: Example text for critical design notes.
LAYOUT NOTE: Example text for critical layout guidelines.
kibot_image_png_3d_viewer_angled_bottom
DESIGN NOTE: Example text for informational design notes.
kibot_image_png_3d_viewer_angled_top
Variant: ${VARIANT}
RELEASED - A board with this schematic has been sent to production.
${SHEET_NAME_24}
Index
Page
PRELIMINARY - Close to final schematic.
${SHEET_NAME_22}
DRAFT - Very early stage of schematic, ignore details.
${SHEET_NAME_12}
${SHEET_NAME_8}
${SHEET_NAME_2}
${SHEET_NAME_5}
${SHEET_NAME_20}
${SHEET_NAME_23}
${RELEASE_DATE_NUM}
${SHEET_NAME_35}
Not fitted components are marked as
${SHEET_NAME_11}
${SHEET_NAME_6}
${SHEET_NAME_37}
${SHEET_NAME_26}
${SHEET_NAME_36}
Rev ${REVISION}
${SHEET_NAME_15}
CHECKED - There shouldn't be any mistakes. Contact the engineer if you find any.
BOTTOM VIEW
${SHEET_NAME_14}
${SHEET_NAME_21}
${SHEET_NAME_17}
${SHEET_NAME_18}
Date: ${RELEASE_DATE}
${SHEET_NAME_7}
${SHEET_NAME_31}
${BOARD_NAME}
NOTES
${SHEET_NAME_40}
${SHEET_NAME_39}
${SHEET_NAME_32}
${SHEET_NAME_1}
${SHEET_NAME_9}
${SHEET_NAME_38}
${SHEET_NAME_29}
${SHEET_NAME_34}
${SHEET_NAME_16}
${SHEET_NAME_3}
${SHEET_NAME_19}
Comment
TOP VIEW
${SHEET_NAME_10}
${SHEET_NAME_28}
${SHEET_NAME_13}
${SHEET_NAME_27}
${SHEET_NAME_4}
${SHEET_NAME_33}
${SHEET_NAME_30}
${SHEET_NAME_25}
DESIGN CONSIDERATIONS

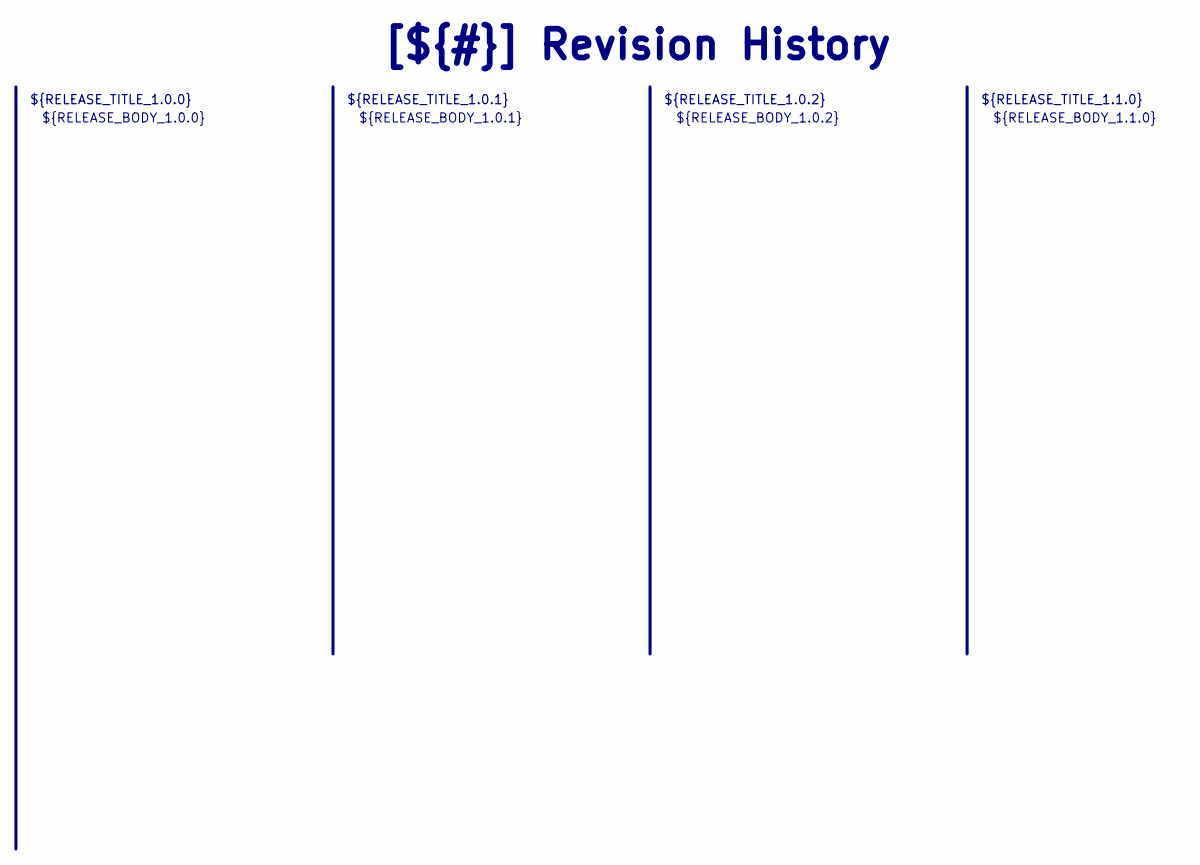
[picture p55: schematic Revision History.kicad_sch]

Notes on the sheet:
${RELEASE_BODY_1.1.0}
[${#}] ${TITLE}
${RELEASE_BODY_1.0.0}
${RELEASE_TITLE_1.0.2}
${RELEASE_BODY_1.0.2}
${RELEASE_BODY_1.0.1}
${RELEASE_TITLE_1.0.0}
${RELEASE_TITLE_1.0.1}
${RELEASE_TITLE_1.1.0}

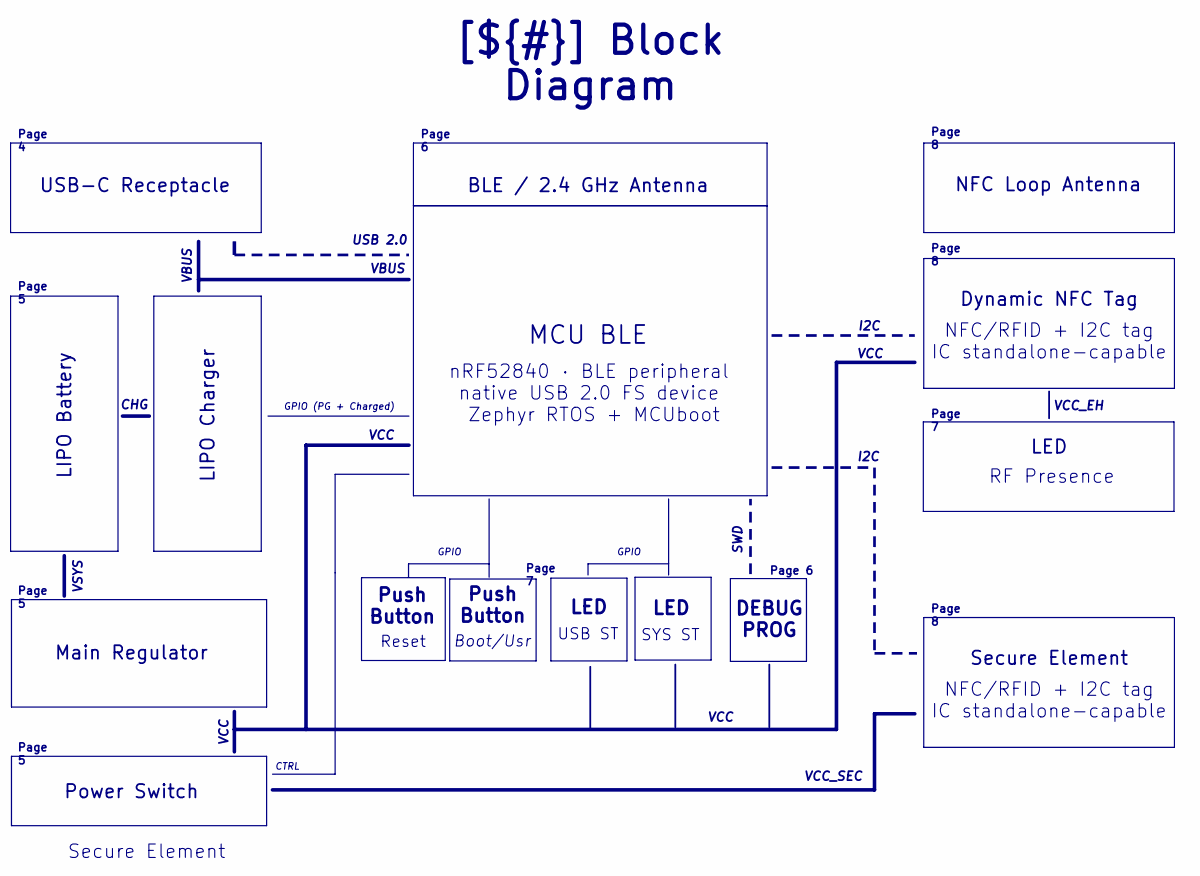
[picture p56: schematic Block Diagram.kicad_sch]

Notes on the sheet:
Page 5
Page 6
Page 7
[${#}] ${TITLE}
Page 4
Page 8
Reset
LED
VCC
NFC/RFID + I2C tag IC standalone-capable
USB ST
LIPO Battery
Boot/Usr
I2C
VCC_EH
Dynamic NFC Tag
VBUS
VSYS
CTRL
Secure Element
SYS ST
MCU BLE
BLE / 2.4 GHz Antenna
USB-C Receptacle
Main Regulator
GPIO
GPIO (PG + Charged)
VCC_SEC
Push Button
SWD
LIPO Charger
CHG
NFC Loop Antenna
Secure Element
USB 2.0
nRF52840 · BLE peripheral native USB 2.0 FS device Zephyr RTOS + MCUboot
RF Presence
DEBUG PROG
Power Switch

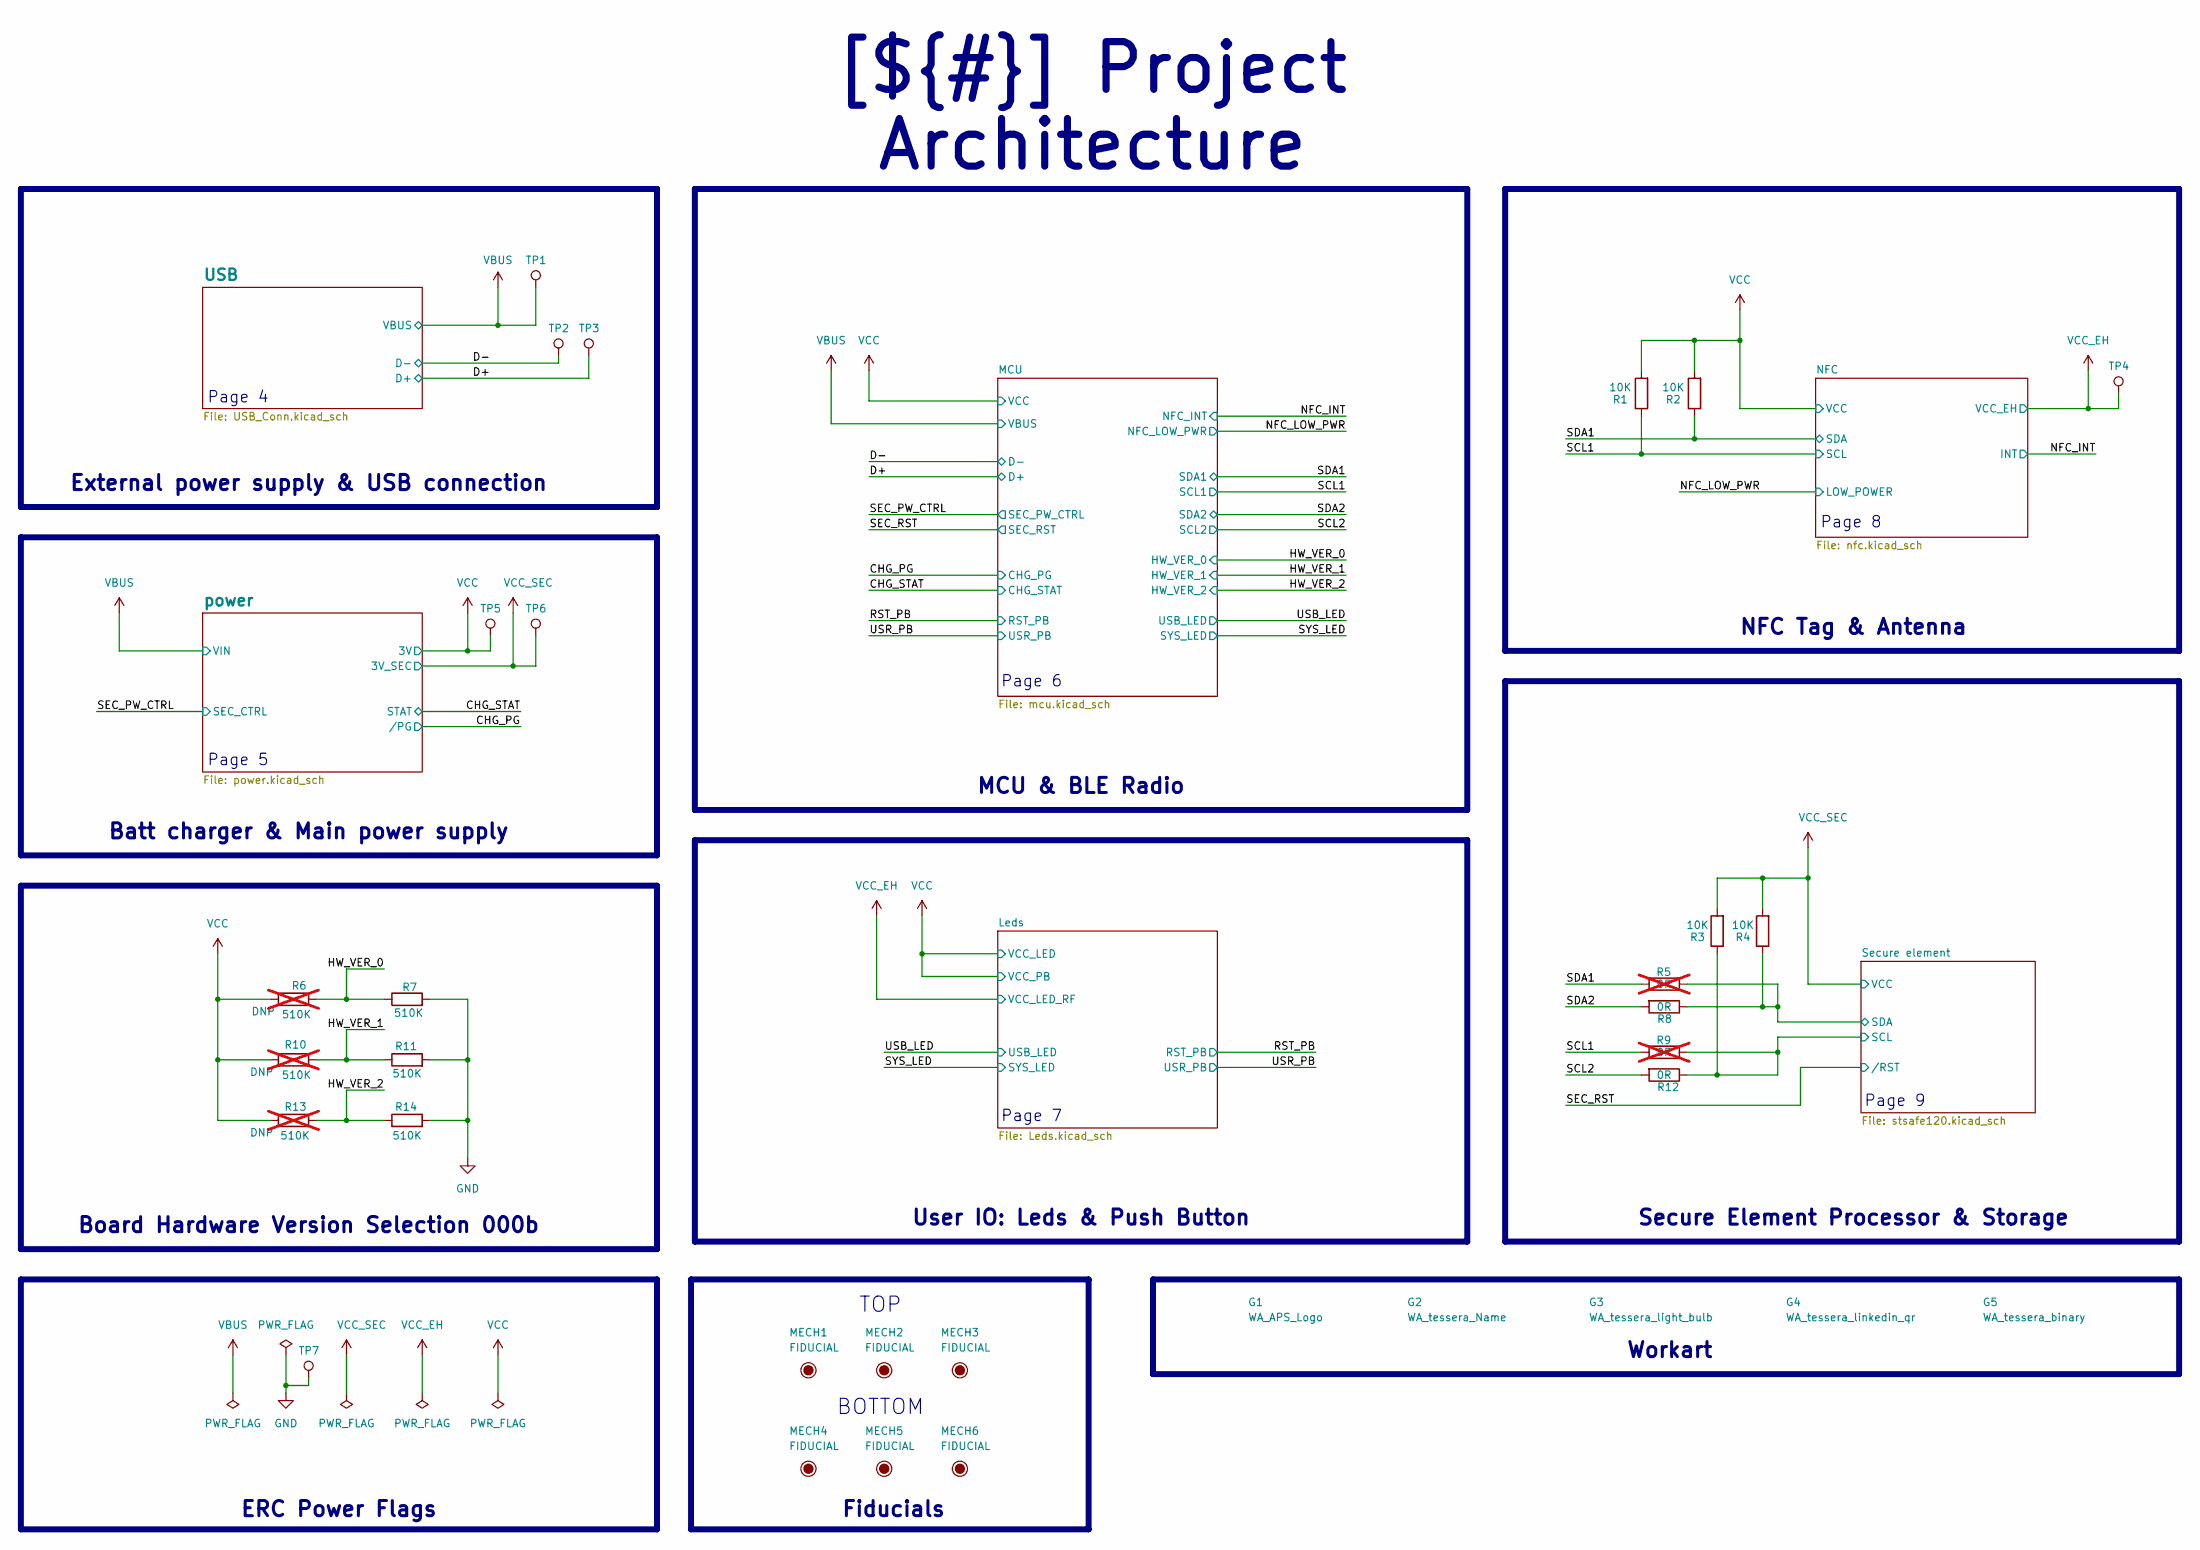
[picture p57: schematic Project Architecture.kicad_sch]

Parts:
G1: WA_APS_Logo; logo_aps_4_5
G2: WA_tessera_Name; Name
G3: WA_tessera_light_bulb; light_bulb_8_7_12
G4: WA_tessera_linkedin_qr; linkedin_qr_with_linkedin_logo_inv
G5: WA_tessera_binary; bin_logo
MECH1, MECH2, MECH3, MECH4, MECH5, MECH6: FIDUCIAL; Fiducial_1mm_Mask2mm; Part Number FIDUCIAL_D1_0mm_Mask_2_0mm
R1, R2, R3, R4: 10 kOhms; R_0402_1005Metric; Tolerance ±1%; Part Number R0402_10K_0.063W_±1%
R5, R9: 0R ±5% 1/16W; R_0402_1005Metric; Part Number R0402_0R_0.1W_±5%; not fitted
R6, R10, R13: 510 kOhms; R_0402_1005Metric; Tolerance ±1%; Part Number R0402_510K_0.063W_±1%; not fitted
R7, R11, R14: 510 kOhms; R_0402_1005Metric; Tolerance ±1%; Part Number R0402_510K_0.063W_±1%
R8, R12: 0R ±5% 1/16W; R_0402_1005Metric; Part Number R0402_0R_0.1W_±5%
TP1, TP2, TP3, TP4, TP5, TP6, TP7: TP; TestPoint_Pad_D1.0mm; Part Number TP_SMD_D1_0mm

Connections:
/Project Architecture/D+: TP3.1; also elsewhere on the board
/Project Architecture/D-: TP2.1; also elsewhere on the board
/Project Architecture/HW_VER_0: R6.2, R7.1; also elsewhere on the board
/Project Architecture/HW_VER_1: R10.2, R11.1; also elsewhere on the board
/Project Architecture/HW_VER_2: R13.2, R14.1; also elsewhere on the board
/Project Architecture/SCL1: R1.1, R9.1; also elsewhere on the board
/Project Architecture/SCL2: R12.2; also elsewhere on the board
/Project Architecture/SDA1: R2.1, R5.1; also elsewhere on the board
/Project Architecture/SDA2: R8.2; also elsewhere on the board
/Project Architecture/Secure element/SCL: R3.1, R9.2, R12.1; also elsewhere on the board
/Project Architecture/Secure element/SDA: R4.1, R5.2, R8.1; also elsewhere on the board
GND: R7.2, R11.2, R14.2, TP7.1; also elsewhere on the board
VBUS: TP1.1; also elsewhere on the board
VCC: R1.2, R2.2, R6.1, R10.1, R13.1, TP5.1; also elsewhere on the board
VCC_EH: TP4.1; also elsewhere on the board
VCC_SEC: R3.2, R4.2, TP6.1; also elsewhere on the board

Notes on the sheet:
Board Hardware Version Selection 000b
NFC Tag & Antenna
MCU & BLE Radio
User IO: Leds & Push Button
BOTTOM
TOP
Batt charger & Main power supply
Secure Element Processor & Storage
ERC Power Flags
External power supply & USB connection
Fiducials
Workart
[${#}] ${TITLE}
Page 9
Page 7
Page 6
Page 5
Page 8
Page 4

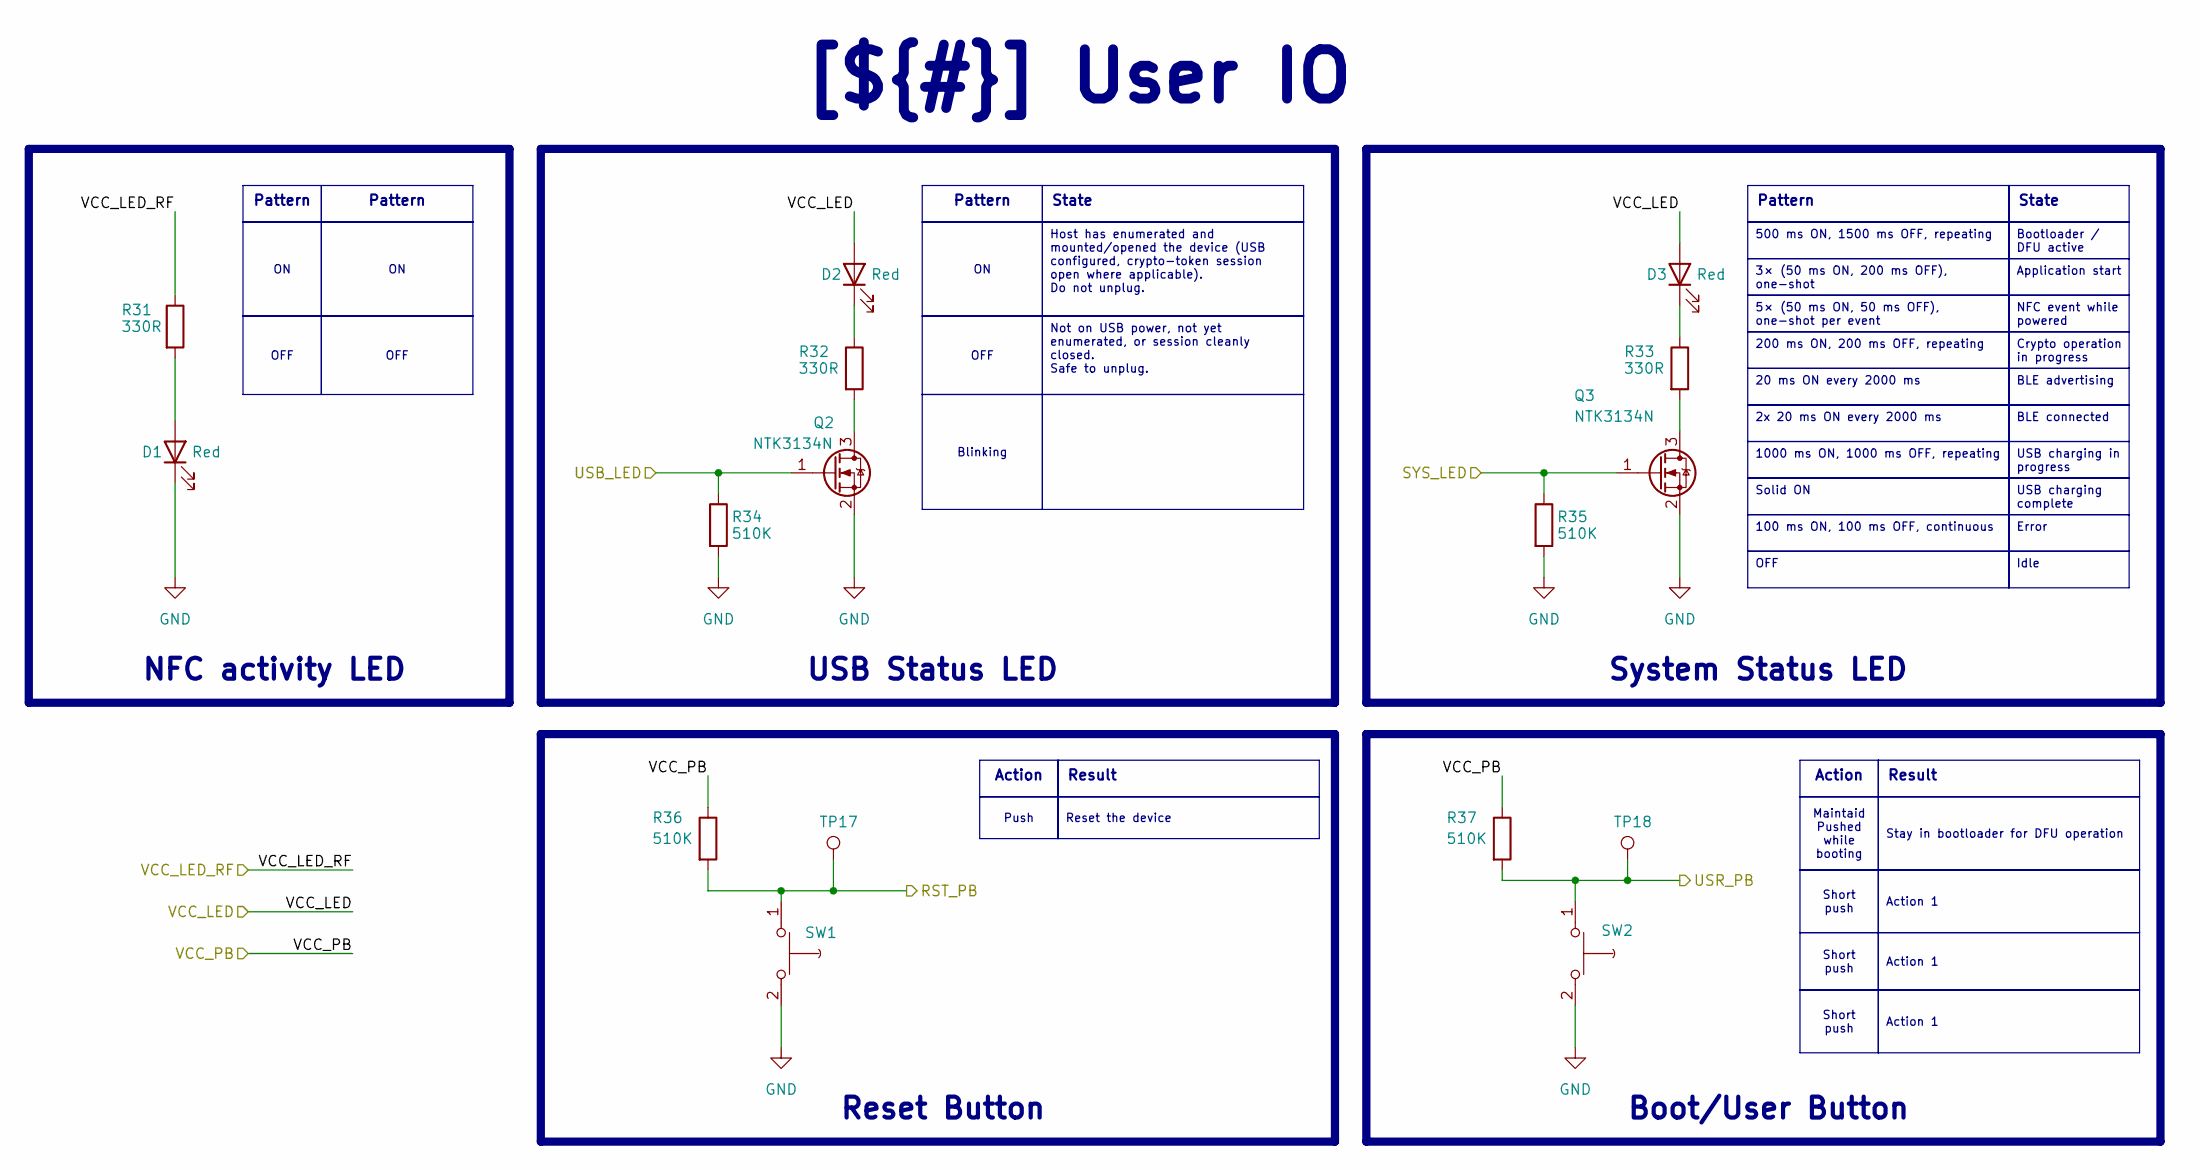
[picture p58: schematic Leds.kicad_sch, User IO]

Parts:
D1, D2, D3: APHHS1005SURCK; LED_0402_1005Metric; Part Number APHHS1005SURCK
Q2, Q3: NTK3134N; SOT-723; Part Number NTK3134N
R31, R32, R33: 330R ±1% 1/10W; R_0603_1608Metric; Tolerance ±1%; Part Number R0603_330R_0.1W_±1%
R34, R35, R36, R37: 510 kOhms; R_0402_1005Metric; Tolerance ±1%; Part Number R0402_510K_0.063W_±1%
SW1, SW2: EVQP7A01P; Panasonic_switch_EVQP7K_EVQP7A; Part Number EVQP7A01P
TP17, TP18: TP; TestPoint_Pad_D1.0mm; Part Number TP_SMD_D1_0mm

Connections:
/Project Architecture/RST_PB: R36.2, SW1.1, TP17.1; also elsewhere on the board
/Project Architecture/SYS_LED: Q3.1 (G), R35.1; also elsewhere on the board
/Project Architecture/USB_LED: Q2.1 (G), R34.1; also elsewhere on the board
/Project Architecture/USR_PB: R37.2, SW2.1, TP18.1; also elsewhere on the board
GND: D1.1 (K), Q2.2 (S), Q3.2 (S), R34.2, R35.2, SW1.2, SW2.2; also elsewhere on the board
unnamed: D1.2 (A), R31.2
unnamed: D2.1 (K), R32.1
unnamed: D3.1 (K), R33.1
unnamed: Q2.3 (D), R32.2
unnamed: Q3.3 (D), R33.2
VCC: D2.2 (A), D3.2 (A), R36.1, R37.1; also elsewhere on the board
VCC_EH: R31.1; also elsewhere on the board

Notes on the sheet:
State
OFF
USB charging in progress
Application start
Error
3× (50 ms ON, 200 ms OFF), one-shot
Bootloader / DFU active
Result
Action 1
Short push
Blinking
Solid ON
BLE advertising
Pattern
100 ms ON, 100 ms OFF, continuous
Reset the device
NFC activity LED
USB Status LED
Idle
Action
20 ms ON every 2000 ms
[${#}] ${TITLE}
Boot/User Button
Not on USB power, not yet enumerated, or session cleanly closed. Safe to unplug.
Crypto operation in progress
Host has enumerated and mounted/opened the device (USB configured, crypto-token session open where applicable). Do not unplug.
System Status LED
Maintaid Pushed while booting
Push
Reset Button
2x 20 ms ON every 2000 ms
1000 ms ON, 1000 ms OFF, repeating
USB charging complete
NFC event while powered
BLE connected
500 ms ON, 1500 ms OFF, repeating
Stay in bootloader for DFU operation
200 ms ON, 200 ms OFF, repeating
5× (50 ms ON, 50 ms OFF), one-shot per event

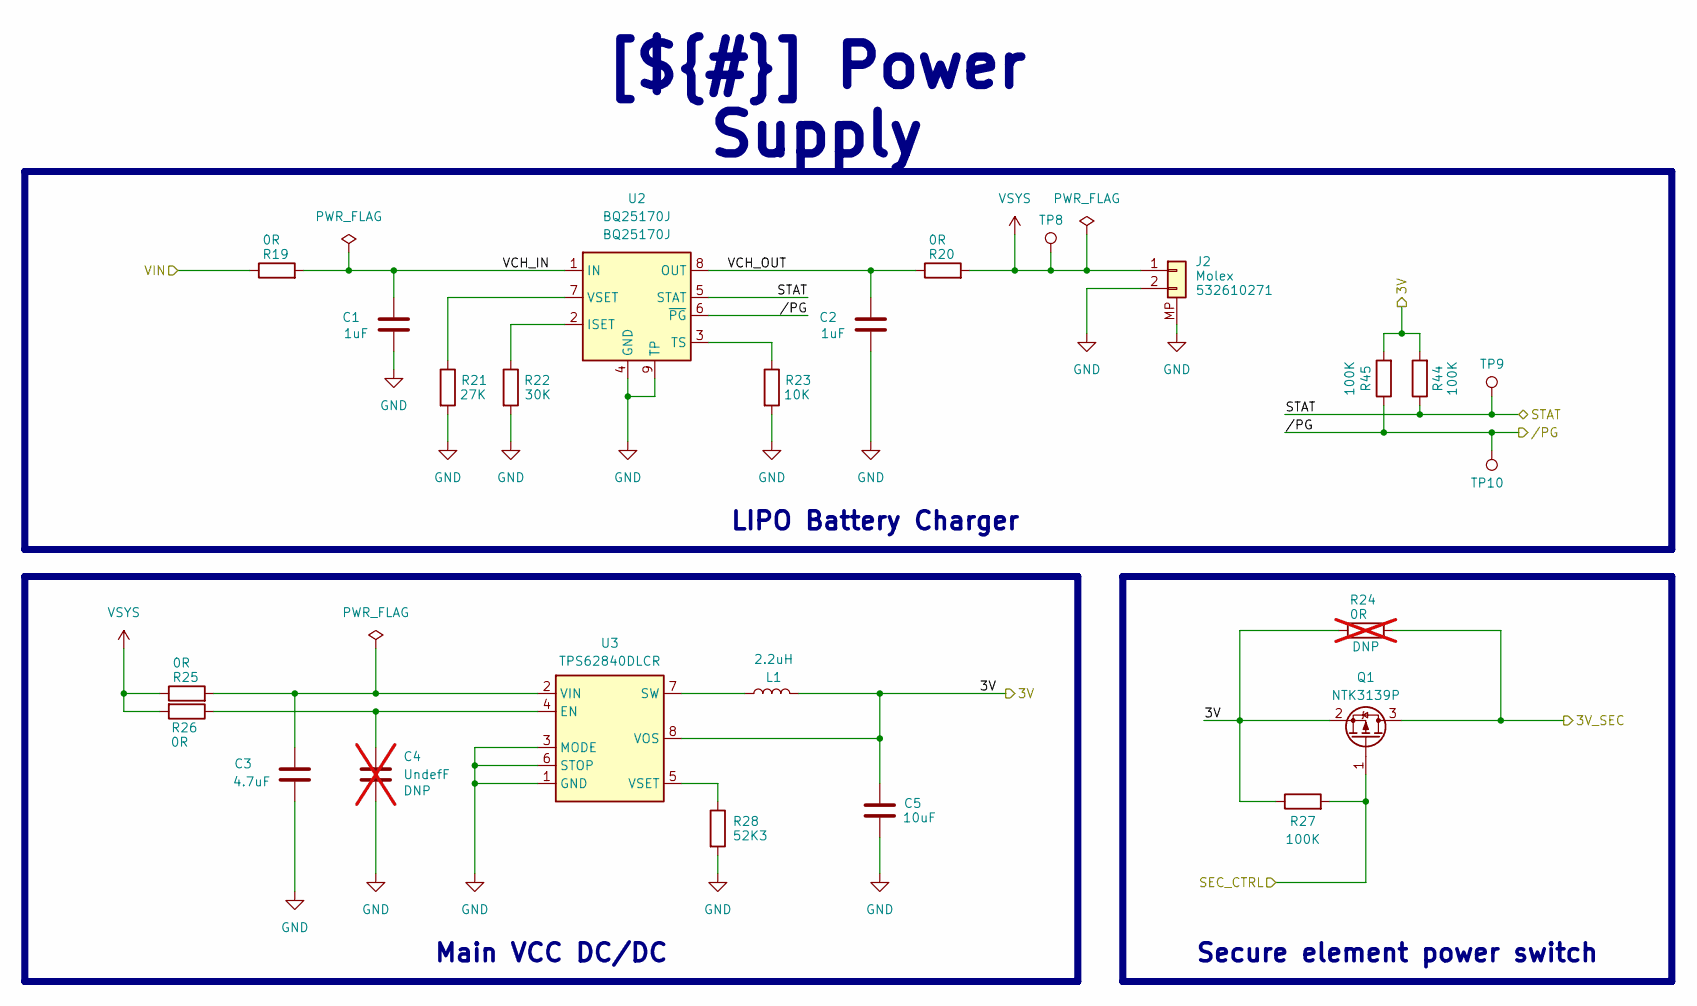
[picture p59: schematic power.kicad_sch, Power Supply]

Parts:
C1, C2: 1uF 6.3V (X5R); C_0402_1005Metric; Tolerance ±10%; Voltage 6.3V; Part Number C0402_1uF_6.3V_±10%_X5R
C3: 4.7uF 6.3V (X7R); C_0805_2012Metric; Tolerance ±10%; Voltage 6.3V; Part Number C0805_4.7uF_6.3V_±10%_X7R
C4: UndefF; C_0402_1005Metric; Part Number C0402_Undef; not fitted
C5: 10uF 10V (X7R); C_0805_2012Metric; Tolerance ±10%; Voltage 10V; Part Number C0805_10uF_10V_±10%_X7R
J2: 532610271; Molex_PicoBlade_53261-0271_1x02-1MP_P1.25mm_Horizontal; Voltage 125V; Part Number Molex_PicoBlade_532610271
L1: 2.2uH; L_0806_2016Metric; Tolerance ±20%; Part Number L0806_2.2uH_1.8A_±20%_116mOhm
Q1: NTK3139P; SOT-723; Part Number NTK3139P
R19, R20, R25, R26: 0R ±5% 1/16W; R_0402_1005Metric; Part Number R0402_0R_0.1W_±5%
R21: 27 kOhms; R_0402_1005Metric; Tolerance ±1%; Part Number R0402_27K_0.063W_±1%
R22: 30 kOhms; R_0402_1005Metric; Tolerance ±1%; Part Number R0402_30K_0.063W_±1%
R23: 10 kOhms; R_0402_1005Metric; Tolerance ±1%; Part Number R0402_10K_0.063W_±1%
R24: 0R ±5% 1/16W; R_0402_1005Metric; Part Number R0402_0R_0.1W_±5%; not fitted
R27, R44, R45: 100 kOhms; R_0402_1005Metric; Tolerance ±1%; Part Number R0402_100K_0.063W_±1%
R28: 52.3 kOhms; R_0402_1005Metric; Tolerance ±1%; Part Number R0402_52K3_0.063W_±1%
TP8, TP9, TP10: TP; TestPoint_Pad_D1.0mm; Part Number TP_SMD_D1_0mm
U2: BQ25170J; WSON-8-1EP_2x2mm_P0.5mm_EP0.9x1.6mm; Part Number BQ25170J
U3: TPS62840DLCR; Texas_VSON-HR-8_1.5x2mm_P0.5mm; Part Number TPS62840DLCR

Connections:
/Project Architecture/CHG_PG: R45.1, TP10.1, U2.6 (~PG); also elsewhere on the board
/Project Architecture/CHG_STAT: R44.1, TP9.1, U2.5 (STAT); also elsewhere on the board
/Project Architecture/SEC_PW_CTRL: Q1.1 (G), R27.2; also elsewhere on the board
/Project Architecture/power/VCH_IN: C1.1, R19.2, U2.1 (IN)
/Project Architecture/power/VCH_OUT: C2.1, R20.1, U2.8 (OUT)
GND: C1.2, C2.2, C3.2, C4.2, C5.2, J2.2, J2.MP, R21.2, R22.2, R23.2, R28.2, U2.4 (GND), U2.9 (TP), U3.1 (GND), U3.3 (MODE), U3.6 (STOP); also elsewhere on the board
unnamed: R22.1, U2.2 (ISET)
unnamed: R23.1, U2.3 (TS)
unnamed: R21.1, U2.7 (VSET)
unnamed: C4.1, R26.1, U3.4 (EN)
unnamed: L1.1, U3.7 (SW)
unnamed: C3.1, R25.2, U3.2 (VIN)
unnamed: R28.1, U3.5 (VSET)
VBUS: R19.1; also elsewhere on the board
VCC: C5.1, L1.2, Q1.2 (S), R24.1, R27.1, R44.2, R45.2, U3.8 (VOS); also elsewhere on the board
VCC_SEC: Q1.3 (D), R24.2; also elsewhere on the board
VSYS: J2.1, R20.2, R25.1, R26.2, TP8.1

Notes on the sheet:
LIPO Battery Charger
Secure element power switch
Main VCC DC/DC
[${#}] ${TITLE}

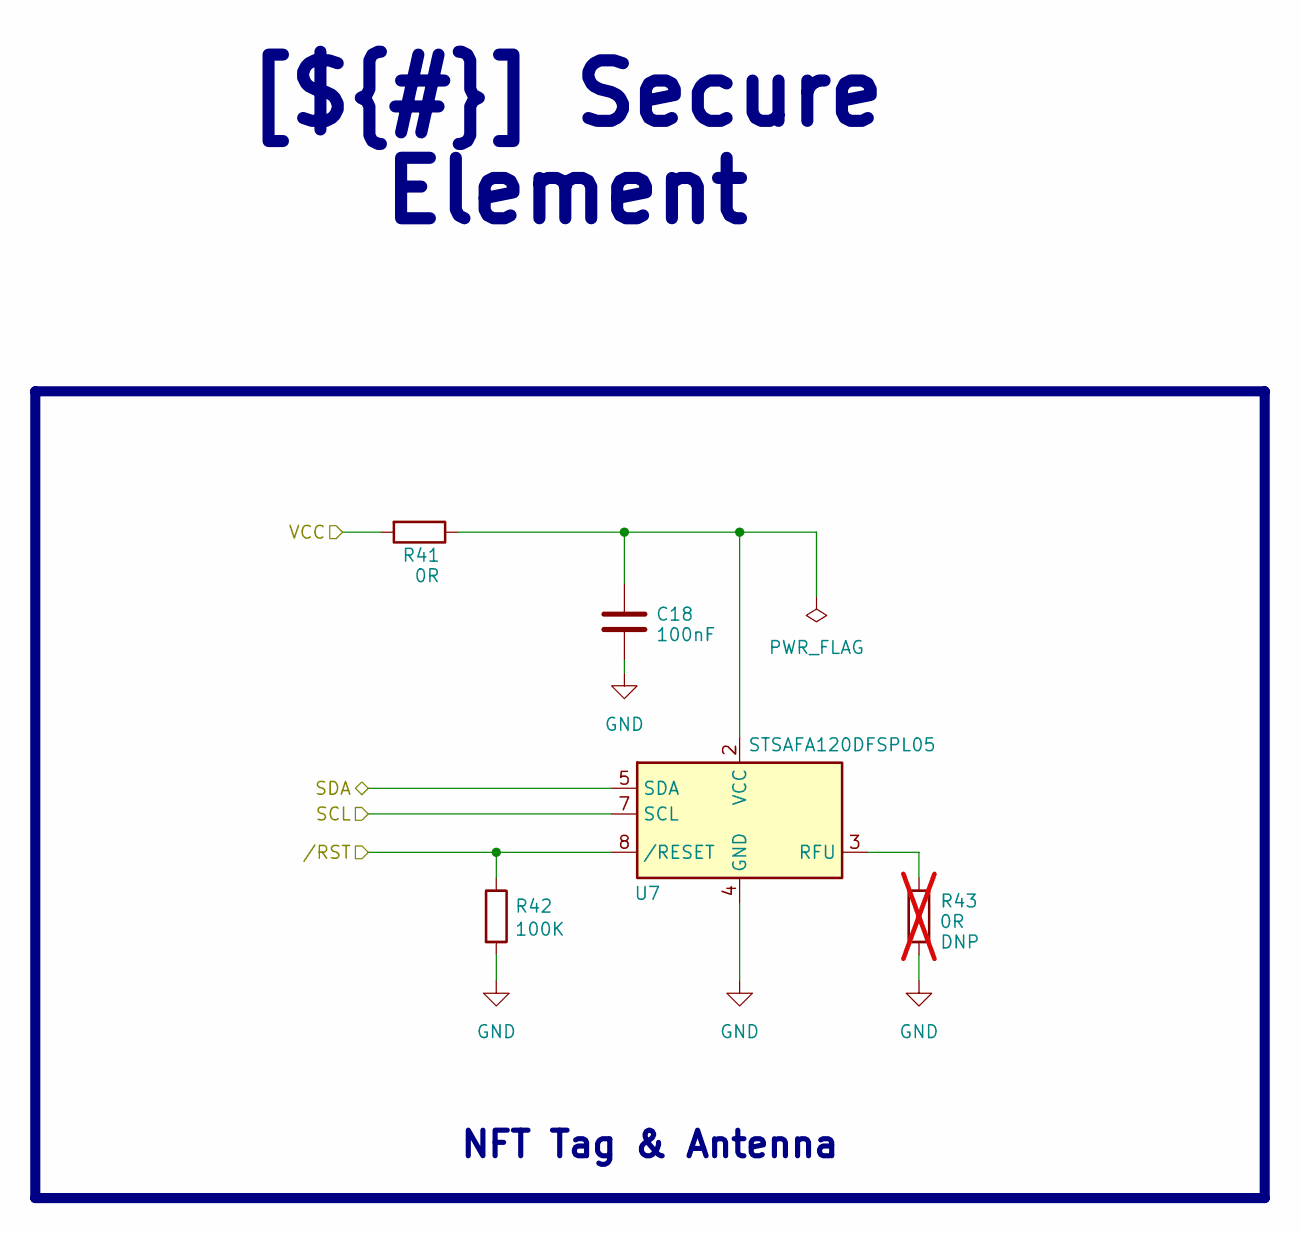
[picture p60: schematic stsafe120.kicad_sch, Secure Element]

Parts:
C18: 100nF 16V (X7R); C_0402_1005Metric; Tolerance ±10%; Voltage 16V; Part Number C0402_100nF_16V_±10%_X7R
R41: 0R ±5% 1/16W; R_0402_1005Metric; Part Number R0402_0R_0.1W_±5%
R42: 100 kOhms; R_0402_1005Metric; Tolerance ±1%; Part Number R0402_100K_0.063W_±1%
R43: 0R ±5% 1/16W; R_0402_1005Metric; Part Number R0402_0R_0.1W_±5%; not fitted
U7: STSAFA120DFSPL05; ST_UFDFPN-8-1EP_2x3mm_P0.5mm_EP1.4x2.55mm; Voltage 2.7-5.5 V; Part Number STSAFA120DFSPL05

Connections:
/Project Architecture/SEC_RST: R42.1, U7.8 (/RESET); also elsewhere on the board
/Project Architecture/Secure element/SCL: U7.7 (SCL); also elsewhere on the board
/Project Architecture/Secure element/SDA: U7.5 (SDA); also elsewhere on the board
GND: C18.2, R42.2, R43.2, U7.4 (GND), U7.9 (EP); also elsewhere on the board
unnamed: R43.1, U7.3 (RFU)
unnamed: C18.1, R41.1, U7.2 (VCC)
VCC_SEC: R41.2; also elsewhere on the board

Notes on the sheet:
[${#}] ${TITLE}
NFT Tag & Antenna

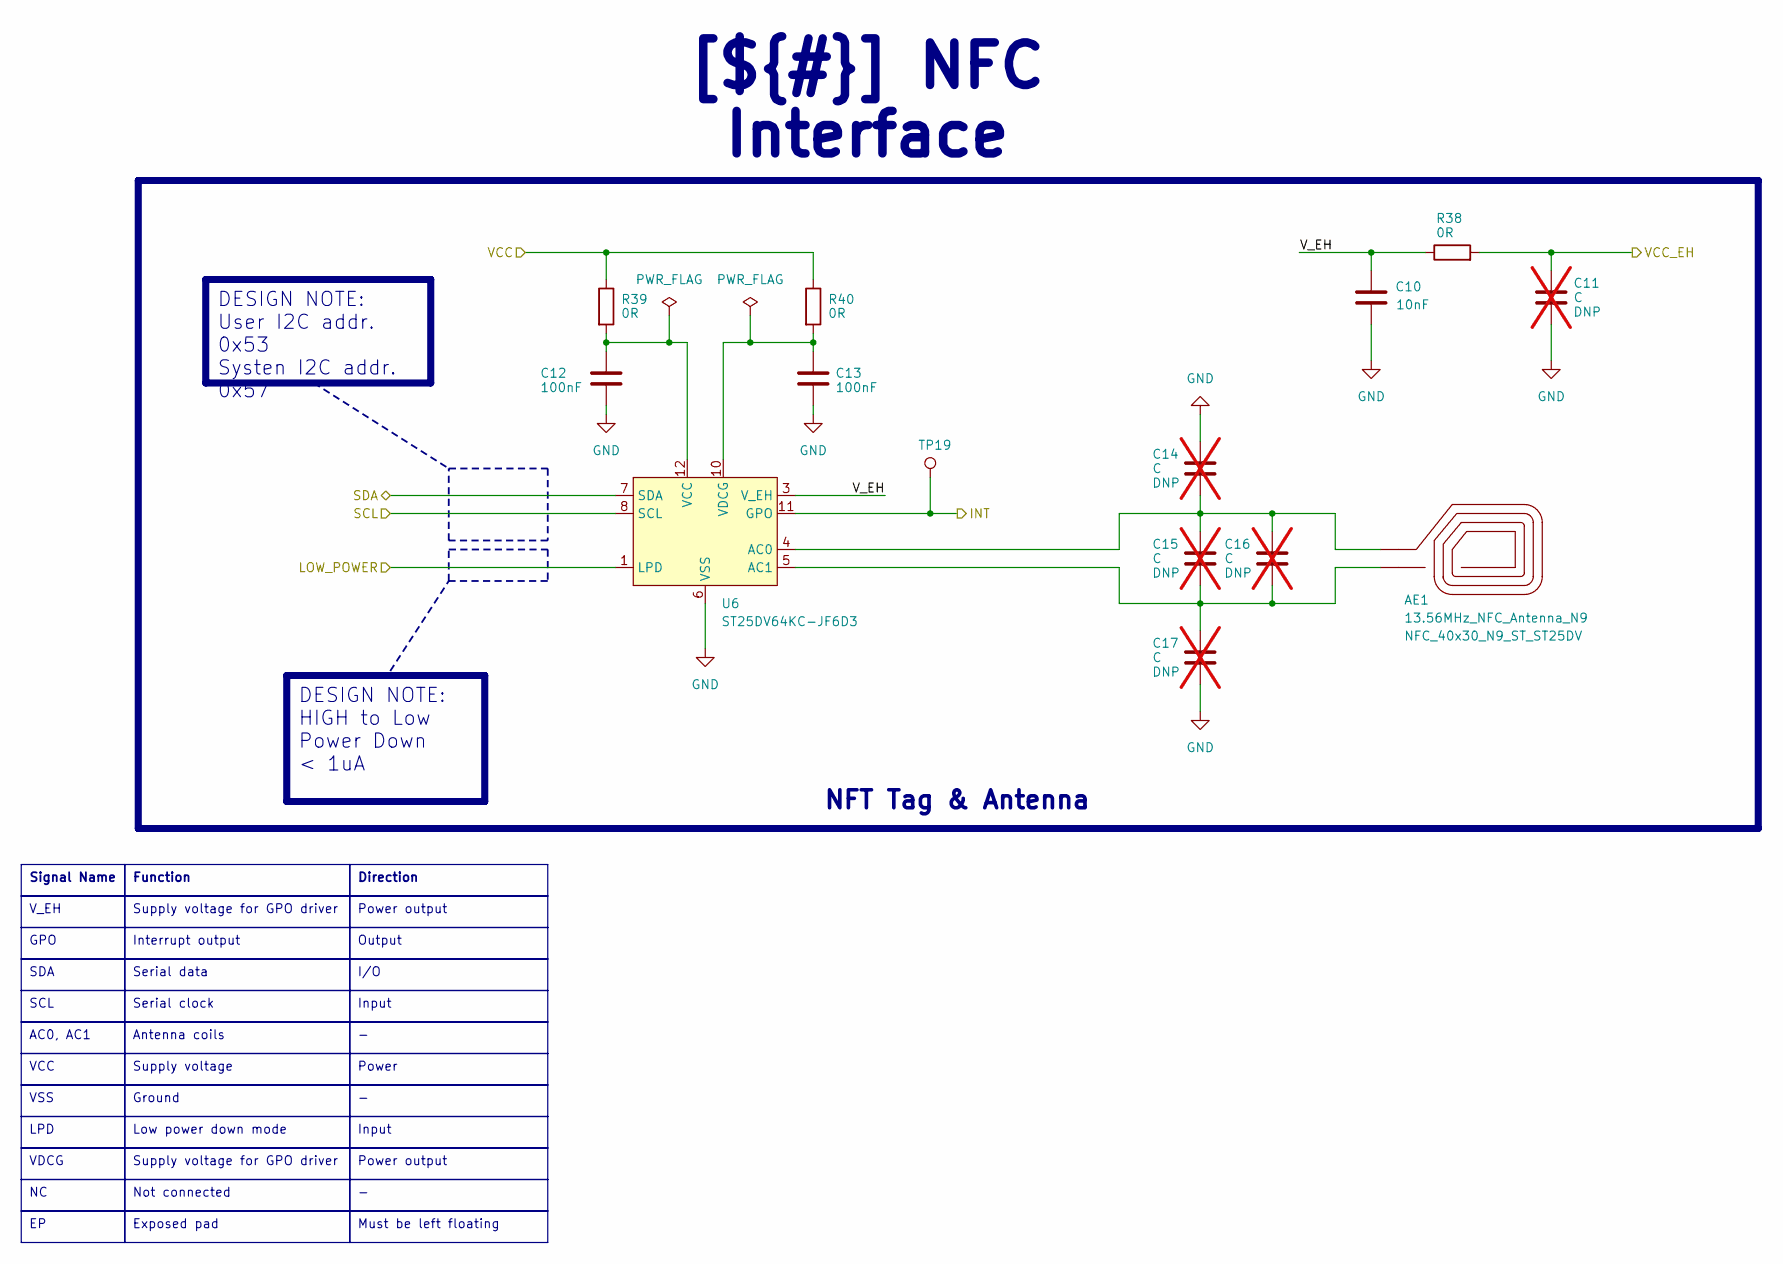
[picture p61: schematic nfc.kicad_sch, NFC Interface]

Parts:
AE1: 13.56MHz_NFC_Antenna_N9; NFC_40x30_N9_ST_ST25DV; Part Number NFC_40x30_N9_ST_ST25DV
C10: 10nF 16V (X7R); C_0402_1005Metric; Tolerance ±10%; Voltage 16V; Part Number C0402_10nF_16V_±10%_X7R
C11, C14, C15, C16, C17: UndefF; C_0402_1005Metric; Part Number C0402_Undef; not fitted
C12, C13: 100nF 16V (X7R); C_0402_1005Metric; Tolerance ±10%; Voltage 16V; Part Number C0402_100nF_16V_±10%_X7R
R38, R39, R40: 0R ±5% 1/16W; R_0402_1005Metric; Part Number R0402_0R_0.1W_±5%
TP19: TP; TestPoint_Pad_D1.0mm; Part Number TP_SMD_D1_0mm
U6: ST25DV64KC-JF6D3; ST_UFDFPN-12-1EP_3x3mm_P0.5mm_EP1.4x2.55mm; Voltage 1.8-5.5 V; Part Number ST25DV64KC-JF6D3

Connections:
/Project Architecture/NFC/V_EH: C10.1, R38.1, U6.3 (V_EH)
/Project Architecture/NFC_INT: TP19.1, U6.11 (GPO); also elsewhere on the board
/Project Architecture/NFC_LOW_PWR: U6.1 (LPD); also elsewhere on the board
/Project Architecture/SCL1: U6.8 (SCL); also elsewhere on the board
/Project Architecture/SDA1: U6.7 (SDA); also elsewhere on the board
GND: C10.2, C11.2, C12.2, C13.2, C14.1, C17.2, U6.6 (VSS); also elsewhere on the board
unnamed: AE1.2 (INNER), C15.2, C16.2, C17.1, U6.5 (AC1)
unnamed: AE1.1 (OUTER), C14.2, C15.1, C16.1, U6.4 (AC0)
unnamed: C12.1, R39.2, U6.12 (VCC)
unnamed: C13.1, R40.2, U6.10 (VDCG)
VCC: R39.1, R40.1; also elsewhere on the board
VCC_EH: C11.1, R38.2; also elsewhere on the board

Notes on the sheet:
GPO
Input
Exposed pad
Power output
VDCG
LPD
DESIGN NOTE: User I2C addr. 0x53 Systen I2C addr. 0x57
Serial clock
V_EH
VCC
Interrupt output
Ground
Supply voltage for GPO driver
VSS
Signal Name
Function
Supply voltage
I/O
Output
Not connected
Serial data
SCL
DESIGN NOTE: HIGH to Low Power Down < 1uA
Power
SDA
AC0, AC1
[${#}] ${TITLE}
Low power down mode
NFT Tag & Antenna
Must be left floating
Antenna coils
Direction
