AntonioMR/tessera-hw/tessera.kicad_pcb

## KiCad design tessera.kicad_pcb (continued)

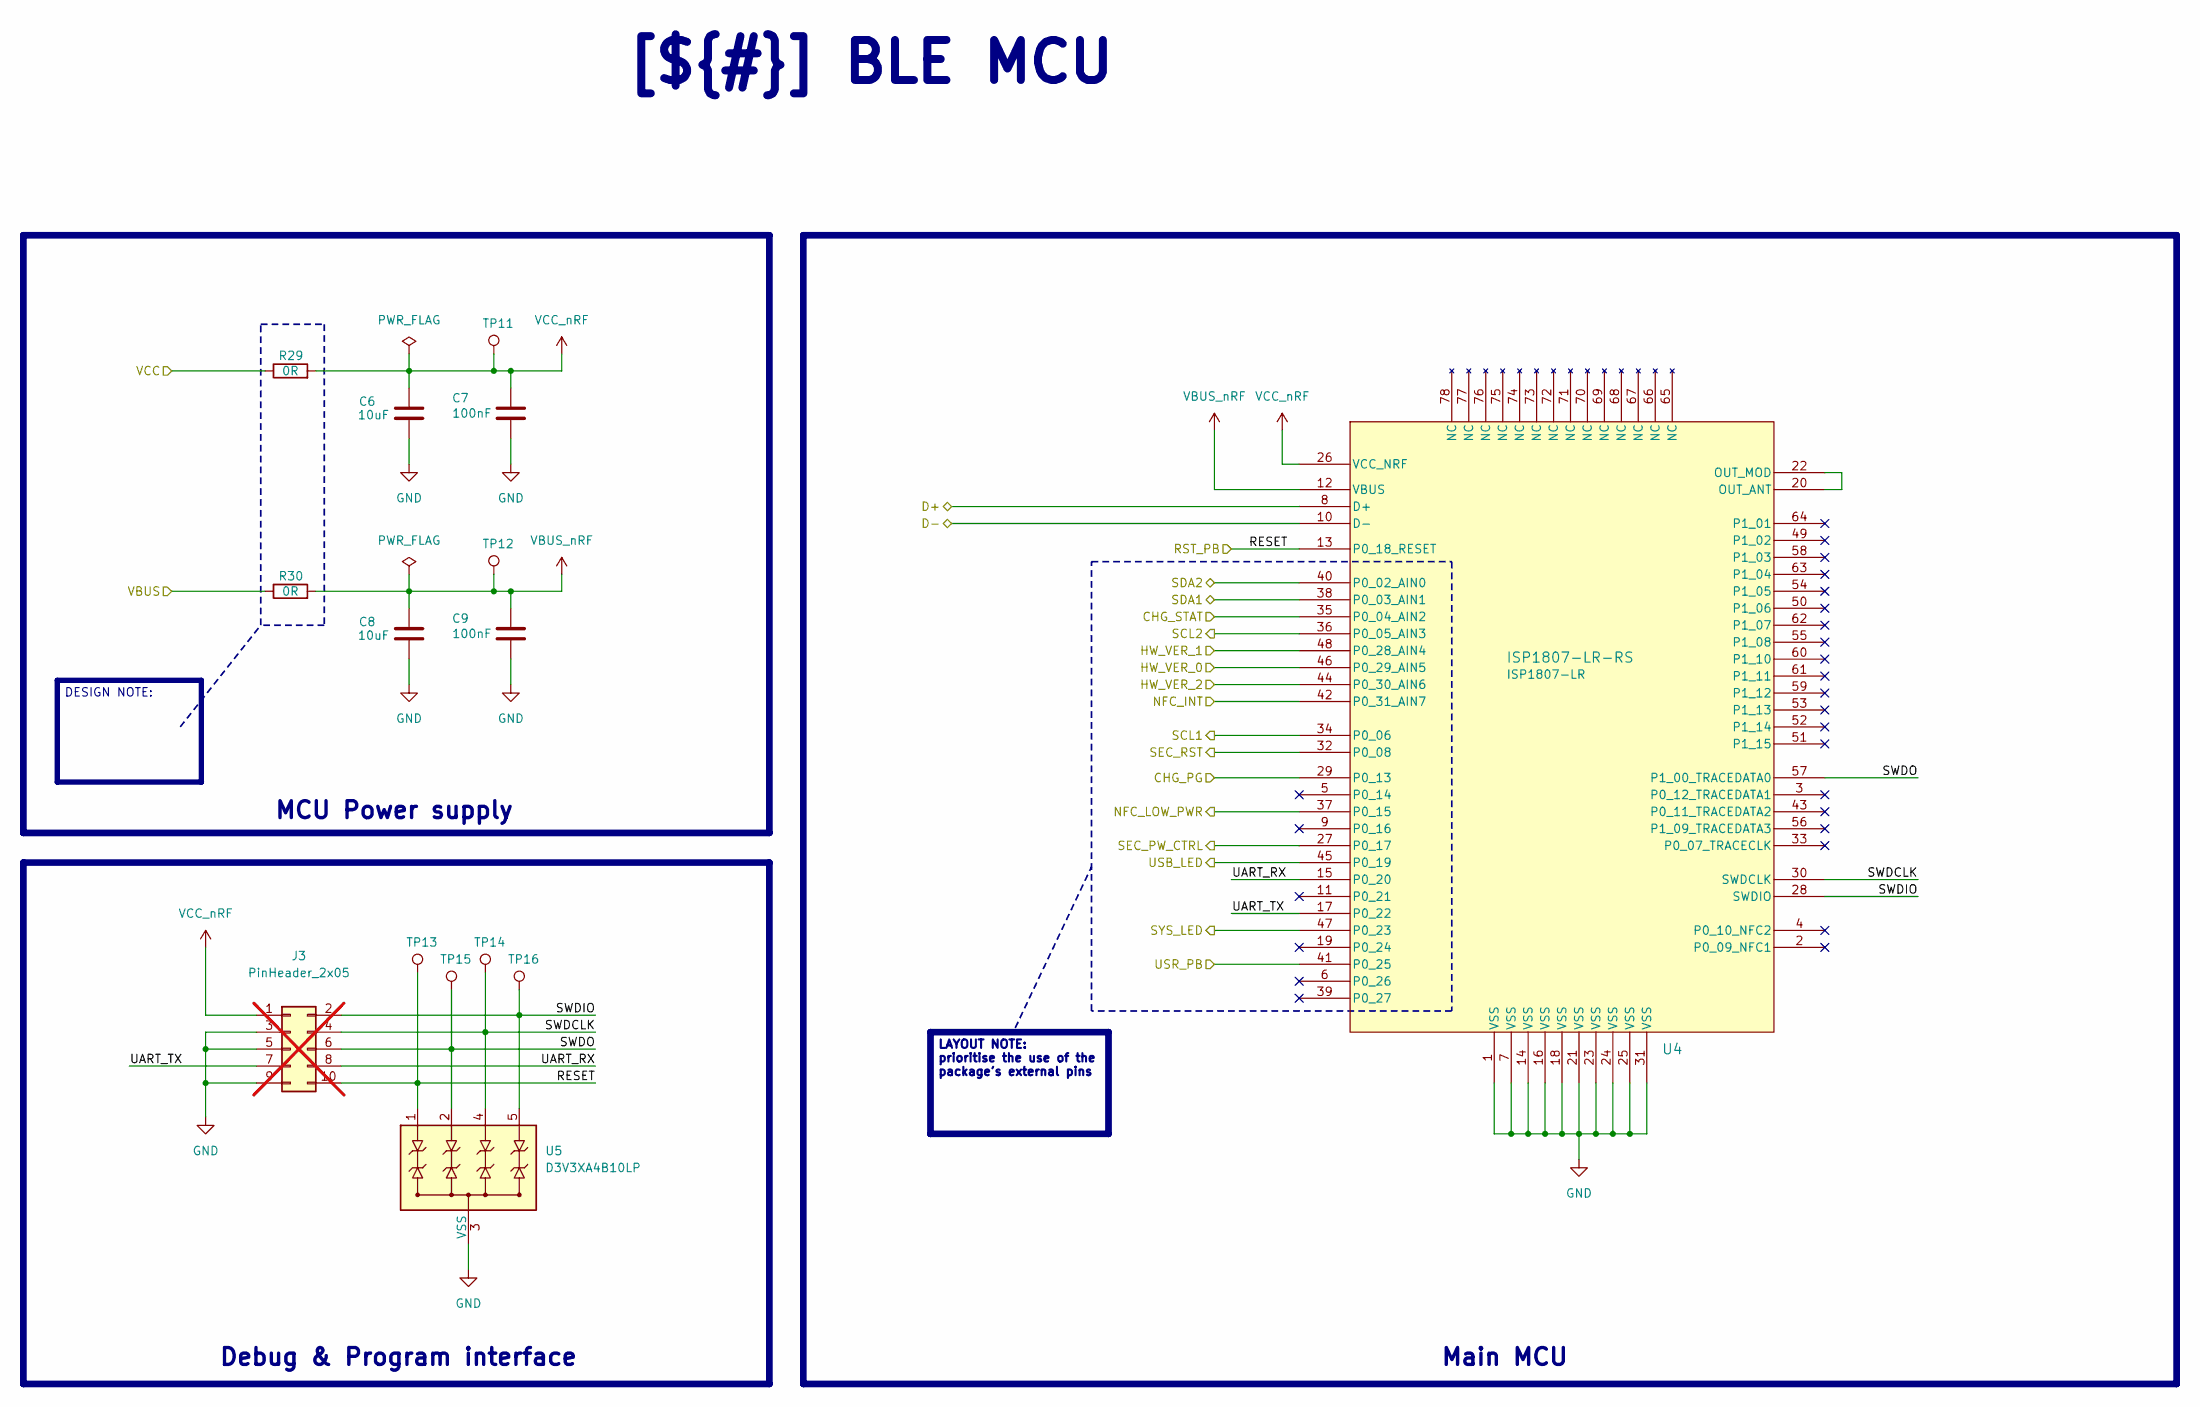
[picture p62: schematic mcu.kicad_sch, BLE MCU]

Parts:
C6, C8: 10uF 10V (X7R); C_0805_2012Metric; Tolerance ±10%; Voltage 10V; Part Number C0805_10uF_10V_±10%_X7R
C7, C9: 100nF 16V (X7R); C_0402_1005Metric; Tolerance ±10%; Voltage 16V; Part Number C0402_100nF_16V_±10%_X7R
J3: PinHeader_2x05; PinHeader_2x05_P1.27mm_Vertical_SMD_TRH; Voltage 200VAC; Part Number PinHeader_2x05_P1.27mm_Vertical_SMD; not fitted
R29, R30: 0R ±5% 1/16W; R_0402_1005Metric; Part Number R0402_0R_0.1W_±5%
TP11, TP12, TP13, TP14, TP15, TP16: TP; TestPoint_Pad_D1.0mm; Part Number TP_SMD_D1_0mm
U4: ISP1807-LR-RS; ISP1807-LR; Voltage 1.7-5.5 V; Part Number ISP1807-LR
U5: D3V3XA4B10LP; Diodes_UDFN-10_1.0x2.5mm_P0.5mm; Part Number D3V3XA4B10LP

Connections:
/Project Architecture/CHG_PG: U4.29 (P0_13); also elsewhere on the board
/Project Architecture/CHG_STAT: U4.35 (P0_04_AIN2); also elsewhere on the board
/Project Architecture/D+: U4.8 (D+); also elsewhere on the board
/Project Architecture/D-: U4.10 (D-); also elsewhere on the board
/Project Architecture/HW_VER_0: U4.46 (P0_29_AIN5); also elsewhere on the board
/Project Architecture/HW_VER_1: U4.48 (P0_28_AIN4); also elsewhere on the board
/Project Architecture/HW_VER_2: U4.44 (P0_30_AIN6); also elsewhere on the board
/Project Architecture/MCU/SWDCLK: J3.4, TP14.1, U4.30 (SWDCLK), U5.4, U5.7
/Project Architecture/MCU/SWDIO: J3.2, TP16.1, U4.28 (SWDIO), U5.5, U5.6
/Project Architecture/MCU/SWDO: J3.6, TP15.1, U4.57 (P1_00_TRACEDATA0), U5.2, U5.9
/Project Architecture/MCU/UART_RX: J3.8, U4.15 (P0_20)
/Project Architecture/MCU/UART_TX: J3.7, U4.17 (P0_22)
/Project Architecture/NFC_INT: U4.42 (P0_31_AIN7); also elsewhere on the board
/Project Architecture/NFC_LOW_PWR: U4.37 (P0_15); also elsewhere on the board
/Project Architecture/RST_PB: J3.10, TP13.1, U4.13 (P0_18_RESET), U5.1, U5.10; also elsewhere on the board
/Project Architecture/SCL1: U4.34 (P0_06); also elsewhere on the board
/Project Architecture/SCL2: U4.36 (P0_05_AIN3); also elsewhere on the board
/Project Architecture/SDA1: U4.38 (P0_03_AIN1); also elsewhere on the board
/Project Architecture/SDA2: U4.40 (P0_02_AIN0); also elsewhere on the board
/Project Architecture/SEC_PW_CTRL: U4.27 (P0_17); also elsewhere on the board
/Project Architecture/SEC_RST: U4.32 (P0_08); also elsewhere on the board
/Project Architecture/SYS_LED: U4.47 (P0_23); also elsewhere on the board
/Project Architecture/USB_LED: U4.45 (P0_19); also elsewhere on the board
/Project Architecture/USR_PB: U4.41 (P0_25); also elsewhere on the board
GND: C6.2, C7.2, C8.2, C9.2, J3.3, J3.5, J3.9, U4.1 (VSS), U4.7 (VSS), U4.14 (VSS), U4.16 (VSS), U4.18 (VSS), U4.21 (VSS), U4.23 (VSS), U4.24 (VSS), U4.25 (VSS), U4.31 (VSS), U5.3 (VSS), U5.8 (VSS); also elsewhere on the board
unnamed: U4.20 (OUT_ANT), U4.22 (OUT_MOD)
VBUS: R30.1; also elsewhere on the board
VBUS_nRF: C8.1, C9.1, R30.2, TP12.1, U4.12 (VBUS)
VCC: R29.1; also elsewhere on the board
VCC_nRF: C6.1, C7.1, J3.1, R29.2, TP11.1, U4.26 (VCC_NRF)

Notes on the sheet:
Debug & Program interface
DESIGN NOTE:
MCU Power supply
Main MCU
LAYOUT NOTE: prioritise the use of the package's external pins
[${#}] ${TITLE}

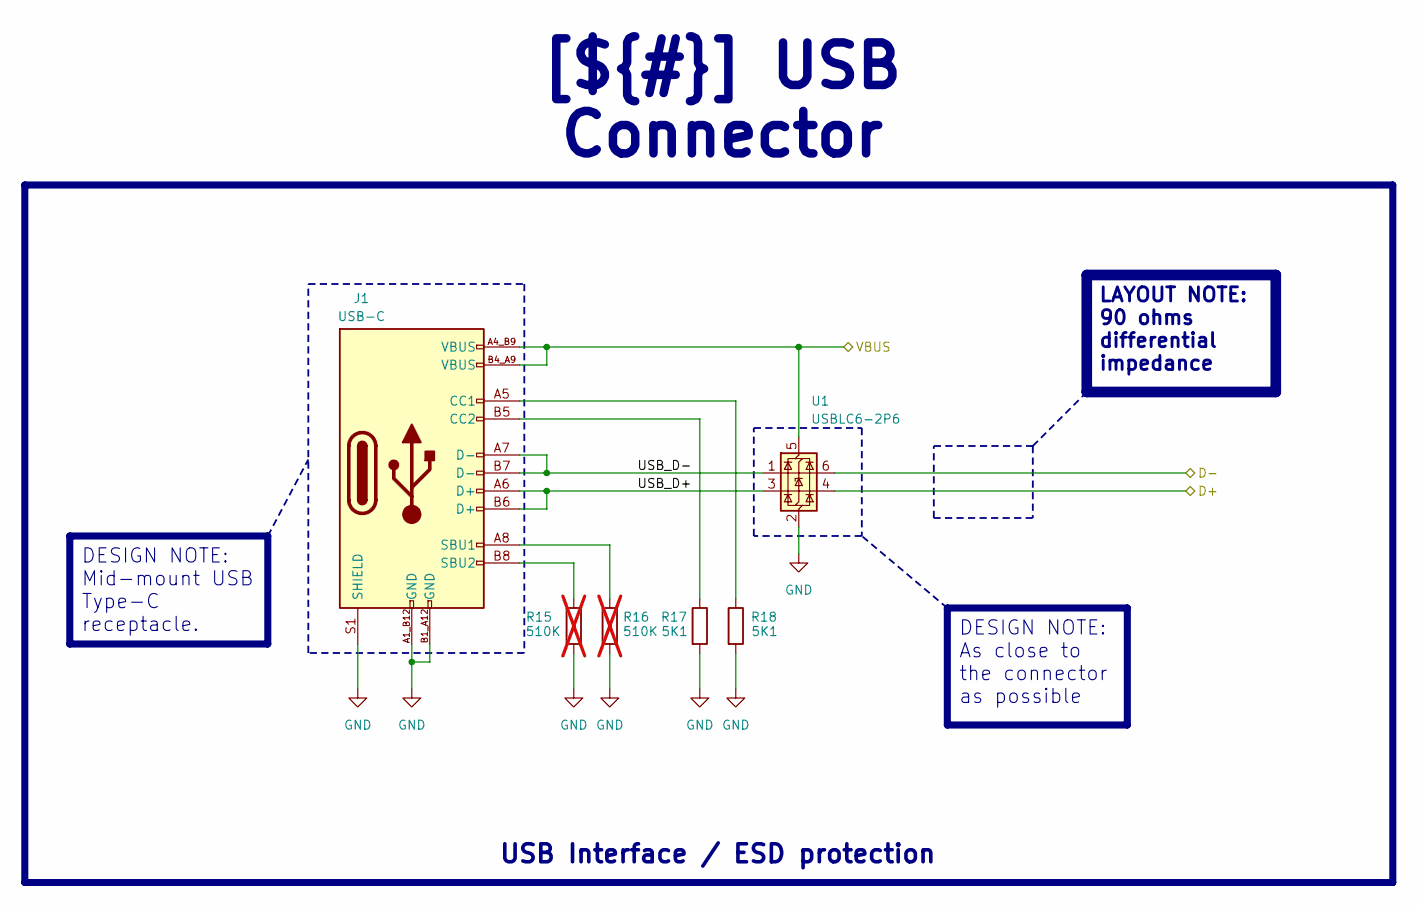
[picture p63: schematic USB_Conn.kicad_sch, USB Connector]

Parts:
J1: USB-C; GCT_USB4520-03-1-A_REVA; Voltage 48VDC; Part Number USB4520-03-1-A_REVA
R15, R16: 510 kOhms; R_0402_1005Metric; Tolerance ±1%; Part Number R0402_510K_0.063W_±1%; not fitted
R17, R18: 5.1 kOhms; R_0402_1005Metric; Tolerance ±1%; Part Number R0402_5K1_0.063W_±1%
U1: USBLC6-2P6; SOT-666; Part Number USBLC6-2P6

Connections:
/Project Architecture/D+: U1.4 (I/O2); also elsewhere on the board
/Project Architecture/D-: U1.6 (I/O1); also elsewhere on the board
/Project Architecture/USB/USB_D+: J1.A6 (D+), J1.B6 (D+), U1.3 (I/O2)
/Project Architecture/USB/USB_D-: J1.A7 (D-), J1.B7 (D-), U1.1 (I/O1)
GND: J1.A1_B12 (GND), J1.B1_A12 (GND), J1.S1 (SHIELD), J1.S2 (SHIELD), J1.S3 (SHIELD), J1.S4 (SHIELD), R15.2, R16.2, R17.2, R18.2, U1.2 (GND); also elsewhere on the board
unnamed: J1.A5 (CC1), R18.1
unnamed: J1.B5 (CC2), R17.1
unnamed: J1.A8 (SBU1), R16.1
unnamed: J1.B8 (SBU2), R15.1
VBUS: J1.A4_B9 (VBUS), J1.B4_A9 (VBUS), U1.5 (VBUS); also elsewhere on the board

Notes on the sheet:
USB Interface / ESD protection
DESIGN NOTE: Mid-mount USB Type-C receptacle.
LAYOUT NOTE: 90 ohms differential impedance
[${#}] ${TITLE}
DESIGN NOTE: As close to the connector as possible

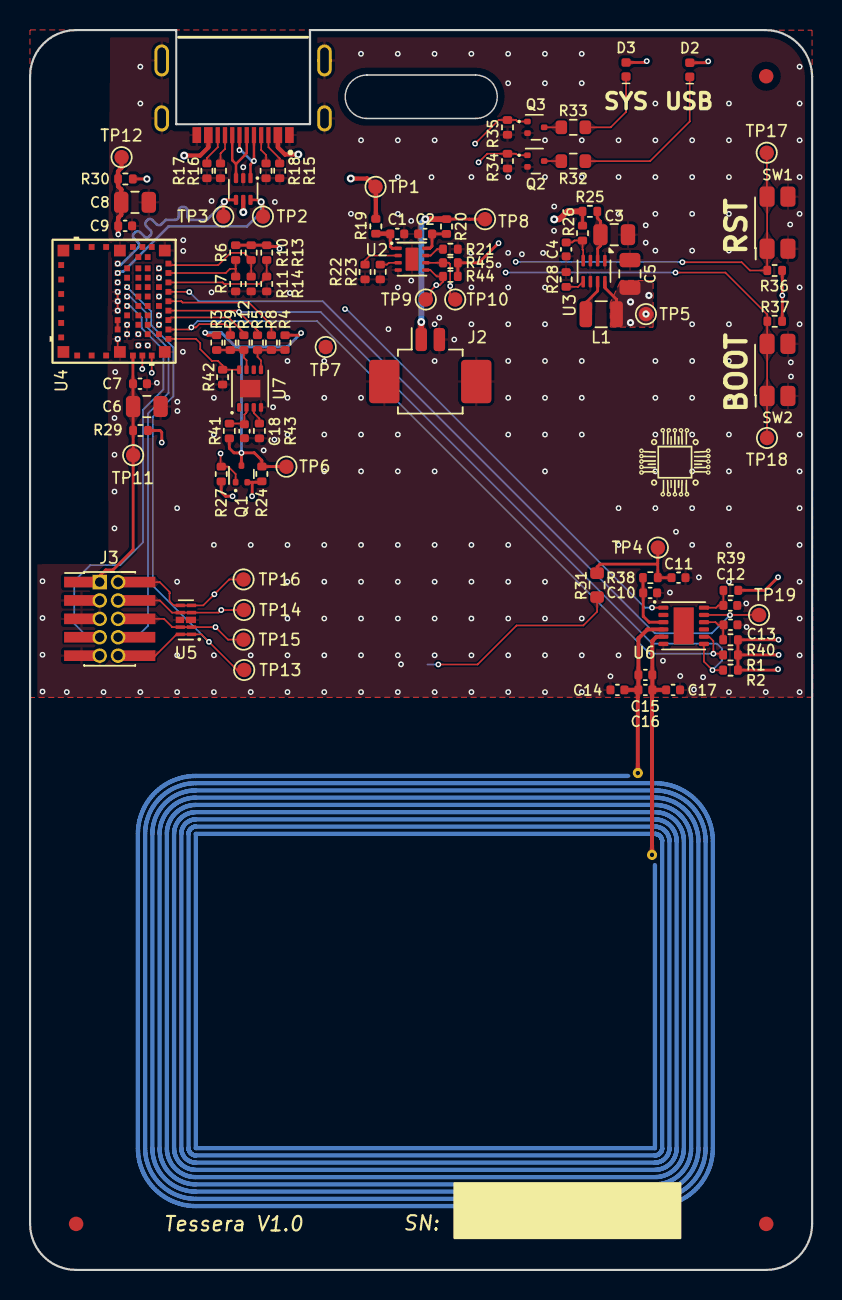
[picture p64: board tessera.kicad_pcb from above]

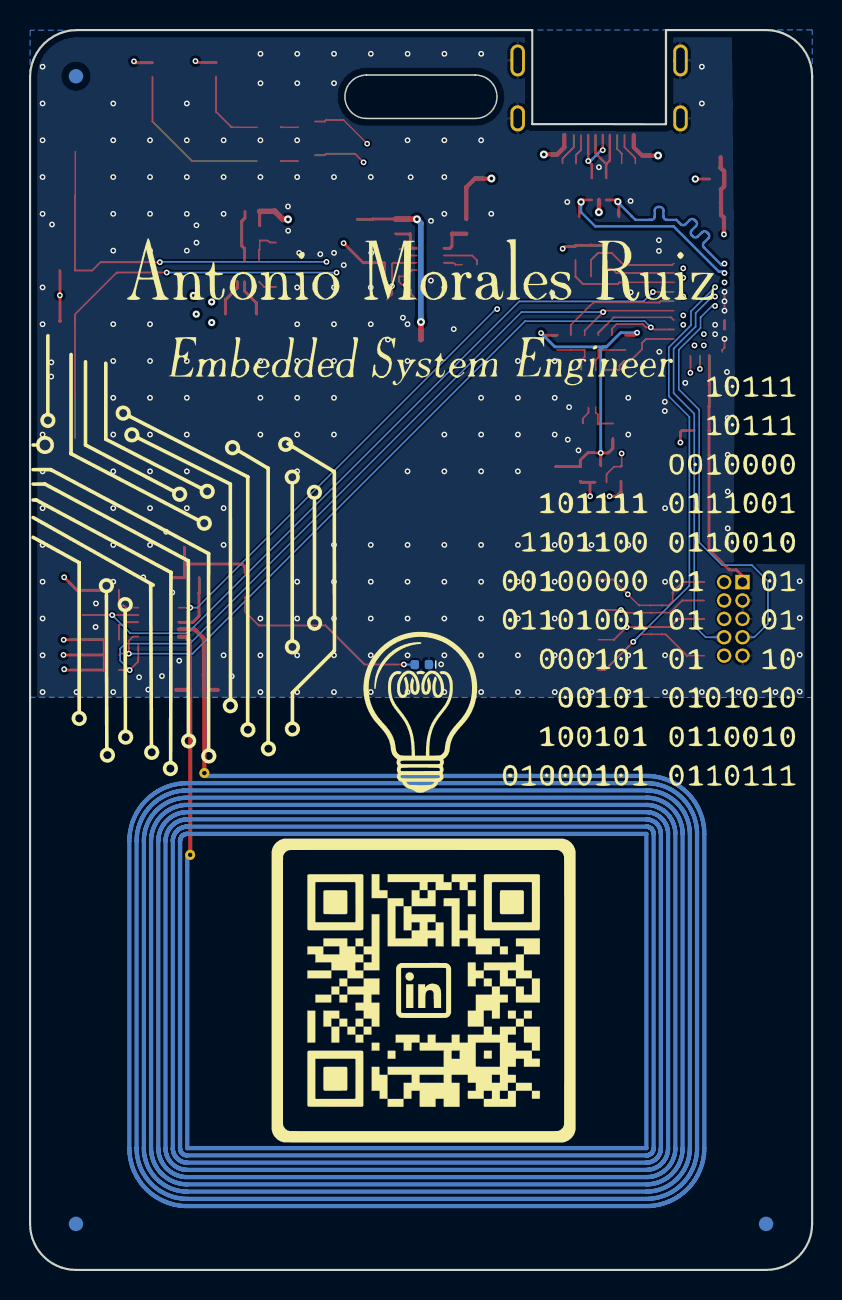
[picture p65: board tessera.kicad_pcb from below]

Board: 4 copper layers, 54.0 x 85.6 mm, 113 parts (9 on the bottom side), 62 nets.
