AntonioMR/tessera-hw/(commit log)

2026-08-23 feat: track initial KiCad project and KiBot CI/CD pipeline
    - Add the KDT_Hierarchical_KiBot template scaffolding: schematics,
    tessera.kicad_pro/pcb/dru/prl, worksheet Templates/, Logos/,
    CHANGELOG.md, README.md and LICENSE
    - Register lib/ as a git submodule (kicad_lib.git) providing the
    symbol/footprint libraries and component catalog
    - Add sym-lib-table and fp-lib-table wiring the project to lib/lib_sym
    and lib/lib_fp (Capacitor_SMD.pretty, Resistor_SMD.pretty)
    - Add the KiBot build pipeline: kibot_launch.sh, kibot_yaml/ configs,
    kibot_resources/ (fonts, colors, scripts, report templates) and the
    GitHub Actions CI workflow (.github/workflows/ci.yaml)
    - Replace the generic KiCad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
    [Block Diagram.kicad_sch, Power - Sequencing.kicad_sch, Project Architecture.kicad_sch, Revision History.kicad_sch, Section A - Title A.kicad_sch, Section B - TItle B.kicad_sch, tessera.kicad_pcb, tessera.kicad_sch]
2026-08-24 Update Outputs
    [tessera-bom.csv]
2026-08-26 chore(hw): bump lib submodule and register new component libraries
    Bump the `lib` submodule to pull in the newly reviewed component
    entries (symbols, footprints, 3D models) and register the new
    libraries in the project's library tables so they're selectable.
    - sym-lib-table: add `IC_RF`
    - fp-lib-table: add `Connector_USB`, `Packages_DFN_QFN`, `MCU`
2026-09-14 feat(sch): preliminary Tessera Badge schematic
    - Add sheets for LEDs, USB connector, MCU, NFC, power and STSAFE-A120.
    - Drop the old placeholder sections.
    - Bump the lib submodule and add IPN as a BOM column in the kibot
    outputs to reflect the DB-library parts now placed in the schematic.
    [Block Diagram.kicad_sch, Leds.kicad_sch, Power - Sequencing.kicad_sch, Project Architecture.kicad_sch, Revision History.kicad_sch, Section A - Title A.kicad_sch, Section B - TItle B.kicad_sch, USB_Conn.kicad_sch]
2026-09-27 fix(hardware): replace jumper/passive footprints with 0402 and refine schematics
    - Replace 0-ohm jumper resistors with 0402 package equivalents
    - Reduce package size on several capacitors
    - Correct and simplify several schematic symbols (replaced with
    simplified equivalents where the original was overcomplicated)
    - Bump lib submodule to the updated component library (renamed
    switch footprints, new Conn_01x02_MountingPin symbol, pad/pin
    numbering fixes, approved IPN assignments, Workart artwork library)
    - Register Workart.pretty in fp-lib-table
    - Mark J3 as DNP in mcu.kicad_sch
    - Continue schematic wiring/placement (Leds.kicad_sch, tessera.kicad_sch)
    and PCB routing/placement (tessera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
    [Leds.kicad_sch, Project Architecture.kicad_sch, USB_Conn.kicad_sch, mcu.kicad_sch, nfc.kicad_sch, power.kicad_sch, stsafe120.kicad_sch, tessera.kicad_pcb]
2026-09-28 fix(hardware): disable bottom test-point output and reposition PCB origin
    - Comment out the bottom test-point CSV output and "Bottom Test
    Points" fabrication PDF sheet in kibot_yaml (no test points on the
    bottom side of this board)
    - Move the PCB aux/grid origin to align with the board outline and
    shift the associated drawing-layer markers accordingly
    - Update tessera.kicad_prl with the resulting KiCad UI/layer state
    [tessera.kicad_pcb]
2026-09-29 fix(hardware): resolve KiBot iBoM crash and stale symbol warning
    - Add G1-G5 Workart artwork as schematic symbols marked exclude-from-BOM,
    instead of PCB-only footprints.
    - Works around a KiBot iBoM crash caused by PCB-only footprints having
    no parent sheet in the variant netlist (upstream: INTI-CMNB/KiBot#955)
    - Register the Workart.kicad_sym library in sym-lib-table
    - Bump lib submodule to add the matching Workart schematic symbols
    - Fix W043 warning: remove stale lib_name override for J2 in
    power.kicad_sch
    - CI: checkout submodules recursively and regenerate catalog.sqlite
    from lib_db/source/*.csv (lib/lib_db/build_db.py) so the "catalog"
    database library resolves during CI run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
    [Project Architecture.kicad_sch, power.kicad_sch, tessera.kicad_pcb]
2026-09-30 fix(ci): use HTTPS URL for lib submodule
    KiBot's KiRI output checks out previous commits as git worktrees and
    runs `git submodule update --init` inside the KiBot container. The SSH
    URL (git@github.com:) cannot be cloned there: actions/checkout only
    rewrites it to HTTPS in a temporary global config that the container
    does not see.
    kicad_lib is public, so switch .gitmodules to the HTTPS URL. Existing
    local clones keep their own SSH remote for pushing.
2026-09-30 feat(hardware): add board logo, per-side assembly tables
    - Bump lib submodule: fix mismatched drill diameters on the two
    THT pads of the NFC_40x30_N9_ST_ST25DV footprint
    - Embed the APS logo image on every schematic sheet's title block
    - Move the impedance-controlled differential pair from L1/L2 to
    L4/L3 and update its target to 90 Ω in the impedance table
    - KiBot: add per-side (top/bottom) CSV position tables and wire them
    into the assembly PDF as pick & place tables
    [Block Diagram.kicad_sch, Leds.kicad_sch, Project Architecture.kicad_sch, Revision History.kicad_sch, USB_Conn.kicad_sch, mcu.kicad_sch, nfc.kicad_sch, power.kicad_sch]
2026-10-01 feat(hardware): add logo to PCB sheet and README, fix assembly P&P tables
    - Embed the board logo as a bitmap in the PCB drawing sheet template
    (KDT_Template_PCB_GIT_A4.kicad_wks).
    - Assembly PDF: force the pick & place table font width to 1.27 mm and
    add vertical/top/bottom rules.
    - Assembly PDF: set mirror_pcb_text on the Bottom Assembly page so the
    bottom pick & place table reads left to right on the mirrored page.
    [tessera.kicad_pcb]
2026-10-03 fix(hardware): tighten PCB edge clearance and diff-pair rules, update logo
    - Bump lib submodule: assign IPNs to another batch of approved
    capacitor selections
    - Update the embedded logo artwork on every schematic sheet to the
    new Logos/logo.png
    - Increase min_copper_edge_clearance to 0.5mm and raise net class
    clearance/spacing to match
    - Replace the generic outer/inner-layer trace width & spacing rules
    with a dedicated "USB Diff Pair clearance to other nets" rule
    (0.2023mm, excluding intra-pair spacing already governed by the
    netclass diff_pair_gap)
    - Add DRC exclusions for pre-existing clearance/copper-edge/solder-
    mask-bridge items surfaced by the tightened edge-clearance rul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
    [Block Diagram.kicad_sch, Leds.kicad_sch, Project Architecture.kicad_sch, Revision History.kicad_sch, USB_Conn.kicad_sch, mcu.kicad_sch, nfc.kicad_sch, power.kicad_sch]
2026-10-03 feat(hardware): add fiducial markers on bottom layer, add via stich and teardrops
    - Add FIDUCIAL_D1_0mm_Mask_2_0mm reference marks to Project
    Architecture.kicad_sch and place the corresponding
    Fiducial_1mm_Mask2mm footprints on the PCB (for pick & place
    alignment)
    - Added via stiching network
    - Added teardrops
    [Project Architecture.kicad_sch, tessera.kicad_pcb]
2026-10-10 feat(hardware): route debug UART to J3 and add charger status pull-ups
    Exposes a spare UART on the SWD header for firmware logging and adds
    external pull-ups to the BQ25170 open-drain status outputs.
    - Route P0.22 (UART_TX) to J3 pin 7 and P0.20 (UART_RX) to J3 pin 8.
    - Add R44/R45 100k pull-ups to VCC on CHG_STAT and CHG_PG.
    - Update PCB placement and routing for the new nets.
    - Bump lib submodule (new THT test point footprint).
    [Block Diagram.kicad_sch, Leds.kicad_sch, Project Architecture.kicad_sch, Revision History.kicad_sch, USB_Conn.kicad_sch, mcu.kicad_sch, nfc.kicad_sch, power.kicad_sch]
2026-10-26 fix(hardware): mirror secure element power switch
    - Mirror Q1
    - Change R42 to pull-down
    - Fix some overlapping graphics
    [Block Diagram.kicad_sch, Leds.kicad_sch, Project Architecture.kicad_sch, Revision History.kicad_sch, USB_Conn.kicad_sch, mcu.kicad_sch, nfc.kicad_sch, power.kicad_sch]
